TESScience/FPE/README.md

Focal Plane Electronics for TESS
--------------------------------

© 2015 John P. Doty &amp; Matthew P. Wampler-Doty, Noqsi Aerospace Ltd.



This project contains the design specification for the focal plane electronics for the [Transiting Exoplanet Survey Satellite (TESS)](http://space.mit.edu/TESS/TESS/TESS_Overview.html).

Documentation
-------------

You can read the latest documentation on our GitHub wiki:

[https://github.com/TESScience/FPE/wiki](https://github.com/TESScience/tessfpe/wiki)

This includes software tutorials and engineering manuals.

Provided that you have LaTeX, gschem and spice installed, you can reproduce the engineer manual by typing:

```bash
make manual
```
