TESScience/FPE/FPE/Simulation/Annex/README

Keep hacked simulation versions of schematics here.
