TESScience/FPE/FPE/Schematic/CCD-51pin.txt

# Connector for flexprint
#
#	Pin	Net	Name

J1	1	Backside-1	case
J1	2	IG1-1	IG1
J1	3	IG2-1	IG2	
J1	4	P1-OR-1	S1CD
J1	5	P2-OR-1	S2CD
J1	6	P3-OR-1	S3CD
J1	7	P1-U-1	S1U
J1	8	P2-U-1	S2U
J1	9	P3-U-1	S3U
# J1	10	nc
# J1	11	nc
# J1	12	nc
J1	13	P3-IA-1	IA3
J1	14	P2-IA-1	IA2
J1	15	P1-IA-1	IA1
# J1	16	nc
# J1	17	nc
# J1	18	nc
J1	19	GND	CS
J1	20	P3-OR-1	S3AB
J1	21	P2-OR-1	S2AB
J1	22	P1-OR-1	S1AB
J1	23	P3-FS-1	FS3
J1	24	P2-FS-1	FS2
J1	25	P1-FS-1	FS1
J1	26	VSUB-1	SUB
J1	27	ID-1	ID
J1	28	GND	RETD
J1	29	OG-D-1	OGD
J1	30	DR-D-1	DRD
J1	31	OUT-D-1	OSD
J1	32	GND	RTD78
J1	33	CuS-1	RTD56
J1	34	RD-1	RD
J1	35	OUT-C-1	OSC
J1	36	DR-C-1	DRC
J1	37	OG-C-1	OGC
J1	38	GND	RETC
J1	39	SCP-1	SCP
J1	40	GND	RETB
J1	41	OG-B-1	OGB
J1	42	DR-B-1	DRB
J1	43	OUT-B-1	OSB
J1	44	RG-1	RG
J1	45	CuS-1	RTD34	
J1	46	CuRTD-1	RTD12
J1	47	OUT-A-1	OSA
J1	48	DR-A-1	DRA
J1	49	OG-A-1	OGA
J1	50	GND	RETA
J1	51	SCP-1	USD
