TESScience/FPE/Releases/FPE-6.2-RR1/Interface.devfiles/chassis.txt

(Device File generated by gEDA Allegro Netlister)
PACKAGE CHASSIS
CLASS DISCRETE
PINCOUNT 1
END
