TESScience/FPE/Releases/FPE-6.1-RR4/Interface.pdf

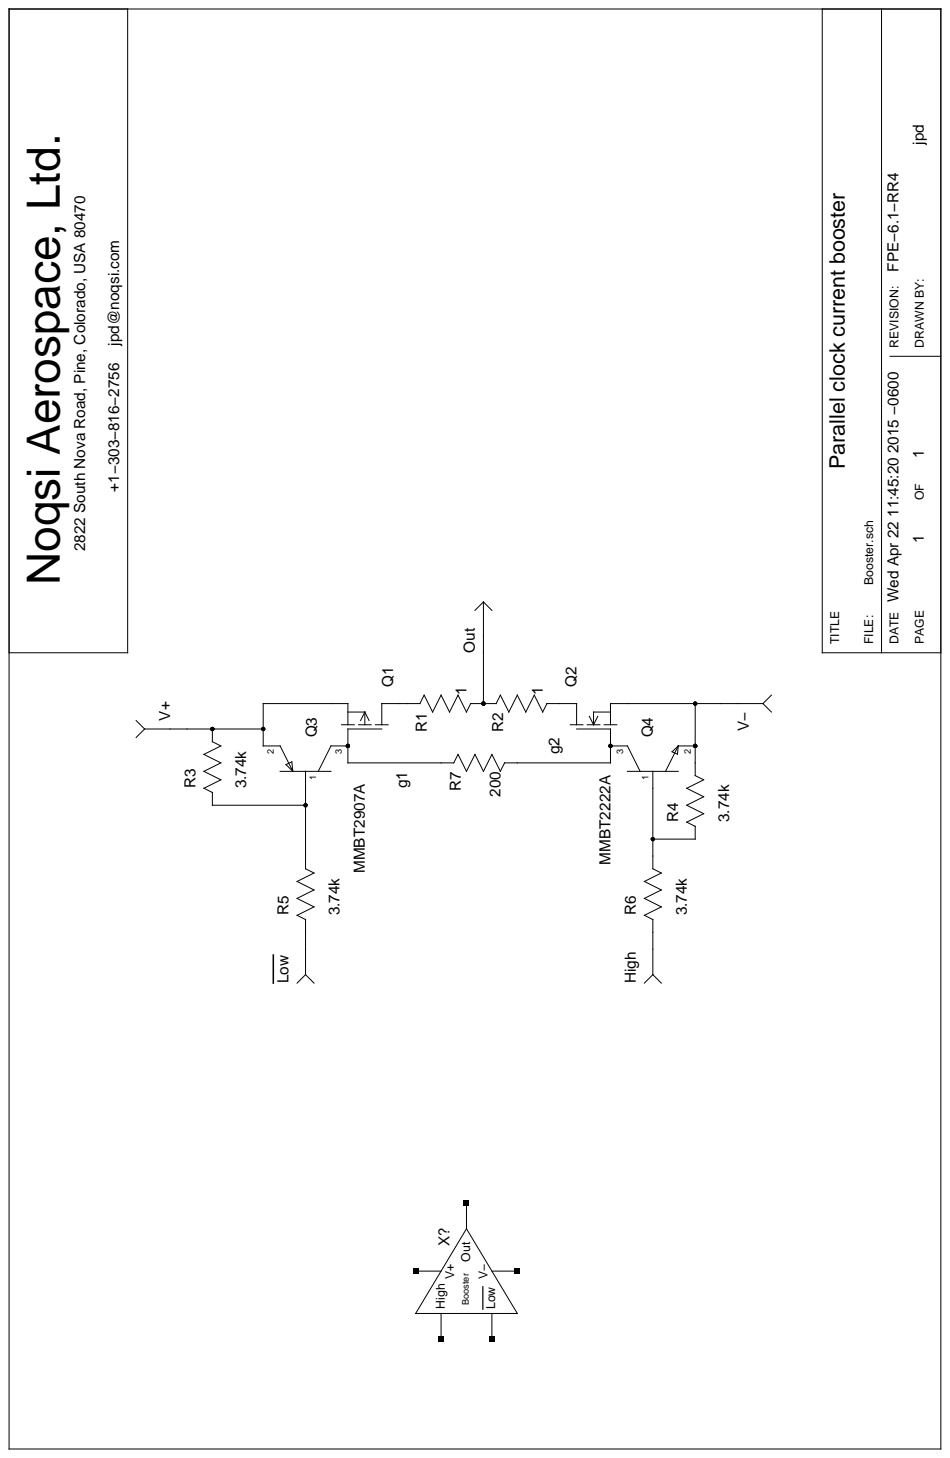
[picture p115: page 1]

2822 South Nova Road, Pine, Colorado, USA 80470

Parallel clock current booster

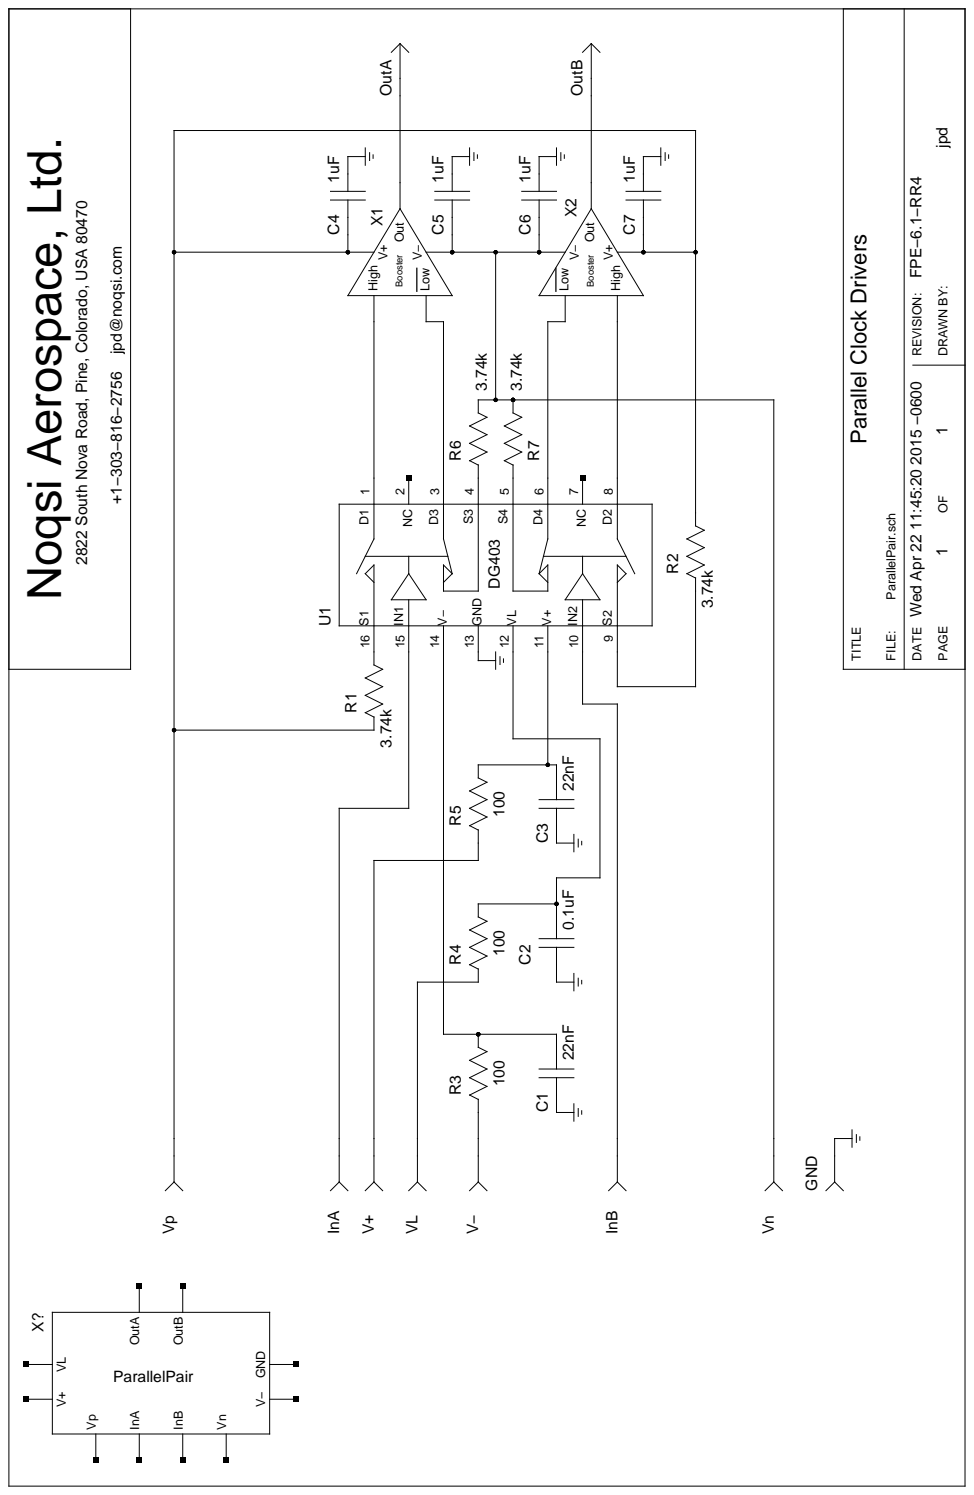
[picture p116: page 2]

2822 South Nova Road, Pine, Colorado, USA 80470

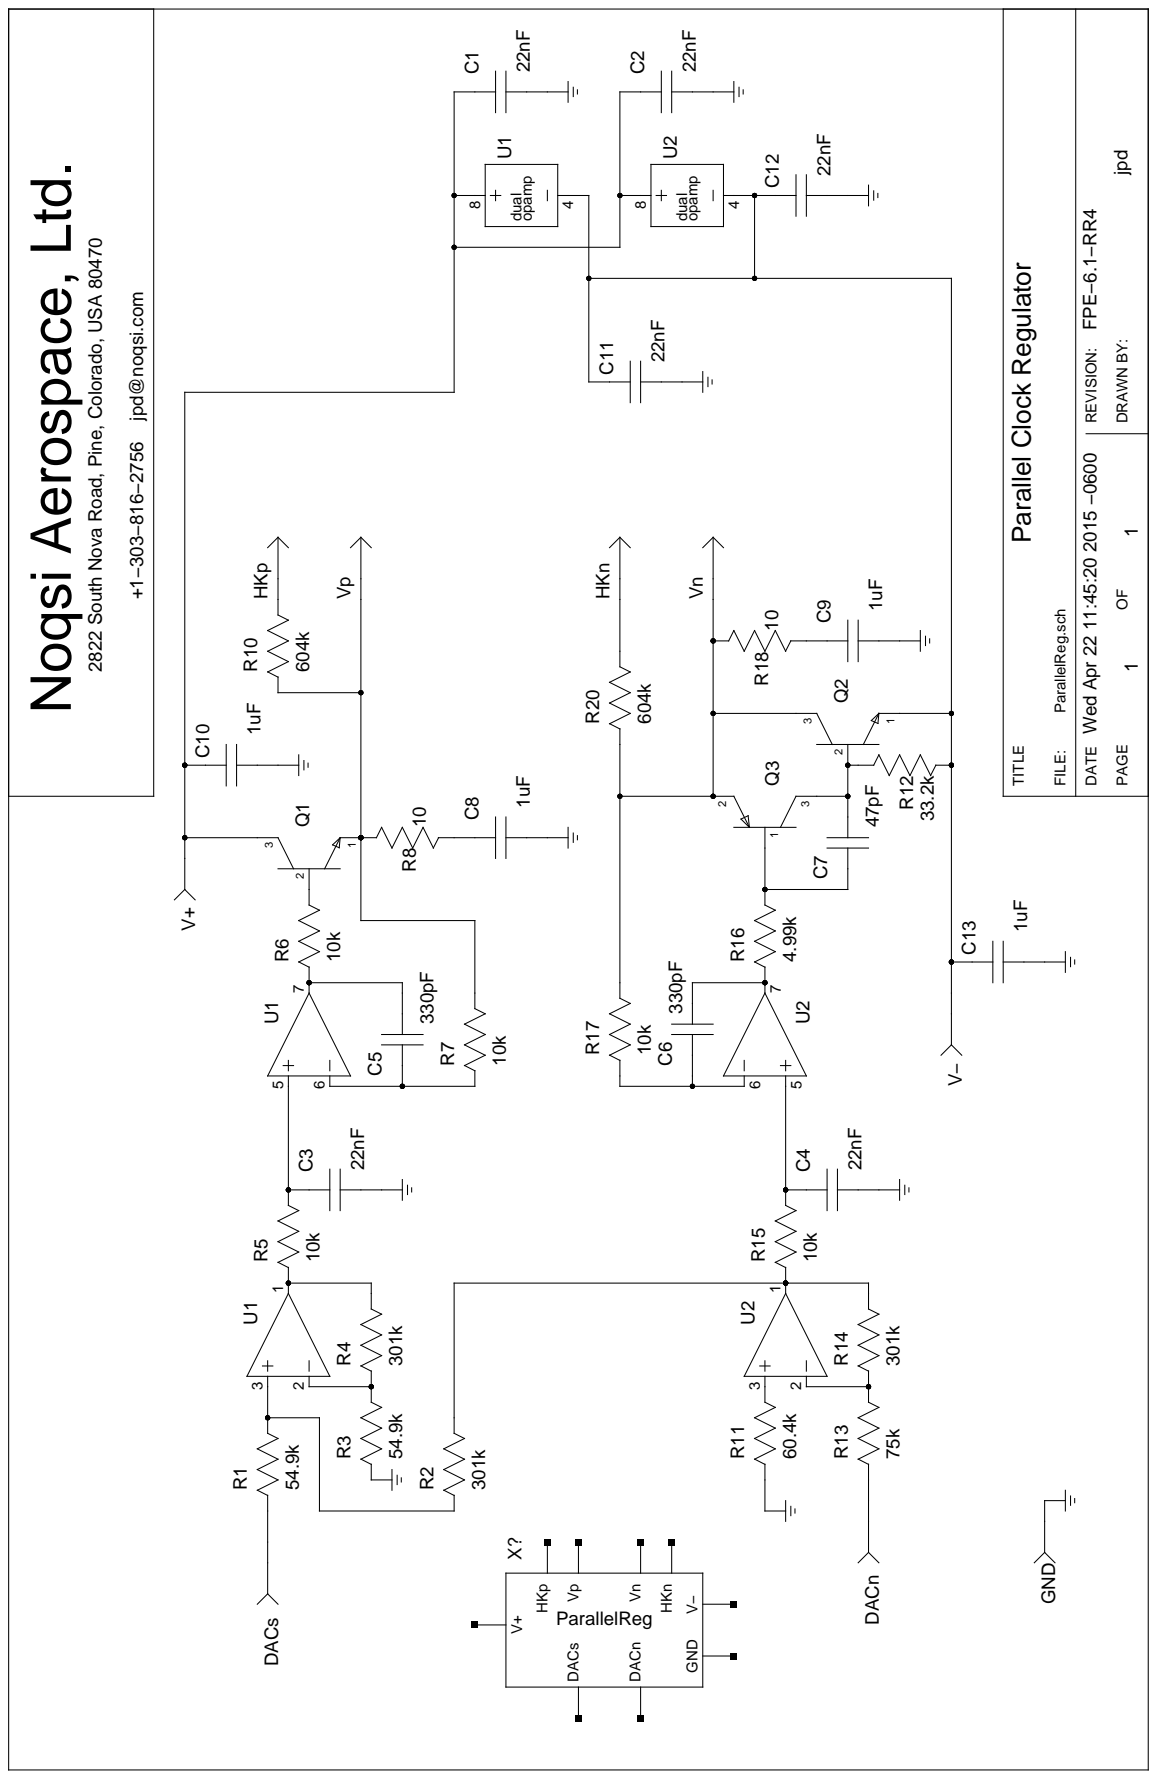
[picture p117: page 3]

2822 South Nova Road, Pine, Colorado, USA 80470

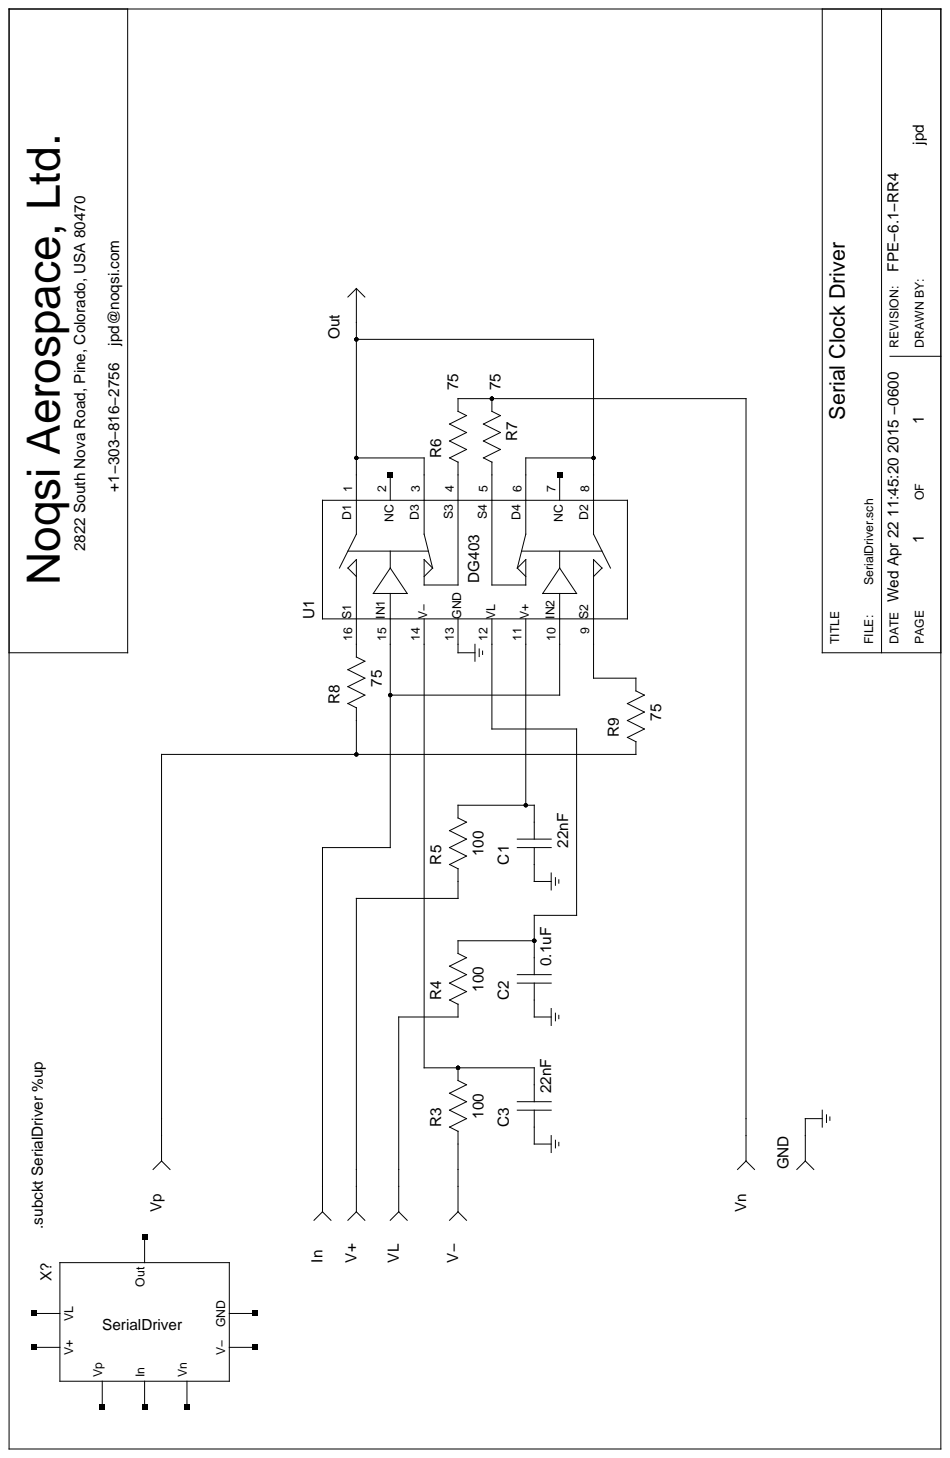
[picture p118: page 4]

2822 South Nova Road, Pine, Colorado, USA 80470

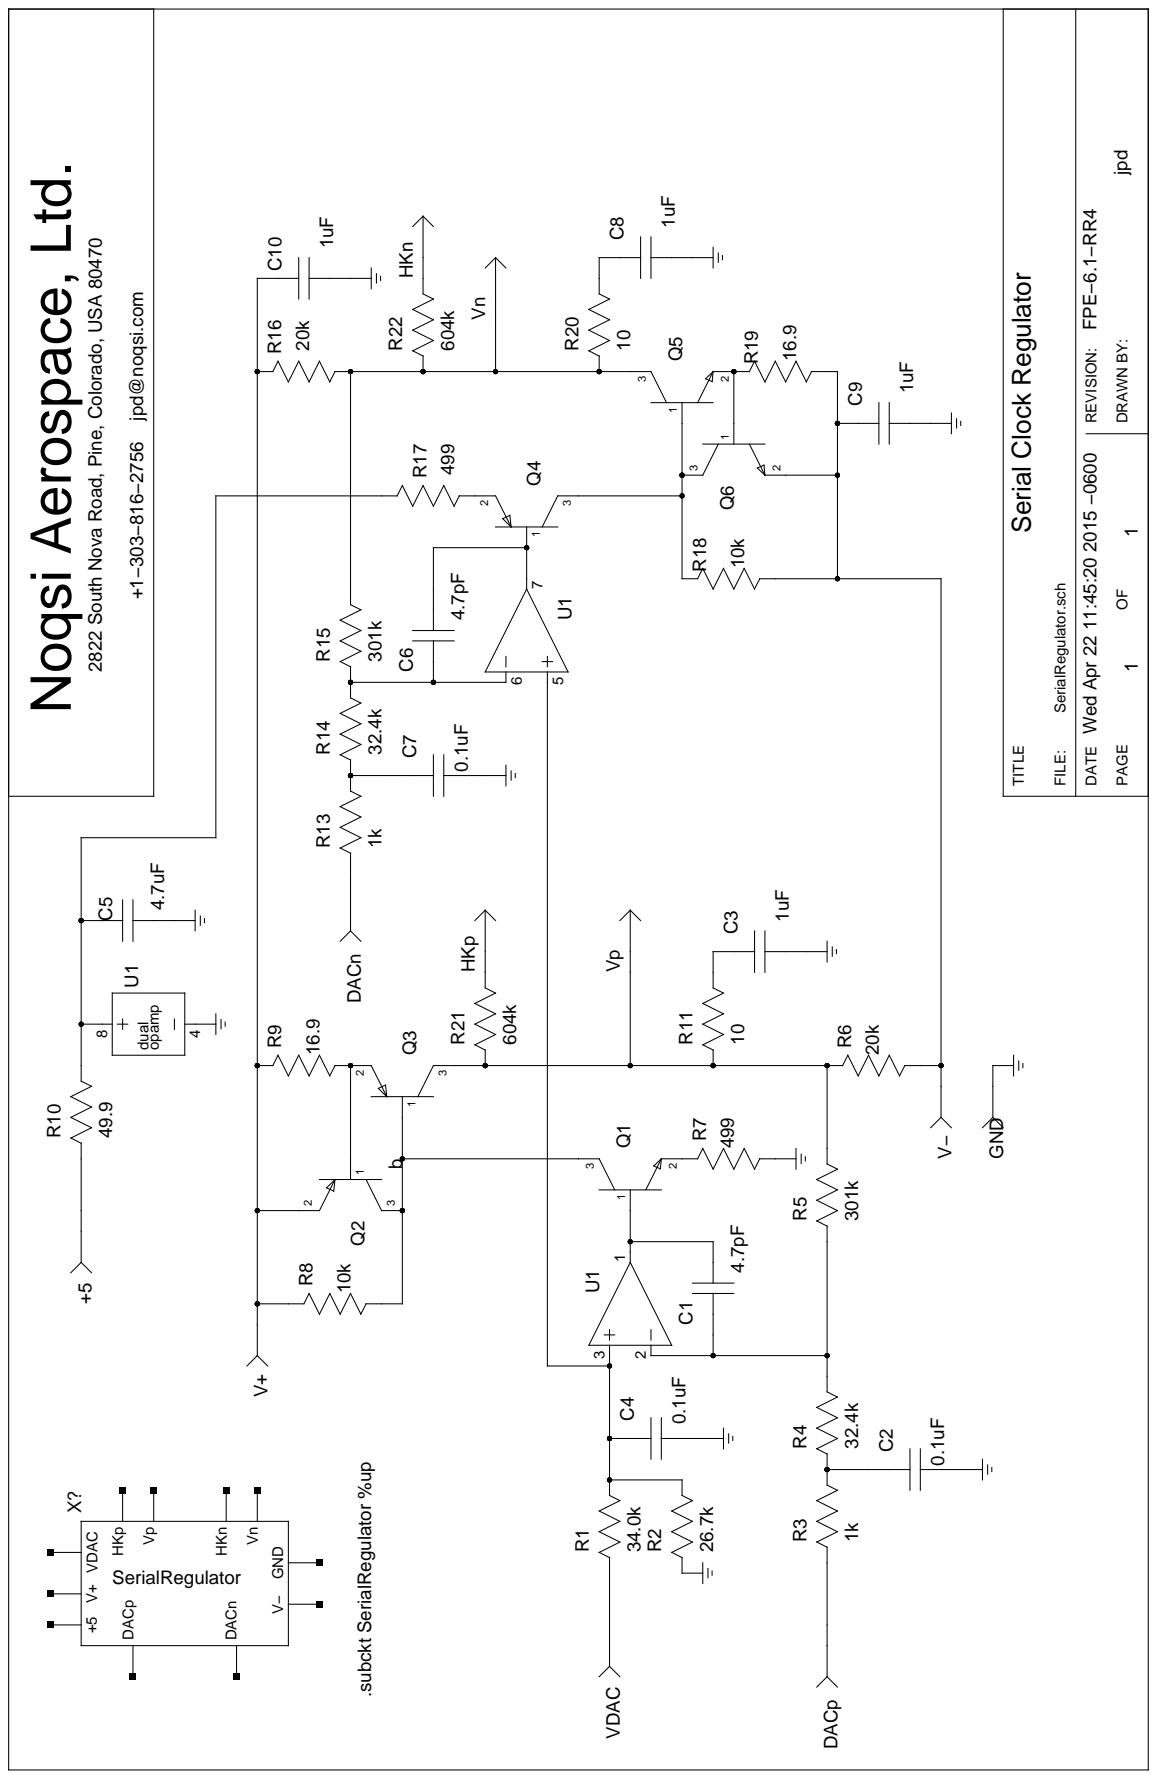
[picture p119: page 5]

2822 South Nova Road, Pine, Colorado, USA 80470

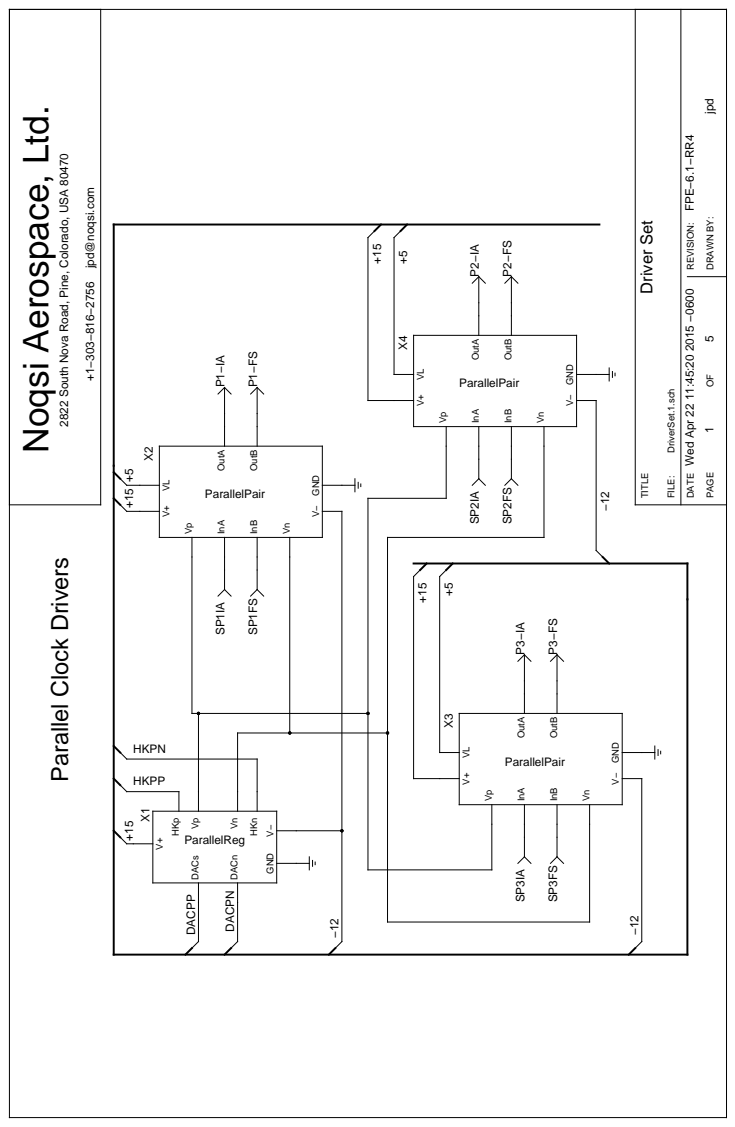
[picture p120: page 6]
FILE:; REVISION:; DRAWN BY:; TITLE; DATE; PAGE OF; jpd; DriverSet.1.sch; Driver Set; InA; InB; V− GND; OutA; ParallelPairOutB; Vp DACs; DACn Vn; HKp ParallelReg; HKn; DACPP; DACPN; HKPP; HKPN

Noqsi Aerospace, Ltd.

Wed Apr 22 11:45:20 2015 −0600 FPE−6.1−RR4

2822 South Nova Road, Pine, Colorado, USA 80470

+1−303−816−2756 jpd@noqsi.com

Parallel Clock Drivers

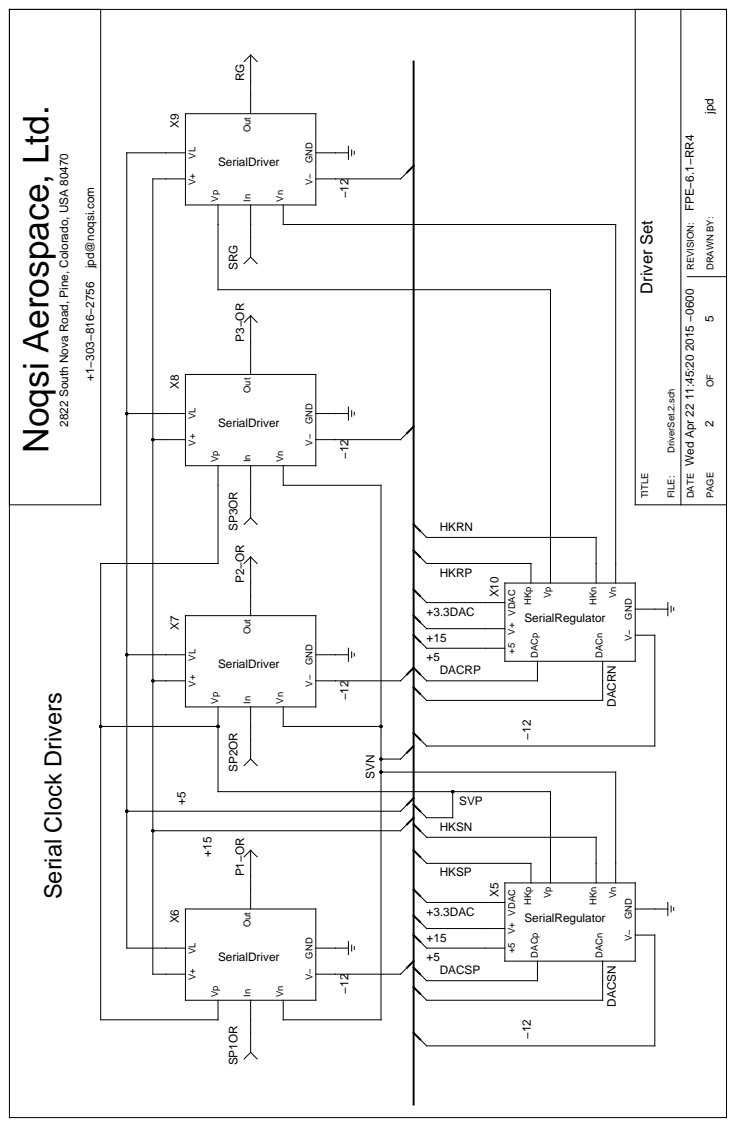
[picture p121: page 7]
FILE:; REVISION:; DRAWN BY:; TITLE; DATE; PAGE OF; jpd; DriverSet.2.sch; Driver Set; DACn; V+ VDAC; V− GND; DACp; SerialRegulator HKp; HKn; Out; SerialDriver; SVP; SVN; HKSP; HKSN; DACSP; DACSN; +3.3DAC; HKRP; HKRN; DACRP; DACRN

SRG P1−OR SP1OR SP2OR P2−OR SP3OR P3−OR RG

Noqsi Aerospace, Ltd.

Wed Apr 22 11:45:20 2015 −0600 FPE−6.1−RR4
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
