TESScience/FPE/(threads)

Thread 10 (2015-12-30):

Script needed: Read housekeeping with no frames running

ebokhour, 2015-12-30:
This script should obtain a full set of housekeeping data and output them in a standard format, in engineering units.  This script is intended to capture HK data without any frames running.  The output values should be compared to a reference set.

Note: This script will be used for Bring-Up and Functional testing of the FPE boards, thus it will be run in situations where the Interface Board is not mated with any other boards, and when only the Driver board is mated, and when all three boards in the stack are mated together.  We should consider providing three reference sets of HK data to cover all three cases.  There may be other cases, too, not yet defined.

xcthulhu, 2016-02-08:
Done

Closed 2016-02-08.

Thread 11 (2015-12-30):

Script needed: Read housekeeping with frames running

ebokhour, 2015-12-30:
This script should obtain a full set of housekeeping data and output them in a standard format, in engineering units. This script is intended to capture HK data *with* frames running. The output values should be compared to a reference set.

Note: This script will be used for Functional testing of the FPE stack, thus it will be run in situations where the Interface, Driver, and Video boards are mated together.

This script can either retrieve HK data from the frames (FITS files) as they arrive from the ObsSim, or in some more direct fashion, if the Python package supports it.

NOTE however, that the main goal of tests running this script will be to evaluate whether HK data is being affected by the action of the frames running, as compared with obtaining the same data without frames running.  Thus, whichever method is used, it must accurately reflect the housekeeping data the science operations team will receive when TESS is operational.

jimlittlefield, 2016-02-25:
It would be possible to extend the ObsSim software to support a mode (hk_only) where frames are running,  housekeeping is transmitted,  but the pixel data udp packets are not.    This would make the data rate low enough to easily receive/process hk from python.    The risk of adding this is, of course, that the feature may be activated by accident and a user will be expecting pixels but only see hk.

Thread 12 (2015-12-30):

Script needed: Check the HK bias error

ebokhour, 2015-12-30:
This script should obtain HK data from those inputs which do not have any signal connected.  Thus the values obtained will provide calibration information on the bias error associated with all the HK channels.

It should be determined what, if anything, should be done with this calibration information.  Tests on 6.1 hardware indicate the bias error will be vanishingly small, and so this test would become simply verification that any specific board is performing similarly.

ebokhour, 2015-12-30:
A functioning version of this exists as an iPython notebook at
https://github.com/TESScience/FPE_Test_Procedures/blob/master/John%20Doty's%20Global%20Calibration%20of%20the%20Housekeeping%20Data%20Collection.ipynb

xcthulhu, 2016-01-25:
This is done in the following script: https://github.com/TESScience/FPE/blob/master/scripts/bias_test

ebokhour, 2016-01-28:
The bias_test only outputs the power supply readings.  This is a very useful subset of values, but it's not what the bias test is supposed to report.  It should report the list of standard deviations for all the HK readings.  Might be useful to make the power supply readings a separate script, but that's a discussion for another thread.

xcthulhu, 2016-01-28:
How do I know if a channel is unused?

ebokhour, 2016-01-28:
Sorry - I was unclear because I was thinking of 6.1.  In 6.2 and 7.0 there is a signal in the Heater Group called HK Bias.  That's the one we need to measure. I referred to it as 'unused' because there is literally nothing wired to it. But we will use it to measure the input bias, which turns out to apply to all the housekeeping signals except the temperatures.  It should read a small number of uA.  When we did this in Jupyter we averaged 50 readings.  We need to make sure the value is small for each board we test.

Thread 17 (2015-12-30):

Scripts needed: Starting and Stopping Frames, Resetting the FPGA

ebokhour, 2015-12-30:
Consider providing short scripts which allow starting and stopping frames, as well as resetting the FPGA.  These commands could be issued via netcat, but running them directly from the terminal as python scripts (without setting up netcat) may be more convenient.

Thread 19 (2015-12-30):

Scripts needed: Calibrate the trim heater outputs

ebokhour, 2015-12-30:
This script should set the trim heater currents over their full range and plot the associated HK values.  Calibration values should be retained for use by (TBD).

ebokhour, 2015-12-30:
A functioning version of this exists as an iPython notebook at
https://github.com/TESScience/FPE_Test_Procedures/blob/master/Heater%20Calibration%20Tests.ipynb

Closed 2016-04-03.

Thread 21 (2015-12-30):

Script needed: Capture frames and compare to reference

ebokhour, 2015-12-30:
This script should capture reference frames and compare them to reference frames.  The reference frames should take into account the condition of the stack, i.e. whether there is only an Interface, an Interface/Driver, or the full Interface/Driver/Video stack.

ebokhour, 2015-12-30:
Nominally, this script would not be used with CCDs connected.  It may be useful also to have reference frames for when CCD's are connected, however the comparison may get complicated due to potential differences in CCD temperature, optical environment, and even the CCDs themselves.  But the script can be run without regard for these differences, if desired.

Thread 26 (2016-02-12):

Sequencer and MemFile Tool

ebokhour, 2016-02-12:
Finalize the software tool which generates files for the sequencer, program, DAC, and HK memories.
Question: Are register memory files created with this tool?  If not, then how are those generated and config controlled?

xcthulhu, 2016-02-19:
I don't want users to upload these files themselves, they can easily break the system and require a reset if they screw this up.  Especially if they try loading the wrapper twice.

I am not going to provide interfaces to these.

Closed 2016-02-19.

Thread 32 (2016-02-23):

house_keeping script turns on Heater 1

ebokhour, 2016-02-23:
When running the house_keeping script, after loading the 6.1.5 wrapper on a 6.1 stack, the heater current value for Heater 1 was seen to be 255.9 mA, and the heater 1 dummy load resistor was extremely hot.

ebokhour, 2016-02-23:
After a power cycle of the system, this problem could not be recreated. I will monitor during upcoming testing.
