TESScience/FPE/Releases/FPE-6.2-RR3/FPE.pdf

# TESS Focal Plane Electronics Manual

John P. Doty | Matthew P. Wampler-Doty

### Wed Sep 30 10:42:50 2015 -0400

Engineering Model Edition

Version FPE-6.2-RR3

1

CONTENTS | 1

## Contents

1 Introduction | 5
2 Video Board | 5
3 Interface Board | 33
4 Driver Board | 66
5 Stack Interconnection | 70
6 Operating Parameters and Housekeeping Channels | 72

LIST OF FIGURES | 2

## List of Figures

LIST OF TABLES | 3
29 | DriverSet.3 | 44
30 | DriverSet.4 | 45
31 | DriverSet.5 | 46
32 | ArtixPower | 48
33 | Interface.1 | 57
34 | Interface.2 | 59
35 | Interface.3 | 60
36 | Interface.4 | 61
37 | Interface.5 | 62
38 | Interface.6 | 63
39 | Interface.7 | 65
40 | Driver.1 | 67
41 | Driver.2 | 68
42 | Driver.3 | 69

## List of Tables

1 | Flexprint Connector | 31
1 | Flexprint Connector (continued) | 32
2 | Temperature Connector | 33
3 | FPGA Test Header | 49
4 | Artix FPGA Connections | 49
4 | Artix FPGA Connections (continued) | 50
4 | Artix FPGA Connections (continued) | 51
4 | Artix FPGA Connections (continued) | 52
4 | Artix FPGA Connections (continued) | 53
4 | Artix FPGA Connections (continued) | 54
4 | Artix FPGA Connections (continued) | 55
4 | Artix FPGA Connections (continued) | 56
5 | Inter-board Stack Connections | 70

LIST OF TABLES | 4

1 INTRODUCTION | 5

## 1 Introduction

The TESS Focal Plane Electronics (FPE) serve as the intermediary between the four CCD sensors on a focal plane and the Data Handling Unit (DHU). Three boards make up a full FPE assembly: Video (§2), Interface (§3), and Driver (§4). The boards are connected by a 200 pin bus implemented with stacking connectors.

Each CCD has independent clock and bias level controls. This makes the FPE robust against short-circuit failure of a CCD: in that case setting clock levels to zero will minimize fault current. Each CCD also has independent parallel clock timing to enable staggered frame store operations. This helps with the trade-off between the need to minimize the power surge due to the rapid clocking of high capacitance gates during transfer and the desire to minimize streaking by clocking as rapidly as possible. Timing of other CCD clocks is synchronous among the four CCDs.

The Driver board is not strictly necessary in a testing environment. Without the Driver board, CCD 1 and CCD 2 are fully functional. The driver board supplies clocks for CCD 3 and CCD
4. A passive jumper board that connected CCD 1 clocks to CCD 3 and CCD 2 clocks to CCD 4

of clock timing and voltages.; 2 Video Board; Deintegrate; Integrate; Clamp; Sample; Reset; Charge Transfer; Figure 1: Video Signal From CCD

would allow operation of four CCDs without a driver board, but without as much independence

### 2.1 Input and Signal Processing Strategy

Figure 1 shows voltage versus time for a typical CCD video signal. The reset pulse resets the output node to a reference voltage that is approximately constant. However, that voltage is relatively large

2 VIDEO BOARD | 6

(10–15V) and somewhat uncertain due to switching (“kTC”) noise. Then, we transfer electrons into the output node, resulting in a negative voltage step proportional to the charge.

We measure the height of the step with a three-stage process. First, we couple the signal into our measurement chains through a capacitor. On the output side of the capacitor, we have a “clamp”: a switch that forces the signal to a more reasonable level (about 3V for TESS). After we release the clamp, we “deintegrate”, averaging the baseline level before charge transfer. After charge transfer, we “integrate”, averaging the level after charge transfer. The difference in the averages is our best estimate the height of the step. We sample that difference and digitize it. In CCD jargon, this is “correlated double sampling”. Our approach combines the common “clamp/sample” and “Dual slope” approaches.

### 2.2 Building blocks

### 2.2.1 The Video Measurement Chain

Figure 2 shows the signal path through the measurement chain. Q2 is the active current load for the CCD output. R1 controls the current. As shown, it sinks ≈ 0.8 mA.

U3 is the clamp. U4 buffers the clamped video. R7, R8, and C18 control the buffer gain: for maximum dynamic range we will use unity gain. U8 is the integrator that performs the signal averaging. U11 and U12 switch its inputs to control the sign of the the input signal for the deintegrate and integrate phases.

U5 inverts the video signal, so the input to the integrator is positive during the integrate phase. It also attenuates the signal slightly to achieve greater dynamic range. R11 is reduced relative to R38 to compensate for this attenuation, keeping the correlated double sampling balanced.

U9, the ADC, uses a differential input. U6 inverts the integrator output to provide this. Filters R14/C20 and R13/C21 provide some anti-aliasing, limiting the effect of broadband noise at the outputs of U6 and U8. The ADC does not work well for a rapidly slewing input: U11 and U12 should both be off for an adequate time to allow the ADC inputs to settle before the ADC samples.

R25 feeds a current proportional to the CCD output voltage to the housekeeping circuitry for monitoring the DC component. R41 prevents the voltage on the line from exceeding the limit of the housekeeping multiplexor.

C4 should be a low hysteresis capacitor, not a common NP0. It’s split because commercial capacitors of this type are difficult to obtain for values > 100 pF. For flight, this may be a single capacitor.

Figure 3 shows the support circuitry for the measurement chain. U10 provides local voltage regulation.

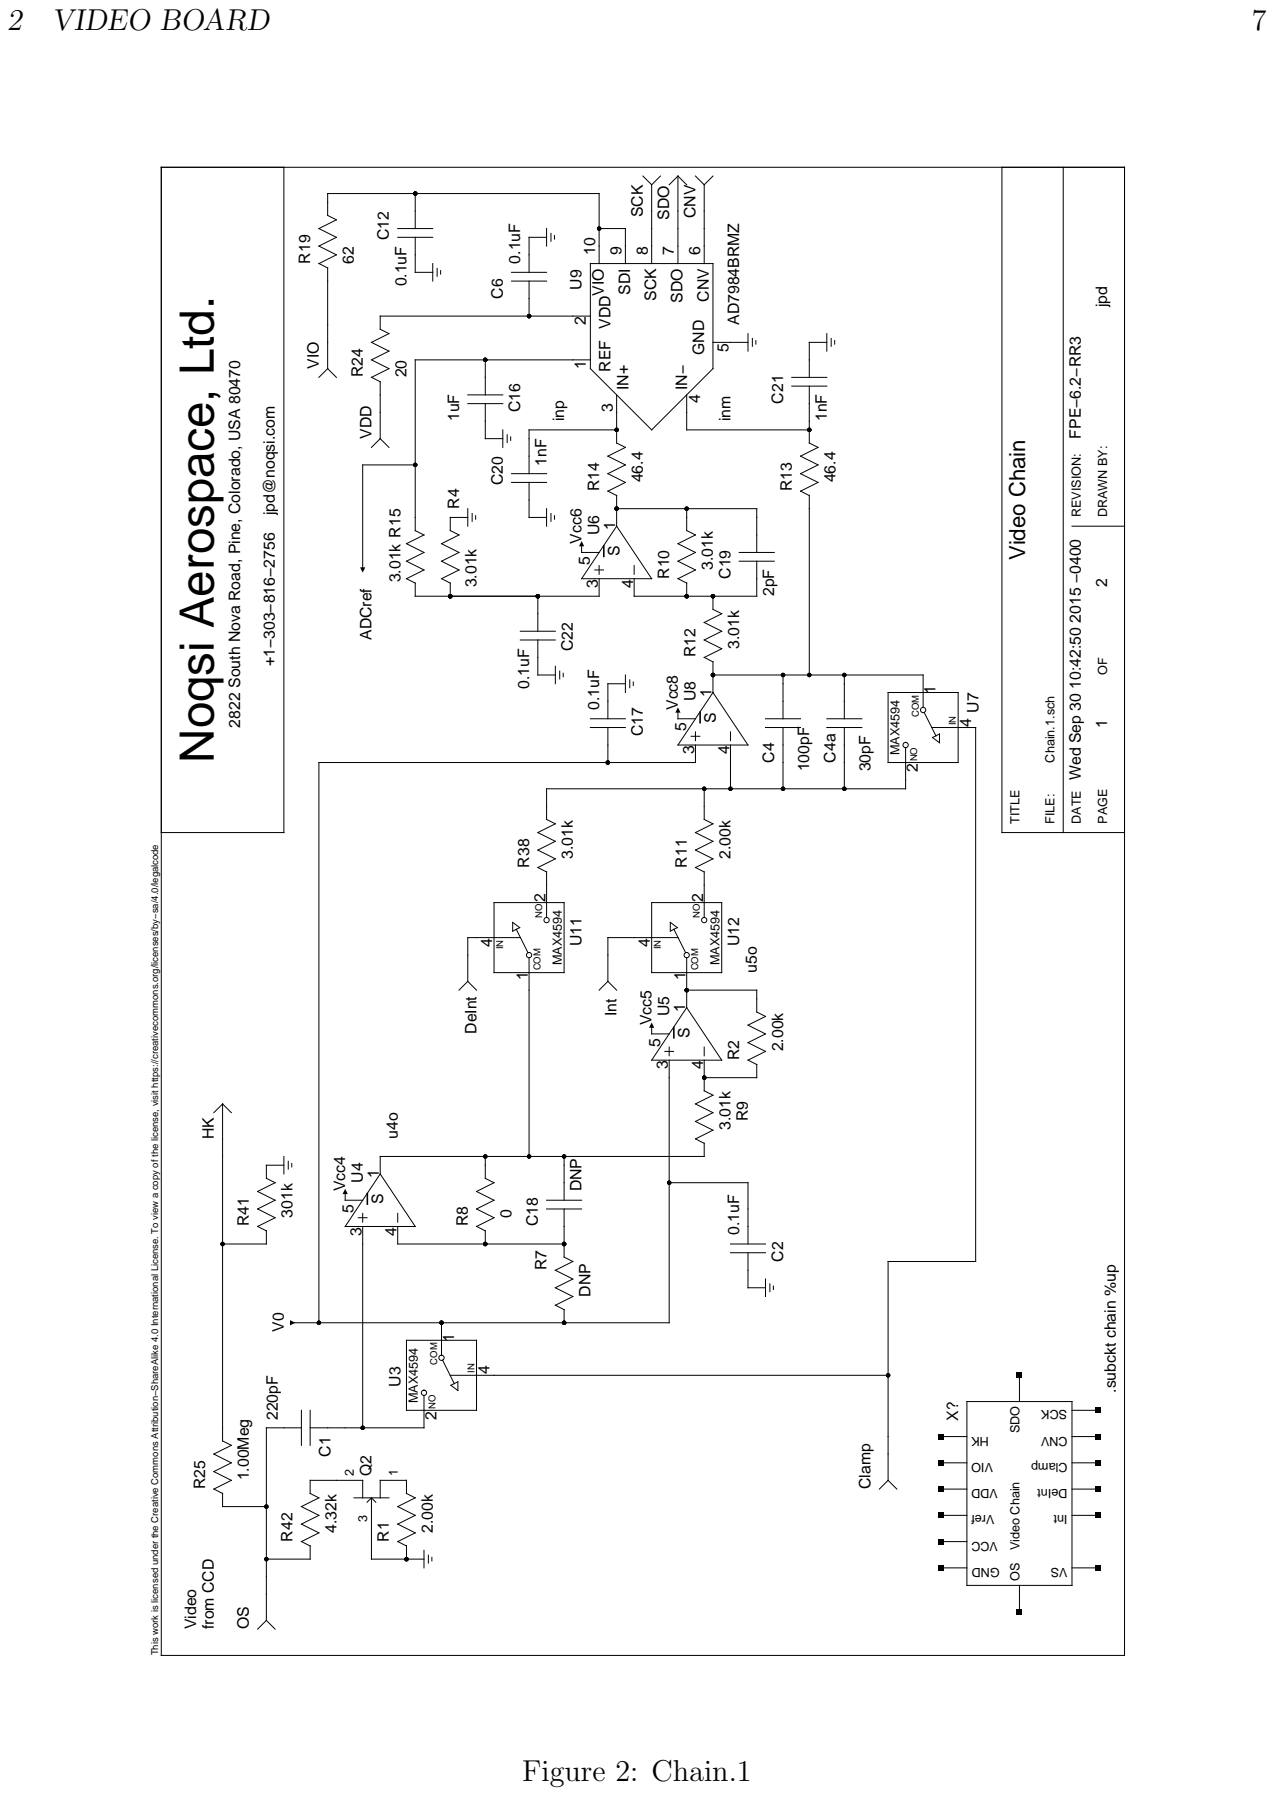
[picture p184: page 8]

2822 South Nova Road, Pine, Colorado, USA 80470

This work is licensed under the Creative Commons Attribution−ShareAlike 4.0 International License. To view a copy of the license, visit https://creativecommons.org/licenses/by−sa/4.0/legalcode

SDO Video Chain HK VDD DeInt

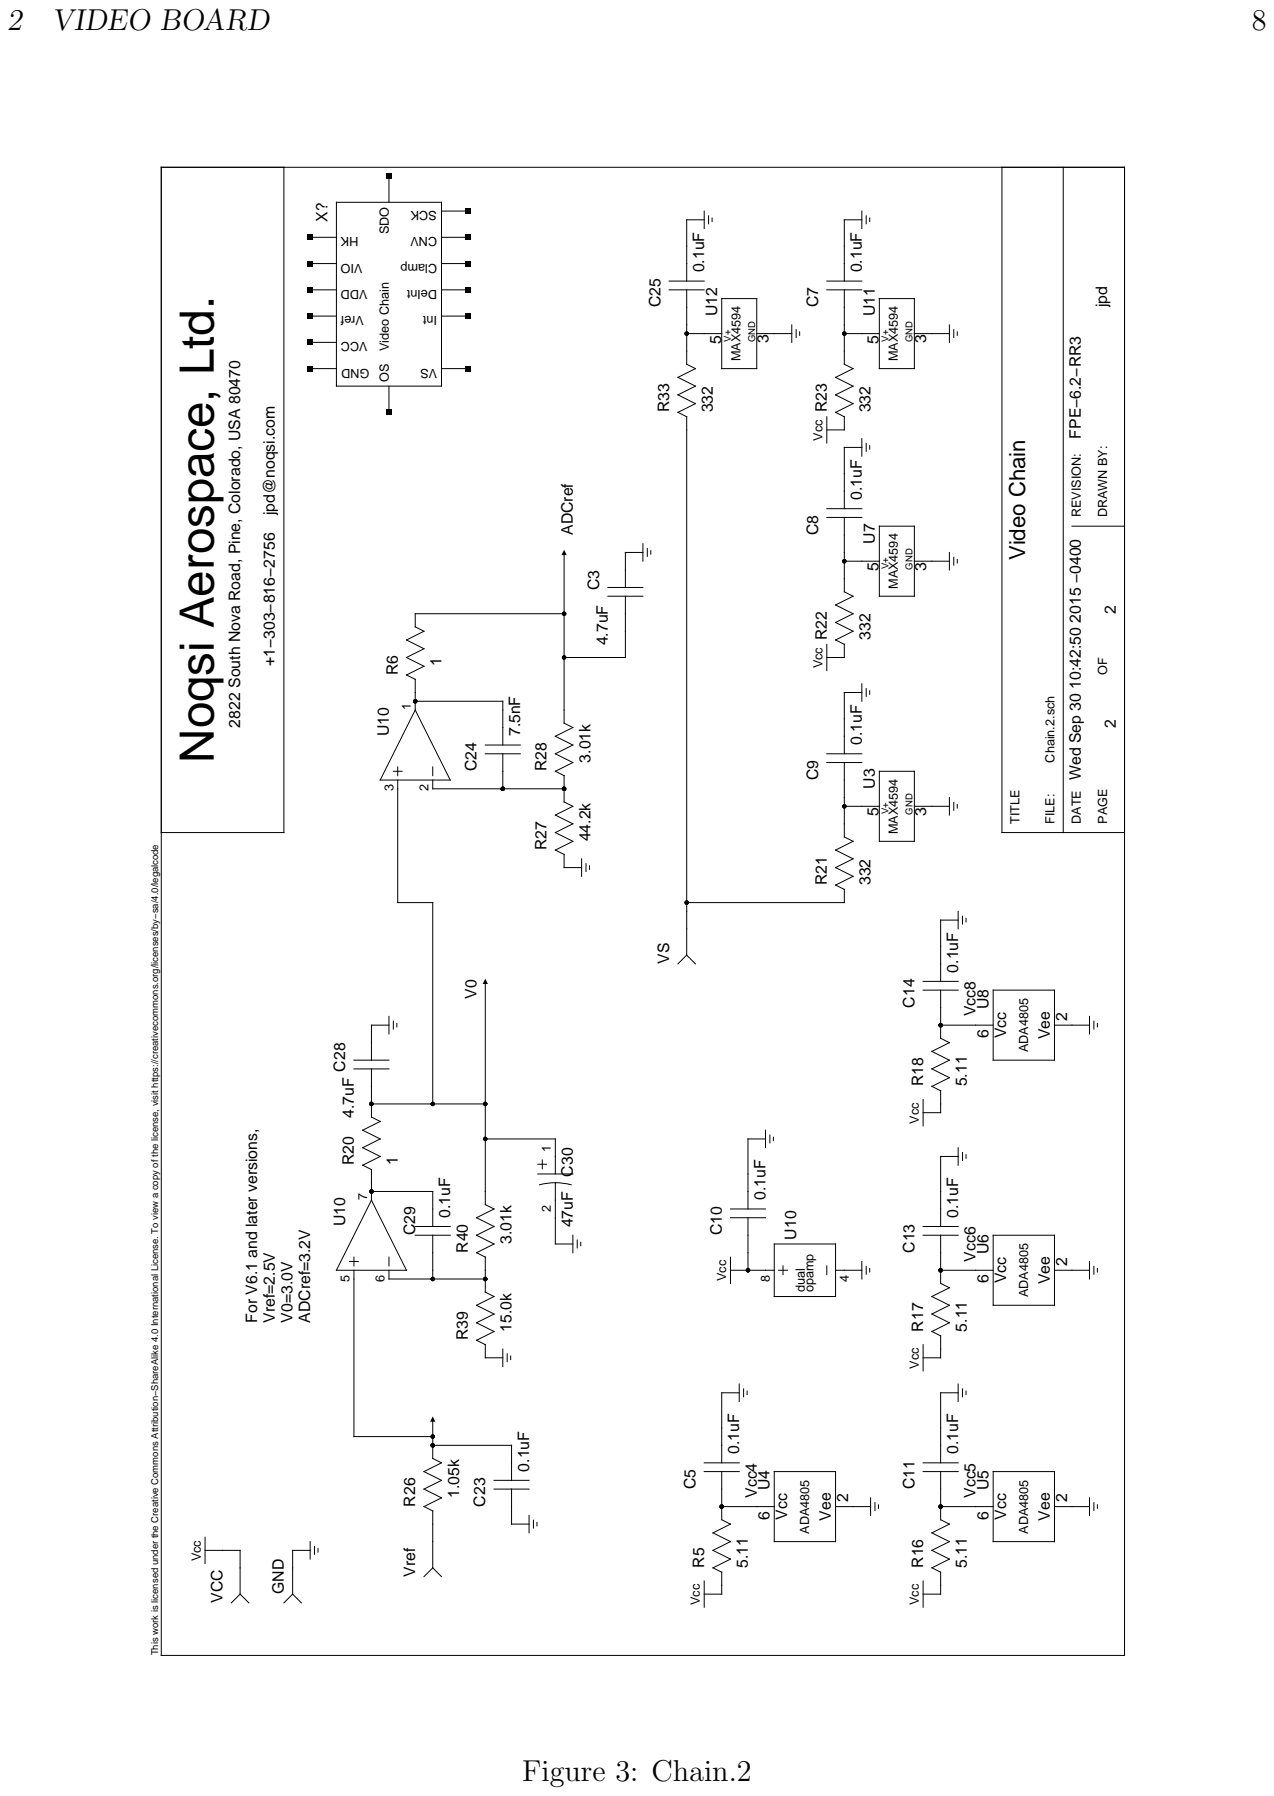
[picture p185: page 9]

SDO Video Chain HK VDD DeInt

2822 South Nova Road, Pine, Colorado, USA 80470

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

For V6.1 and later versions,

2 VIDEO BOARD | 9

### 2.2.2 Drain Regulator

To protect the CCD charge sense MOSFET from overvoltage, the output drain voltage range is controlled relative to the CCD reset drain. Since the reset drain voltage controls the gate voltage on the sense MOSFET, limiting the difference to 10V limits the gate-drain voltage (see CCID80 data sheet).

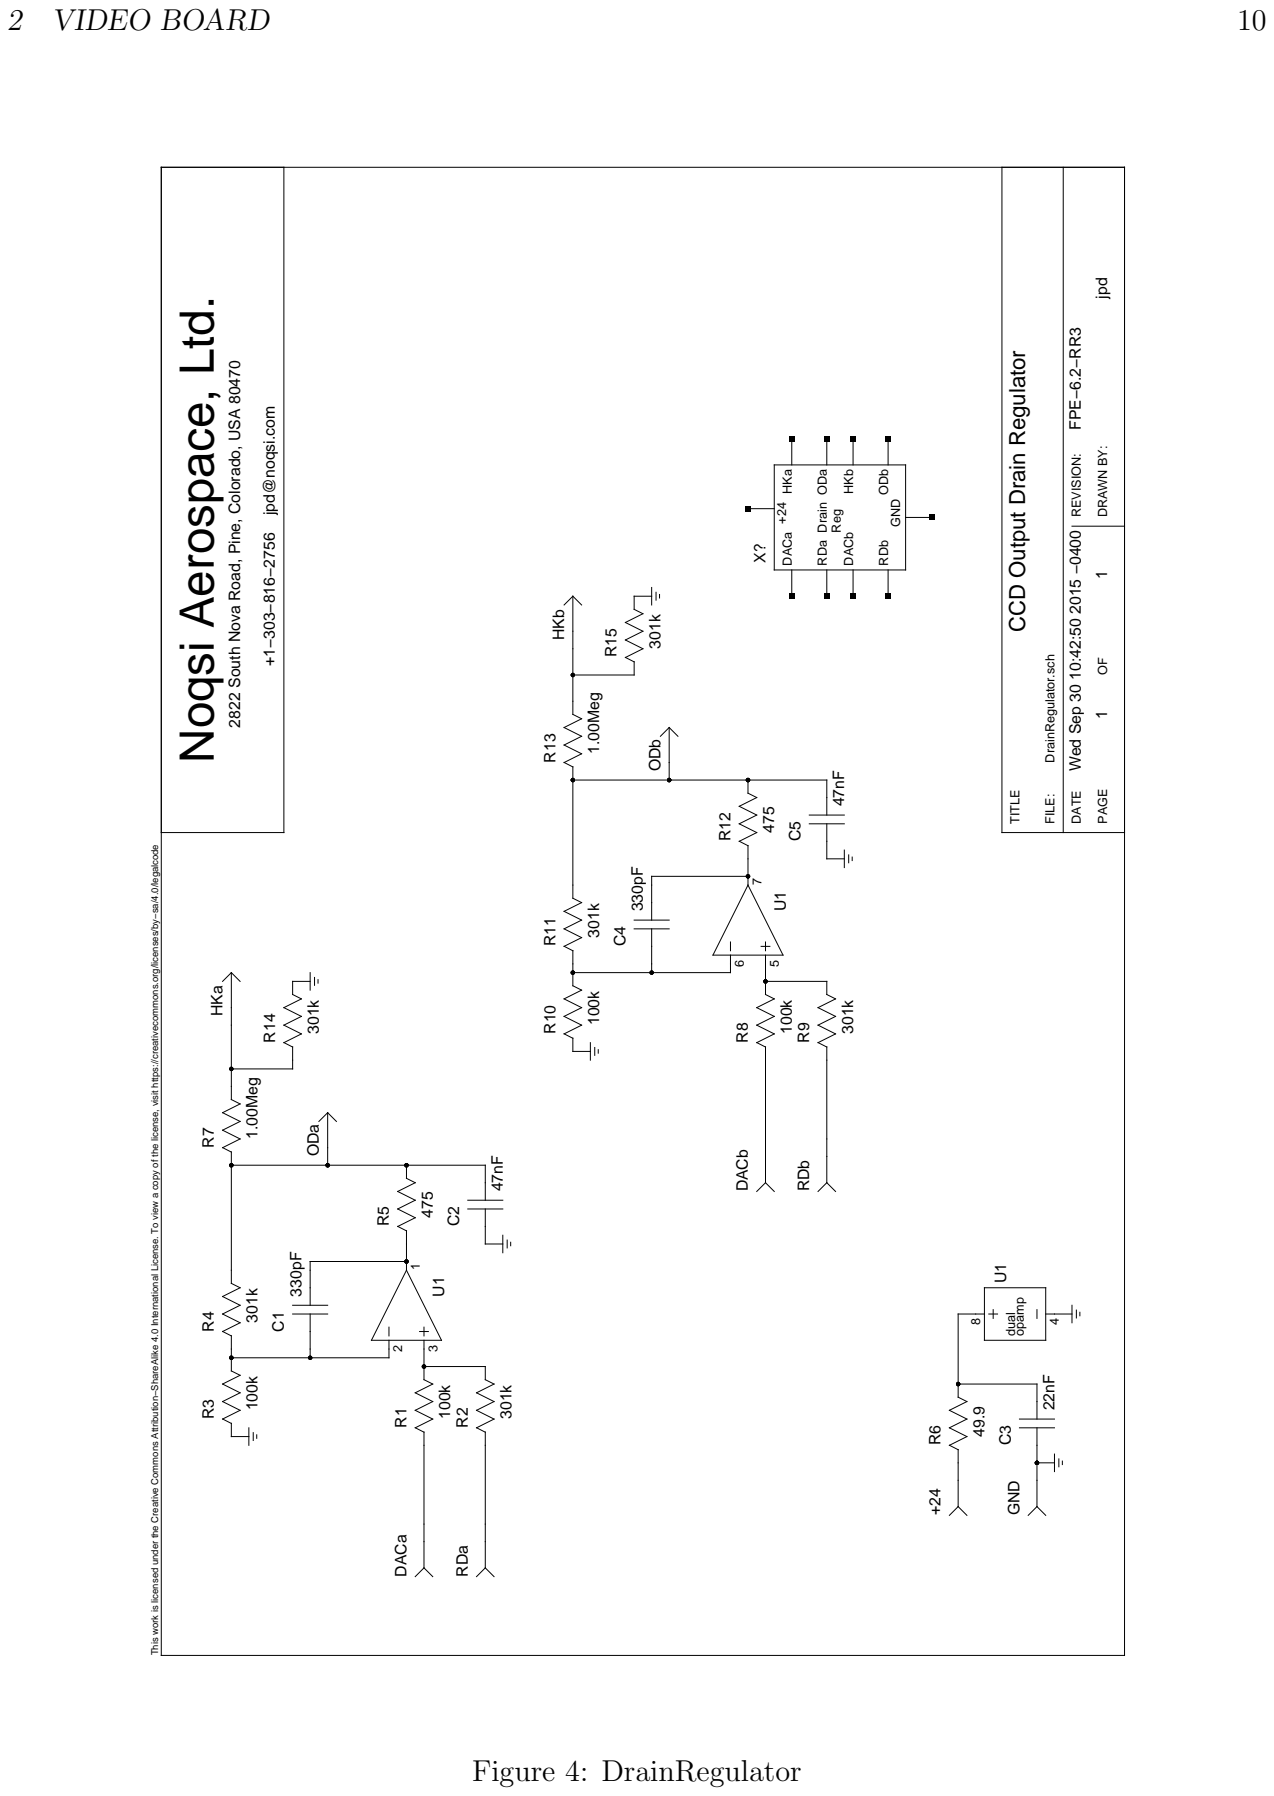
[picture p186: page 11]

2822 South Nova Road, Pine, Colorado, USA 80470

CCD Output Drain Regulator

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

2 VIDEO BOARD | 11

### 2.2.3 Per-Chip Circuitry

Most of the Video board consists of four blocks devoted to per-chip video processing and operating bias generation. In each block, there is a video measurement chain for each segment (Figure 5). Figure 6 shows local fixed voltage regulation and the variable output gate regulator. Figures 7–10 show regulators for other variable CCD biases. Figures 11 and 12 show the DACs and housekeeping multiplexors that support these functions, as tabulated in Table 7 in Section 6.

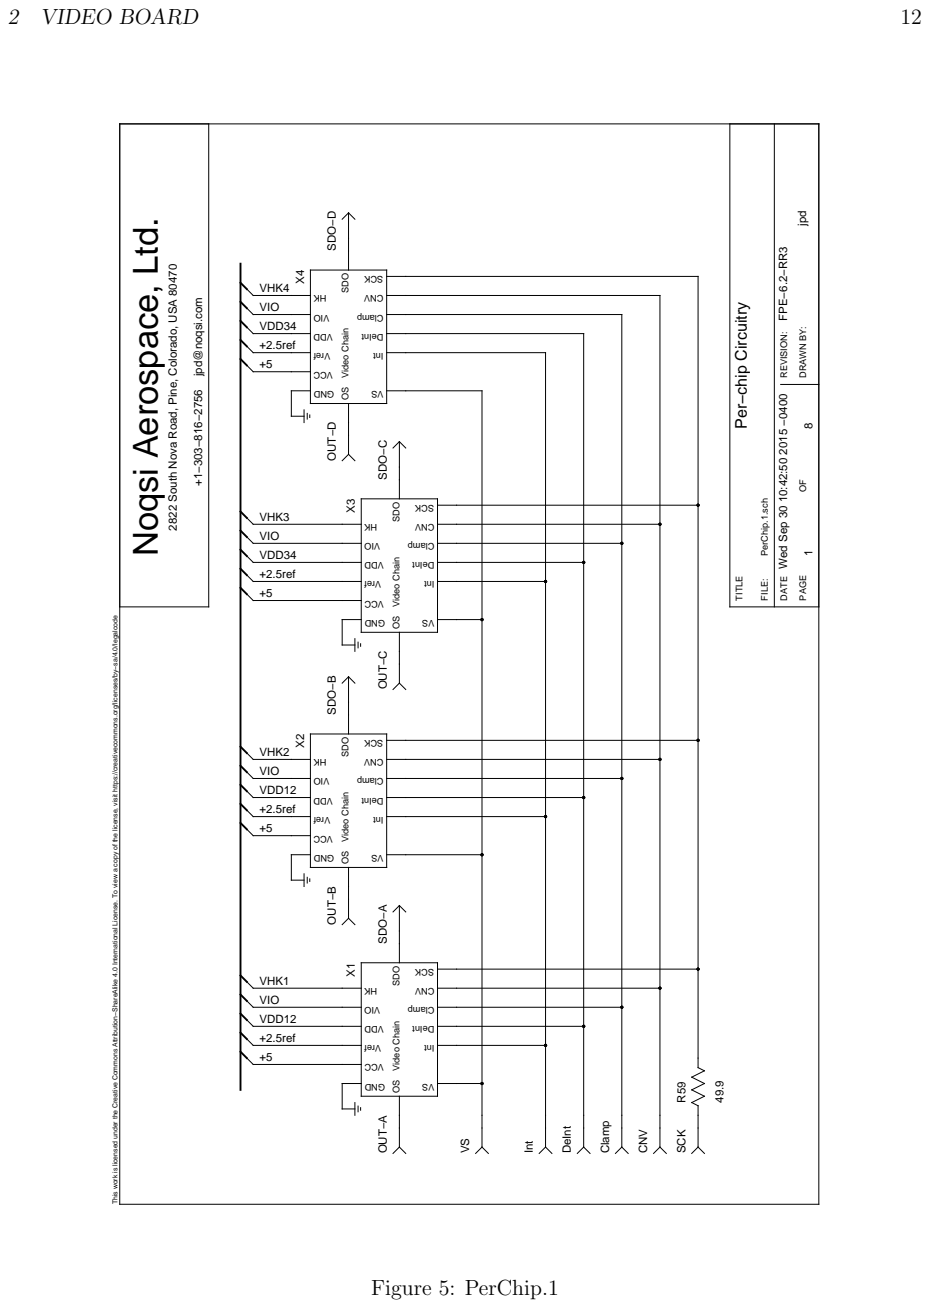
[picture p187: page 13]
2 VIDEO BOARD; FILE:; REVISION:; DRAWN BY:; TITLE; DATE; PAGE OF; jpd; PerChip.1.sch; OSGND; OUT−A SDO−A; OUT−B SDO−B; OUT−C SDO−C; OUT−D SDO−D; +2.5ref; VIO; VHK1; VHK2; VHK3; VHK4; Int; DeInt; Clamp; CNV; SCK; VDD34; VDD12; Figure 5: PerChip.1

Noqsi Aerospace, Ltd.

Wed Sep 30 10:42:50 2015 −0400 FPE−6.2−RR3

2822 South Nova Road, Pine, Colorado, USA 80470

SDO Video Chain HK VDD DeInt

+1−303−816−2756 jpd@noqsi.com

Per−chip Circuitry

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

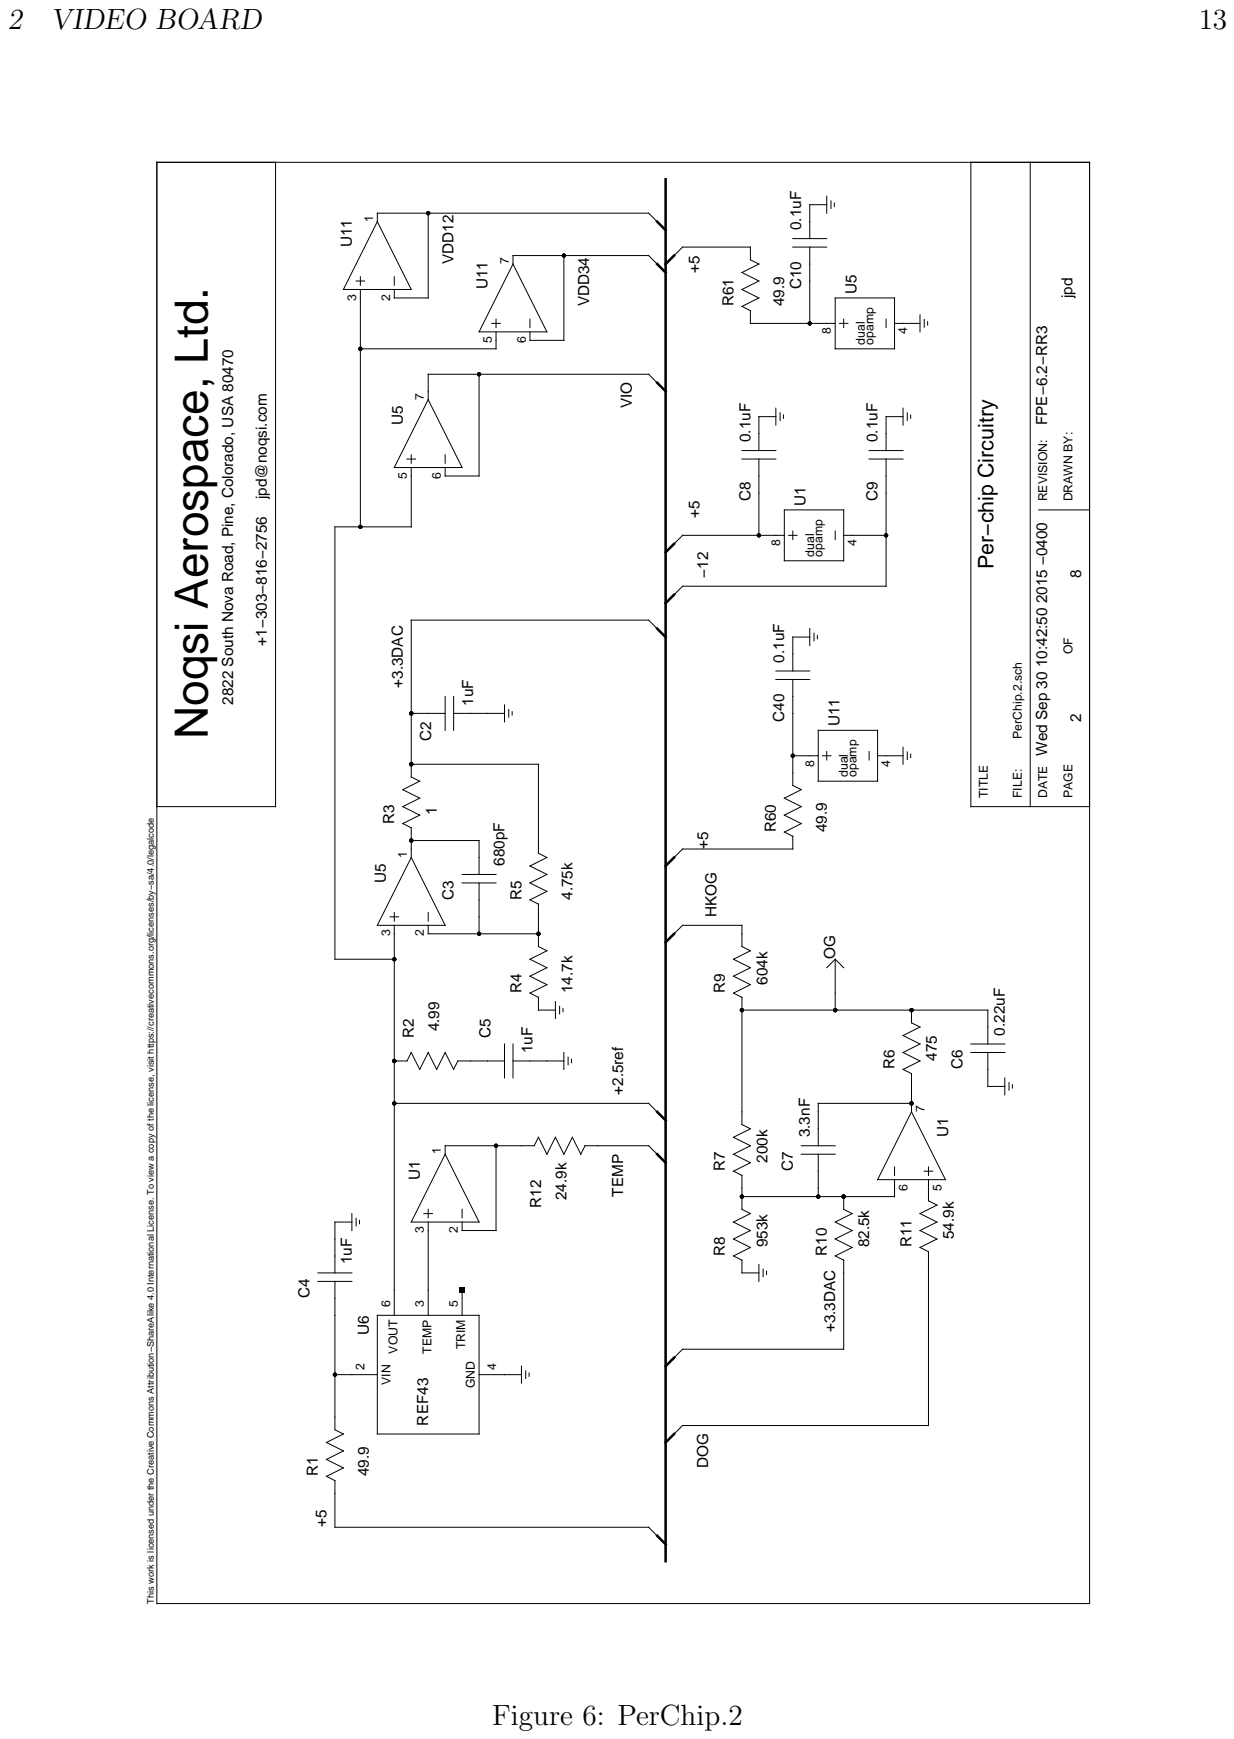
[picture p188: page 14]

2822 South Nova Road, Pine, Colorado, USA 80470

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

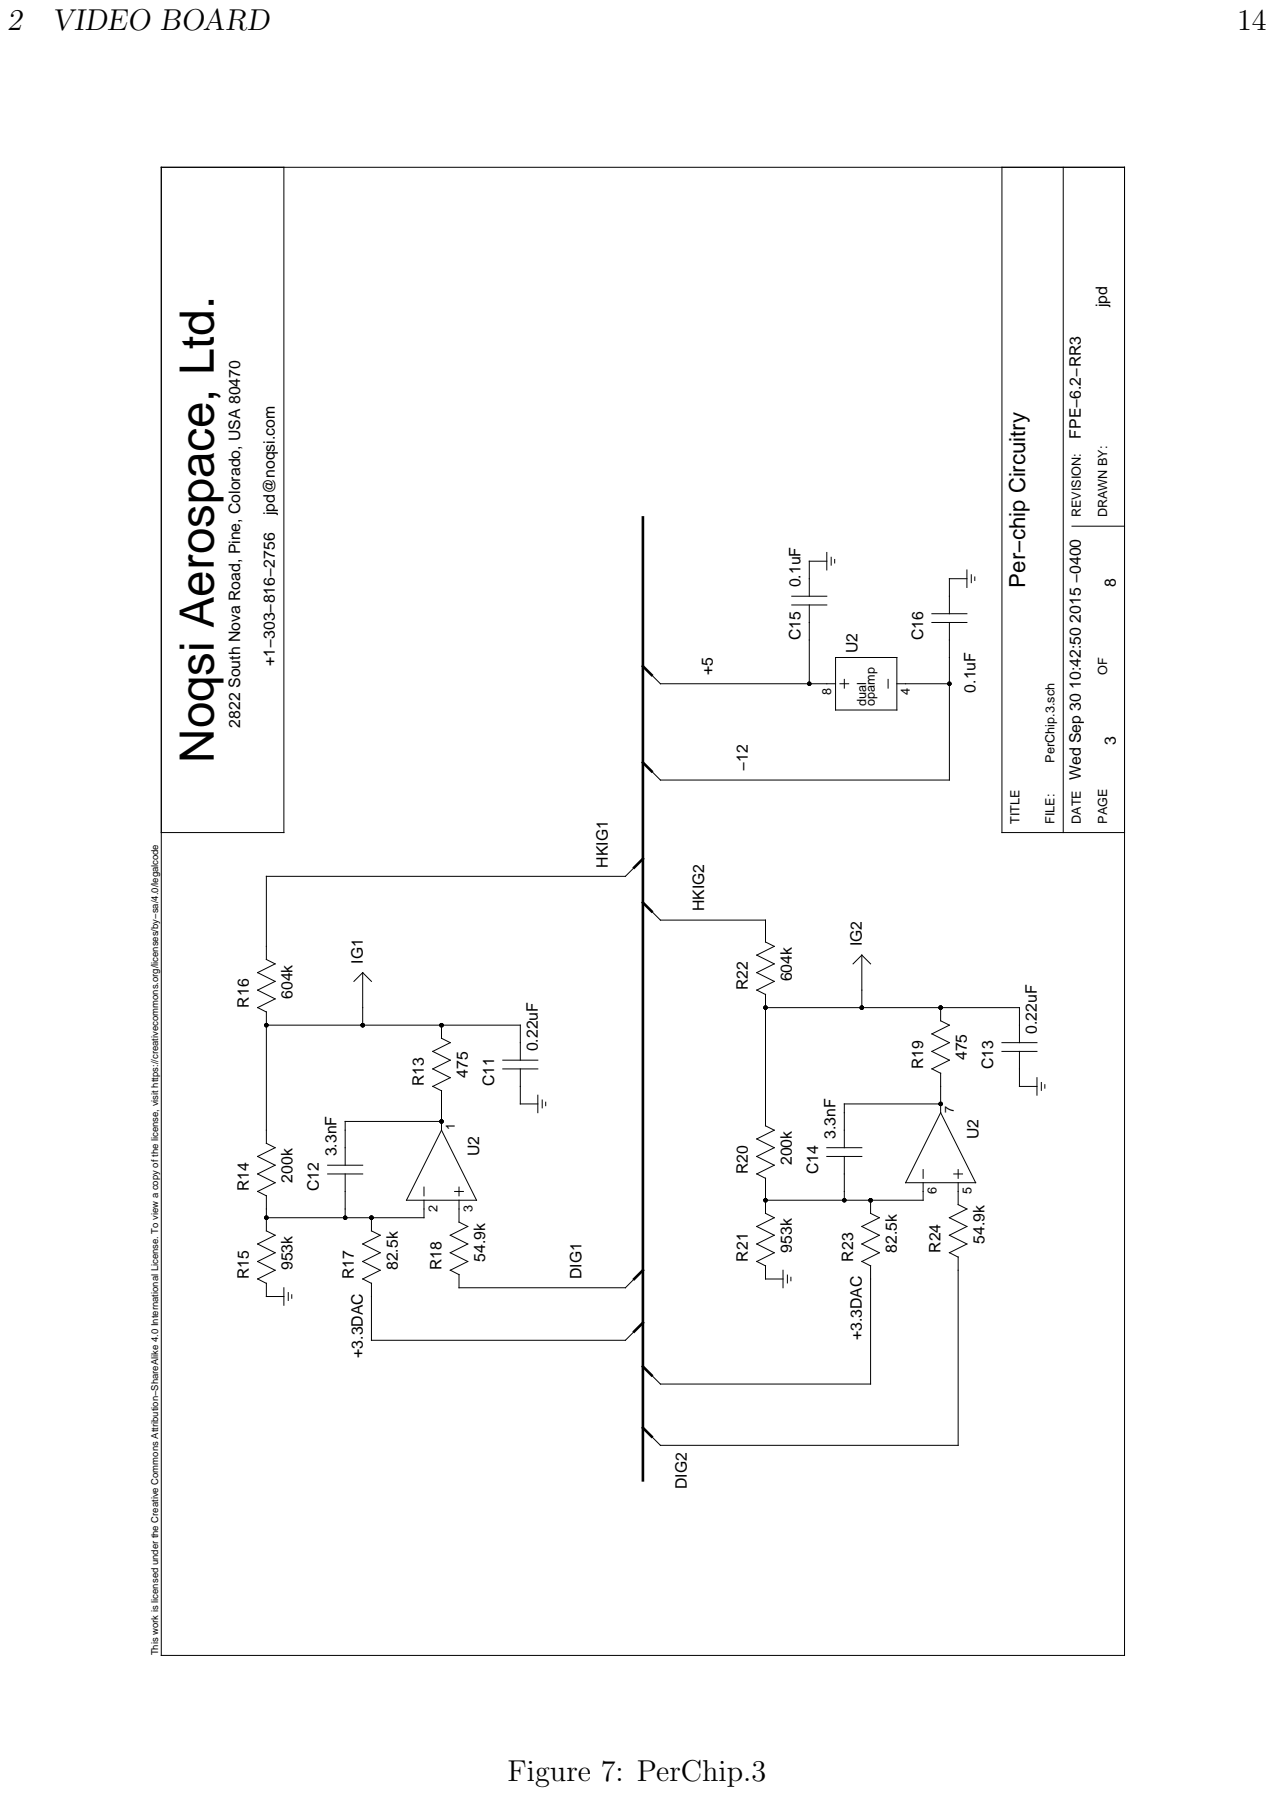
[picture p189: page 15]

2822 South Nova Road, Pine, Colorado, USA 80470

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

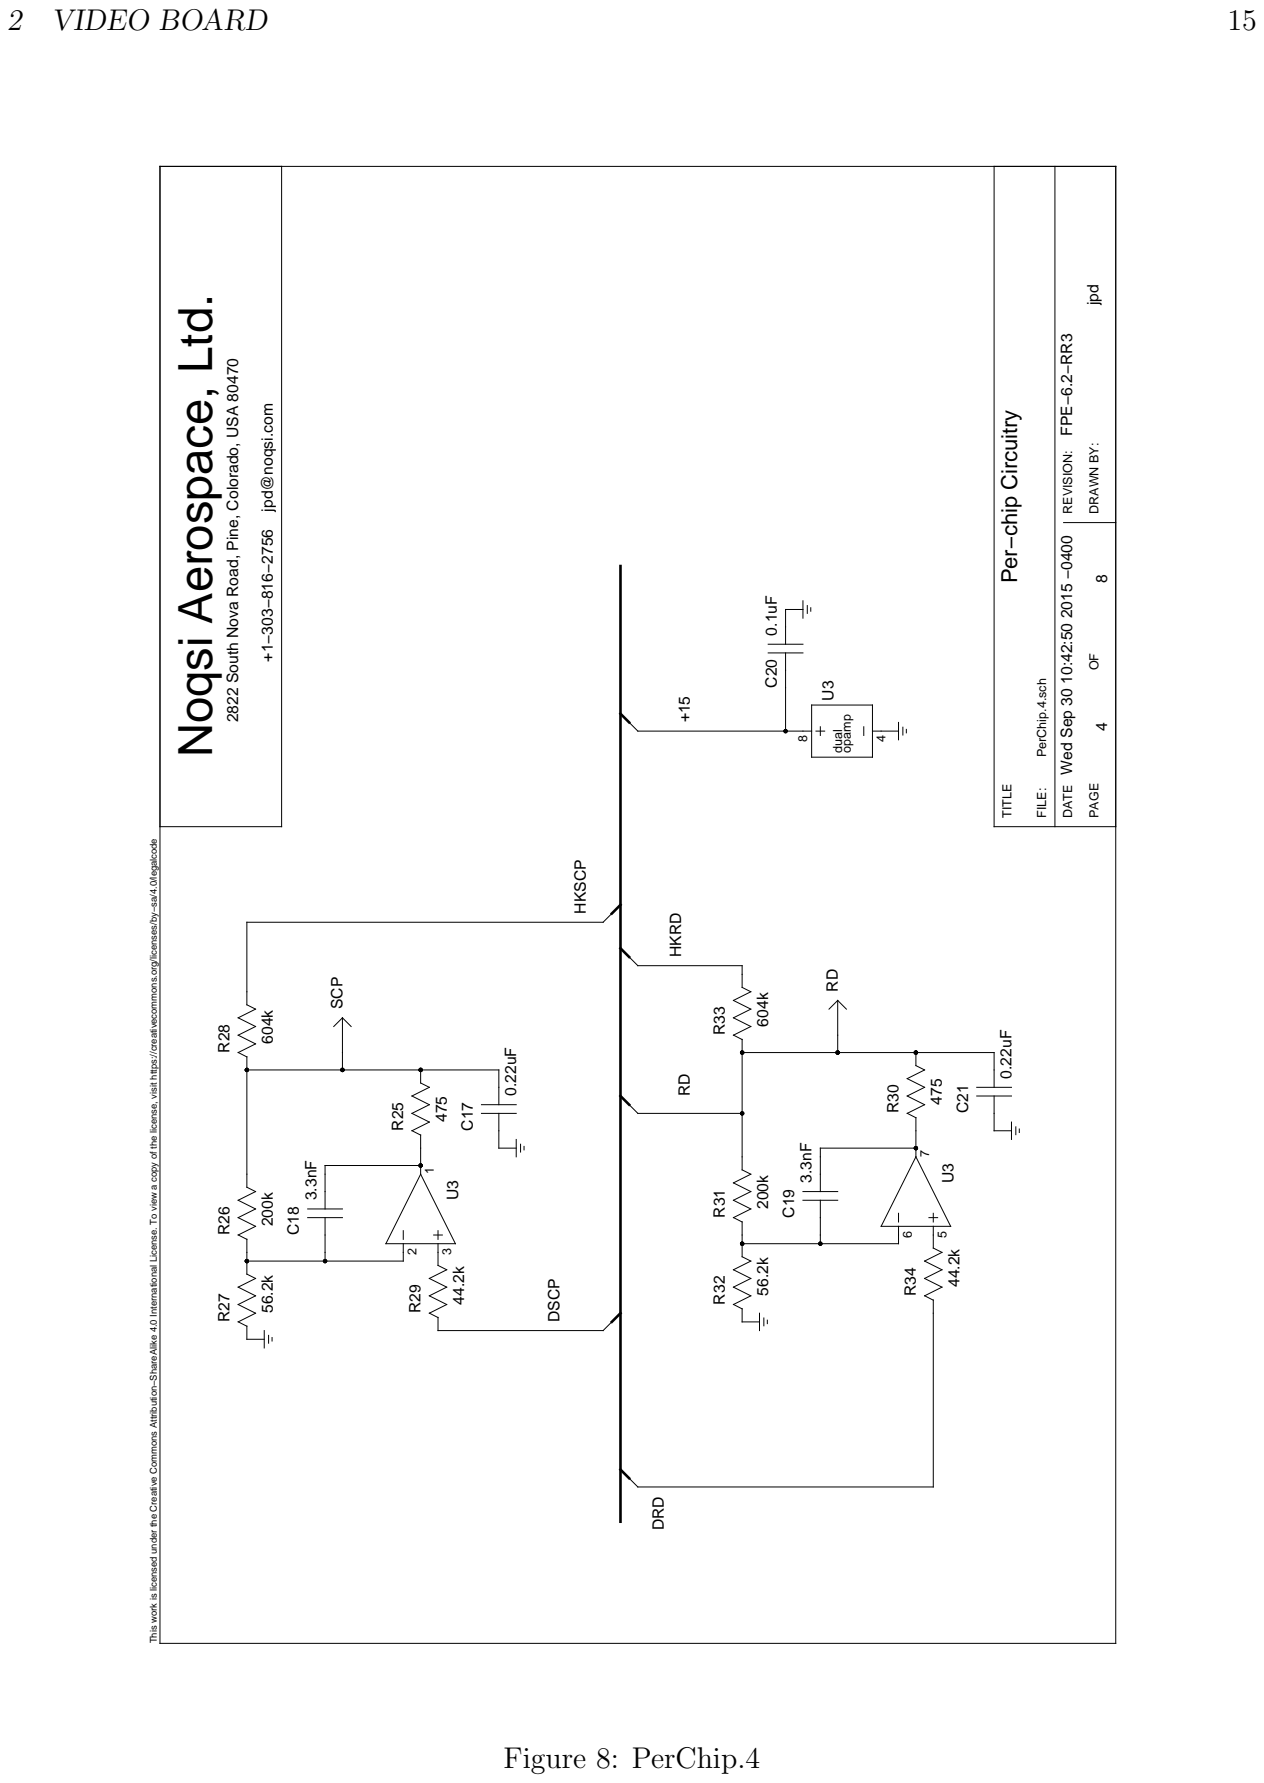
[picture p190: page 16]

2822 South Nova Road, Pine, Colorado, USA 80470

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

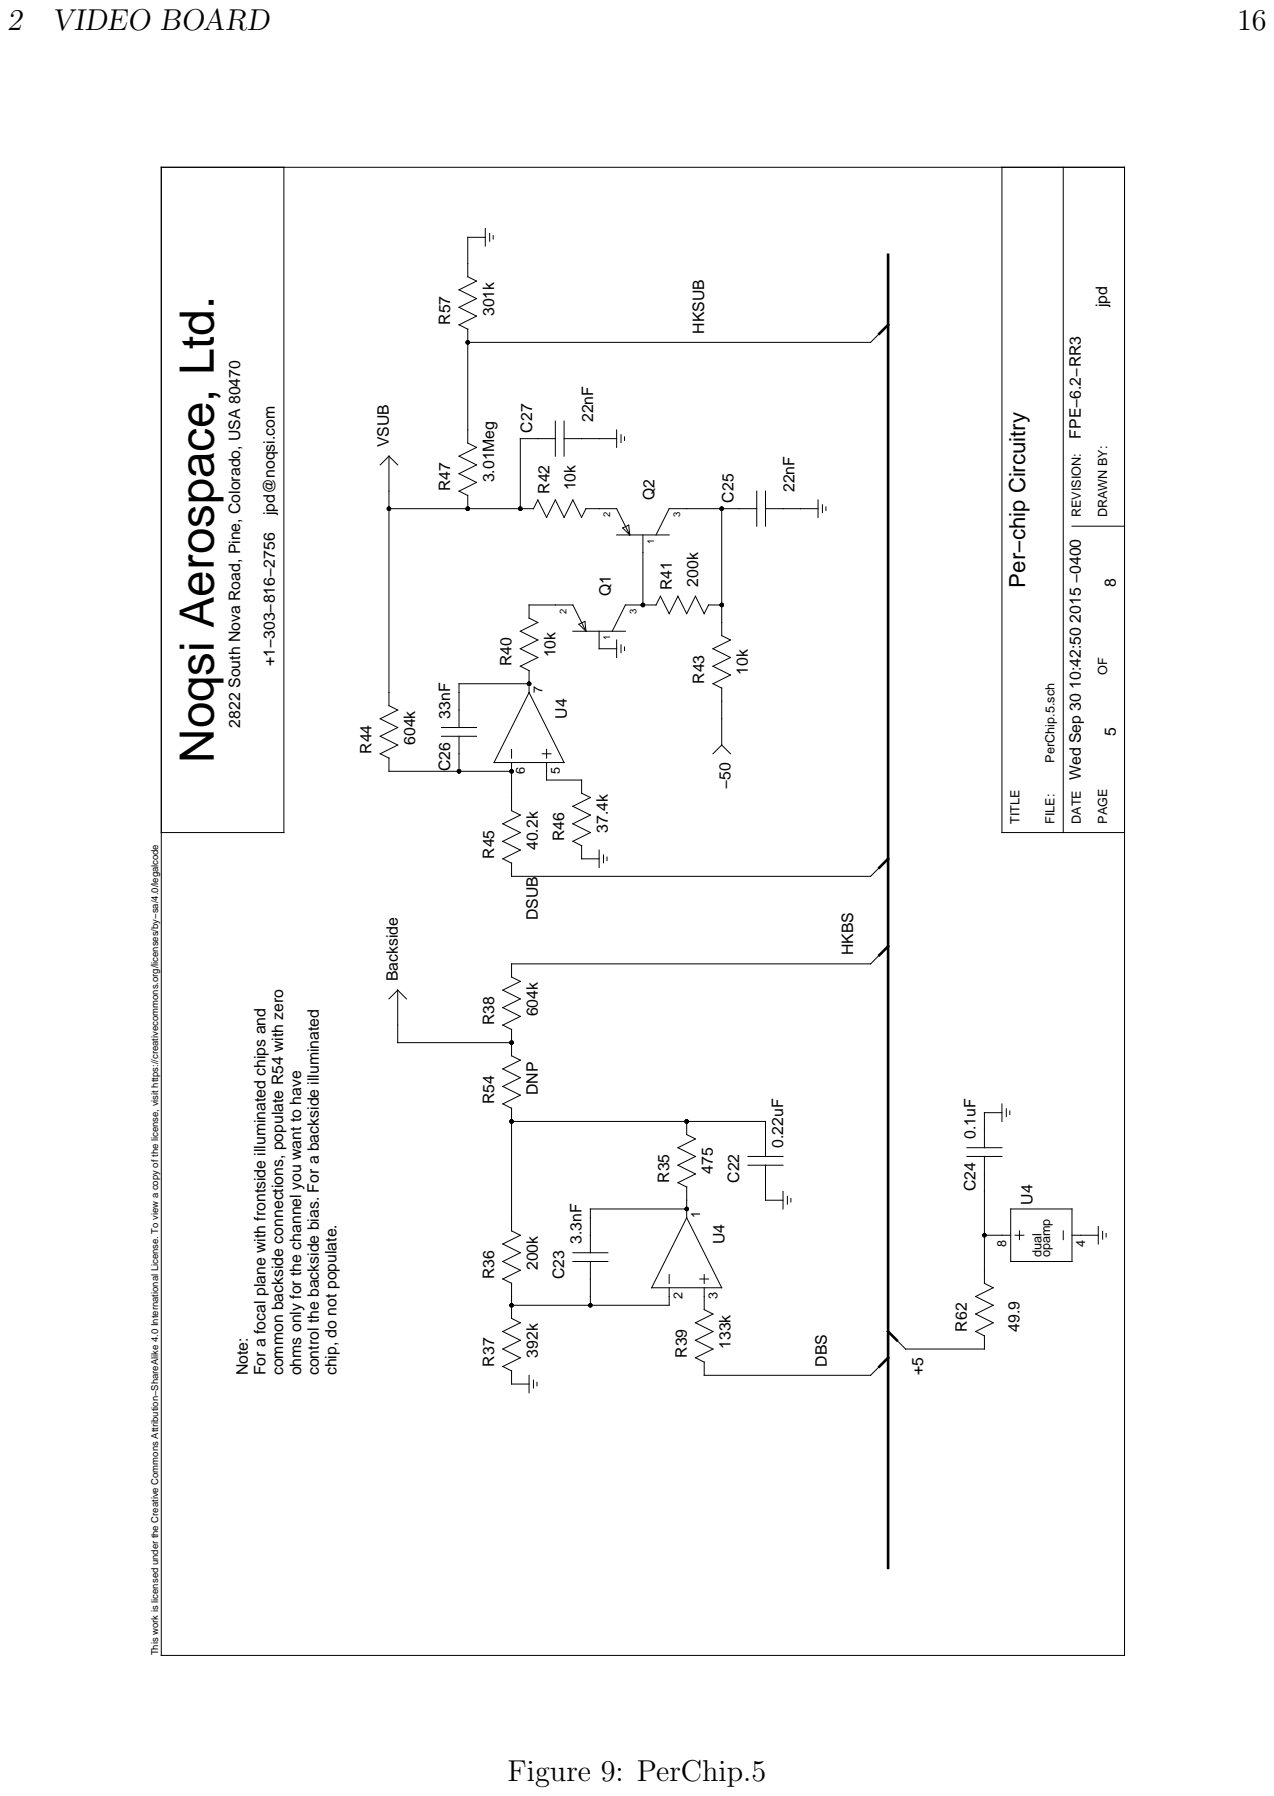
[picture p191: page 17]

2822 South Nova Road, Pine, Colorado, USA 80470

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

common backside connections, populate R54 with zero

For a focal plane with frontside illuminated chips and

control the backside bias. For a backside illuminated

ohms only for the channel you want to have

chip, do not populate.

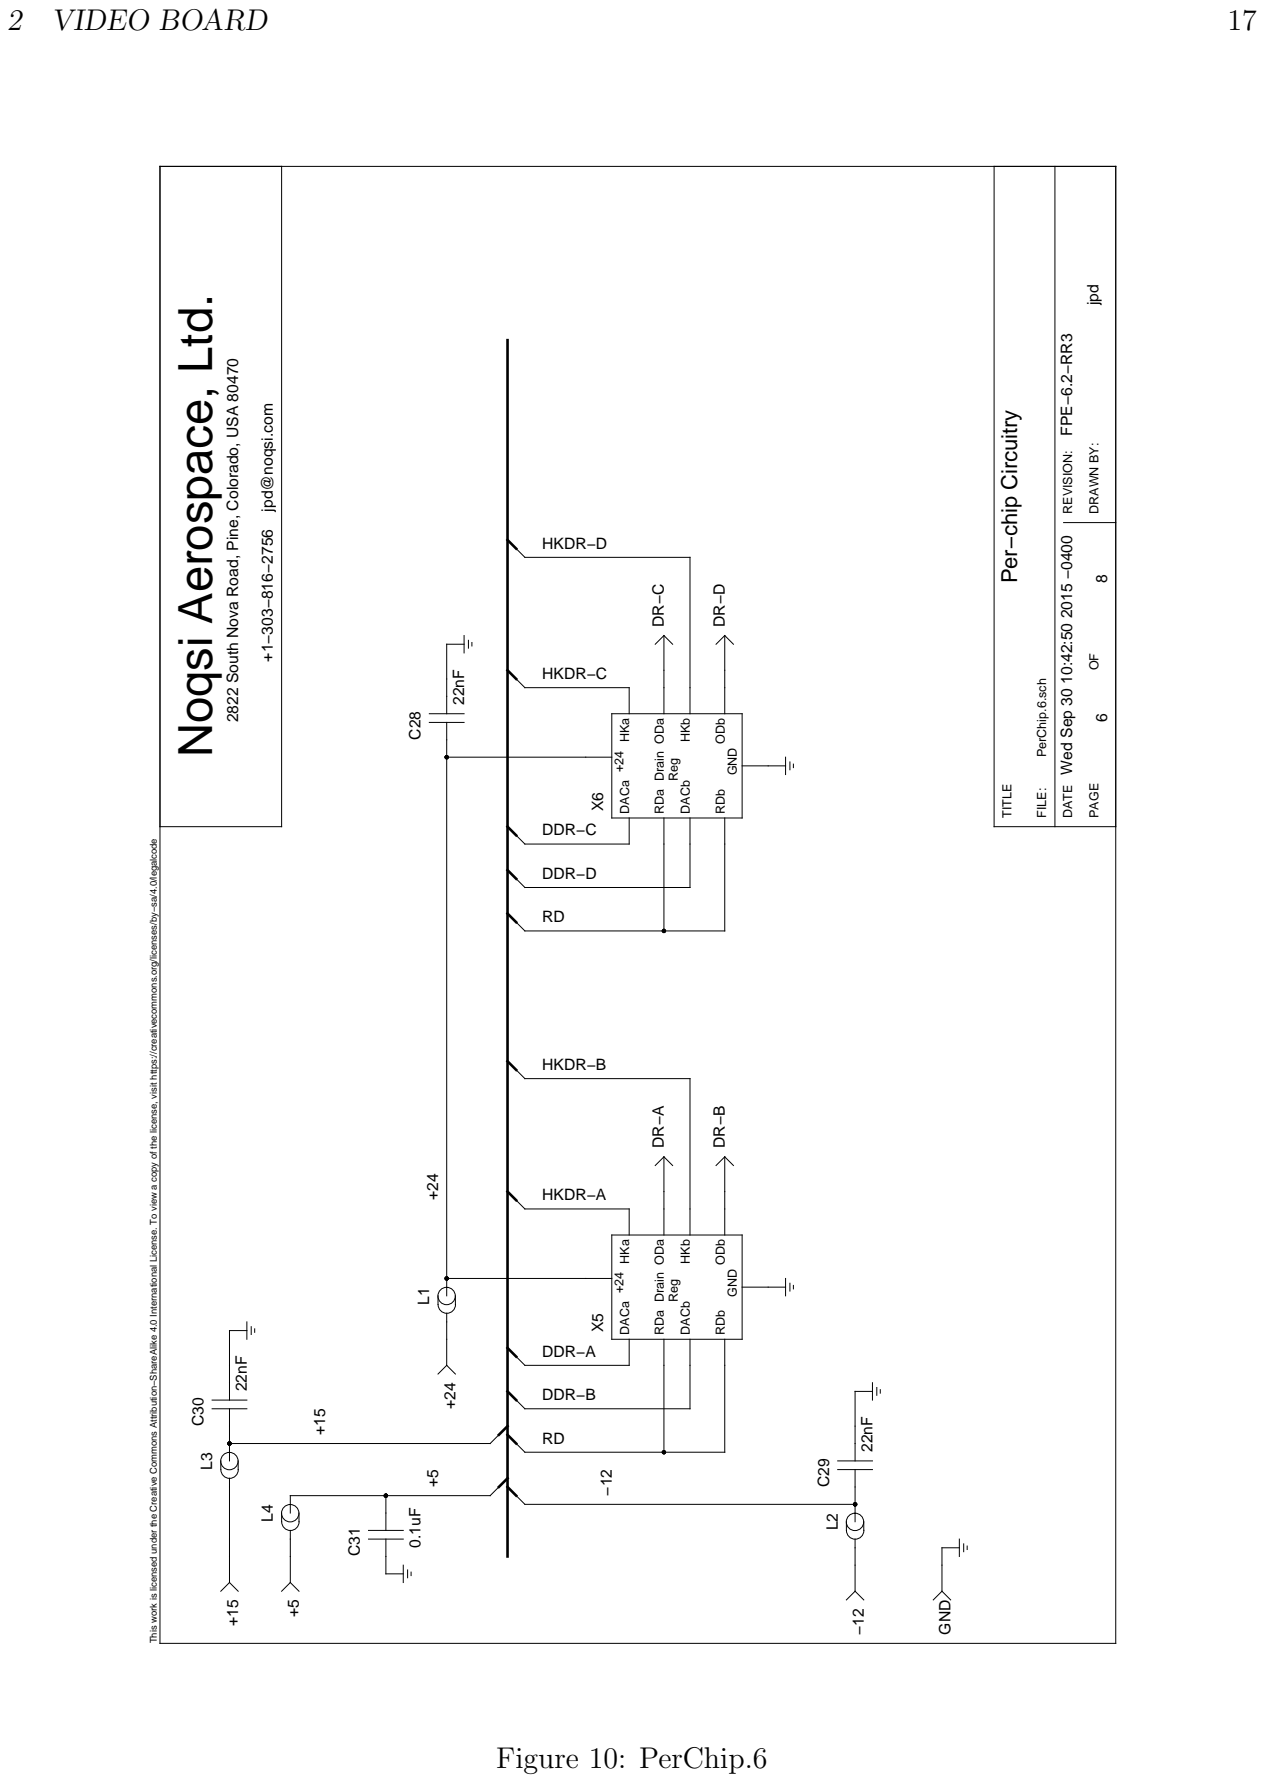
[picture p192: page 18]

2822 South Nova Road, Pine, Colorado, USA 80470

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

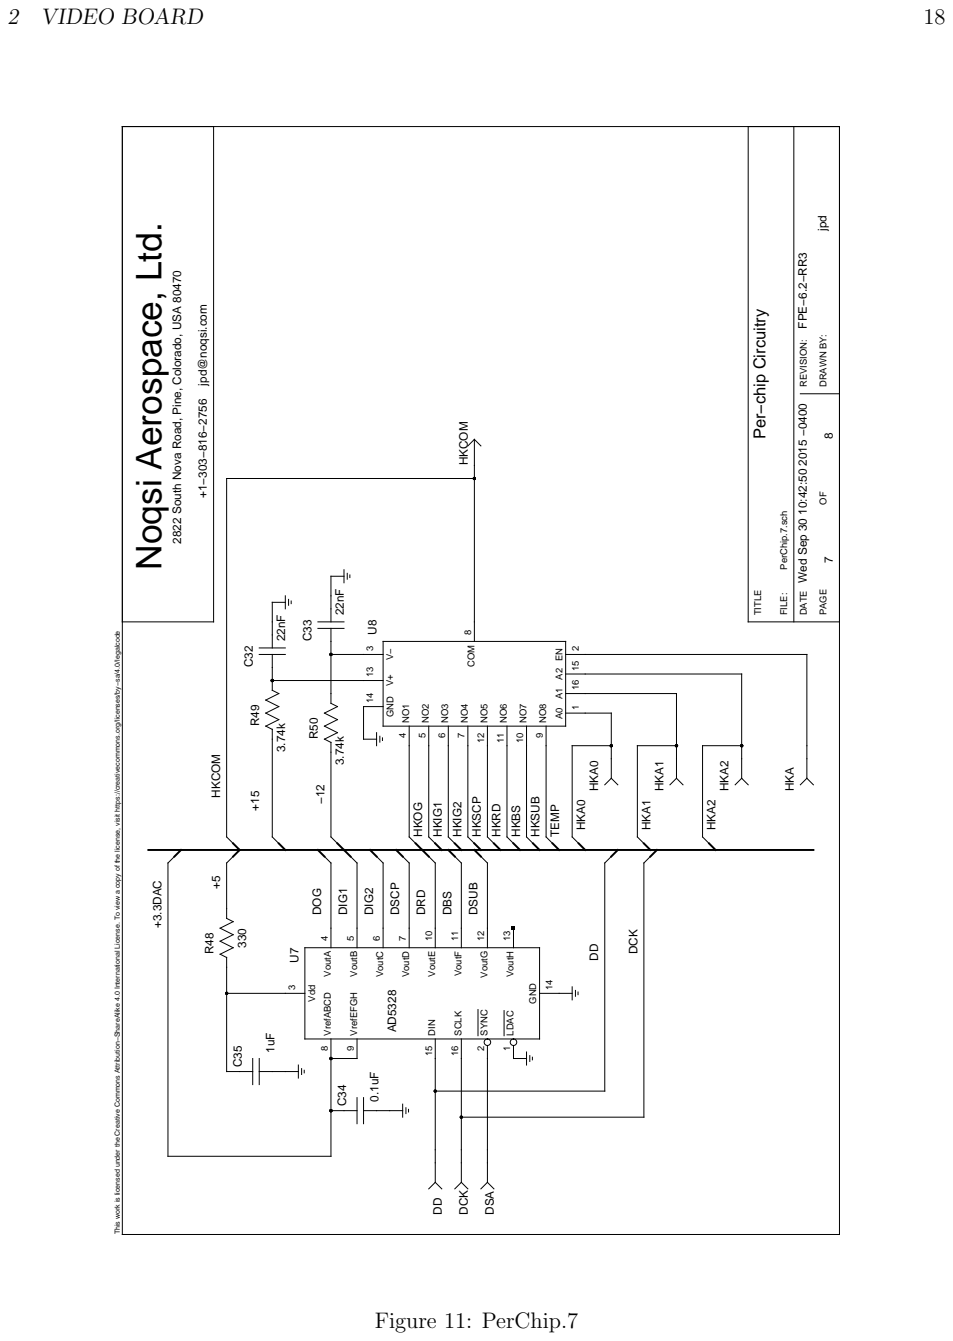
[picture p193: page 19]

2822 South Nova Road, Pine, Colorado, USA 80470

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

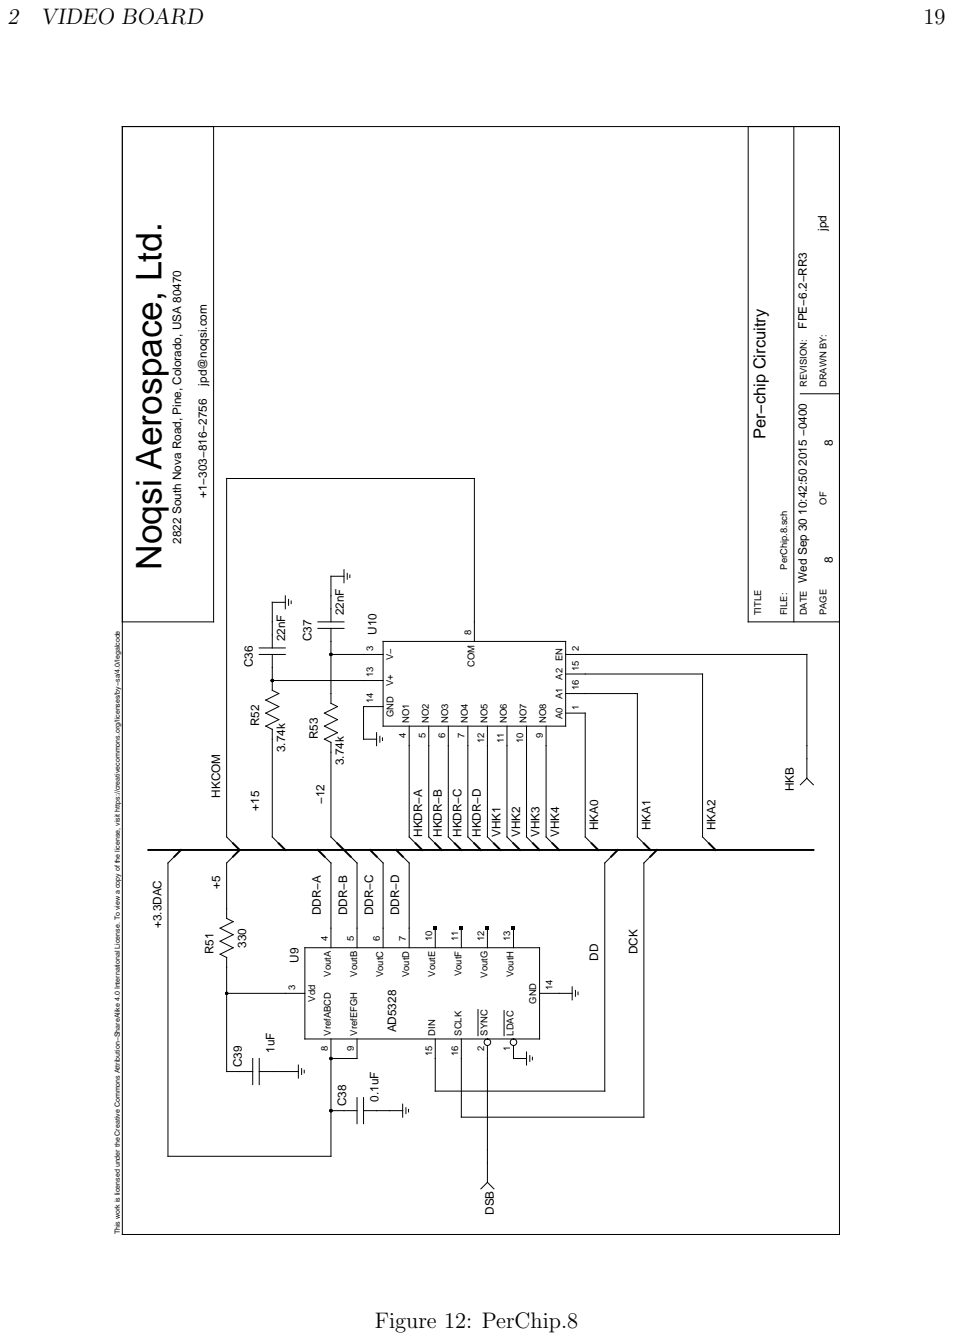
[picture p194: page 20]

2822 South Nova Road, Pine, Colorado, USA 80470

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

2 VIDEO BOARD | 20

### 2.2.4 Charge Pumps

The CCD output drains and substrate bias require modest currents at voltages outside the power supply rails. In Figure 13, U1, Q5, and Q6 generate a ≈ 25V peak-to-peak square wave. This is AC-coupled to a pair of Cockroft-Walton diode/capacitor ladders to make 24V (nominal) for the drain regulators, and -50V (nominal) for the substrate regulator.

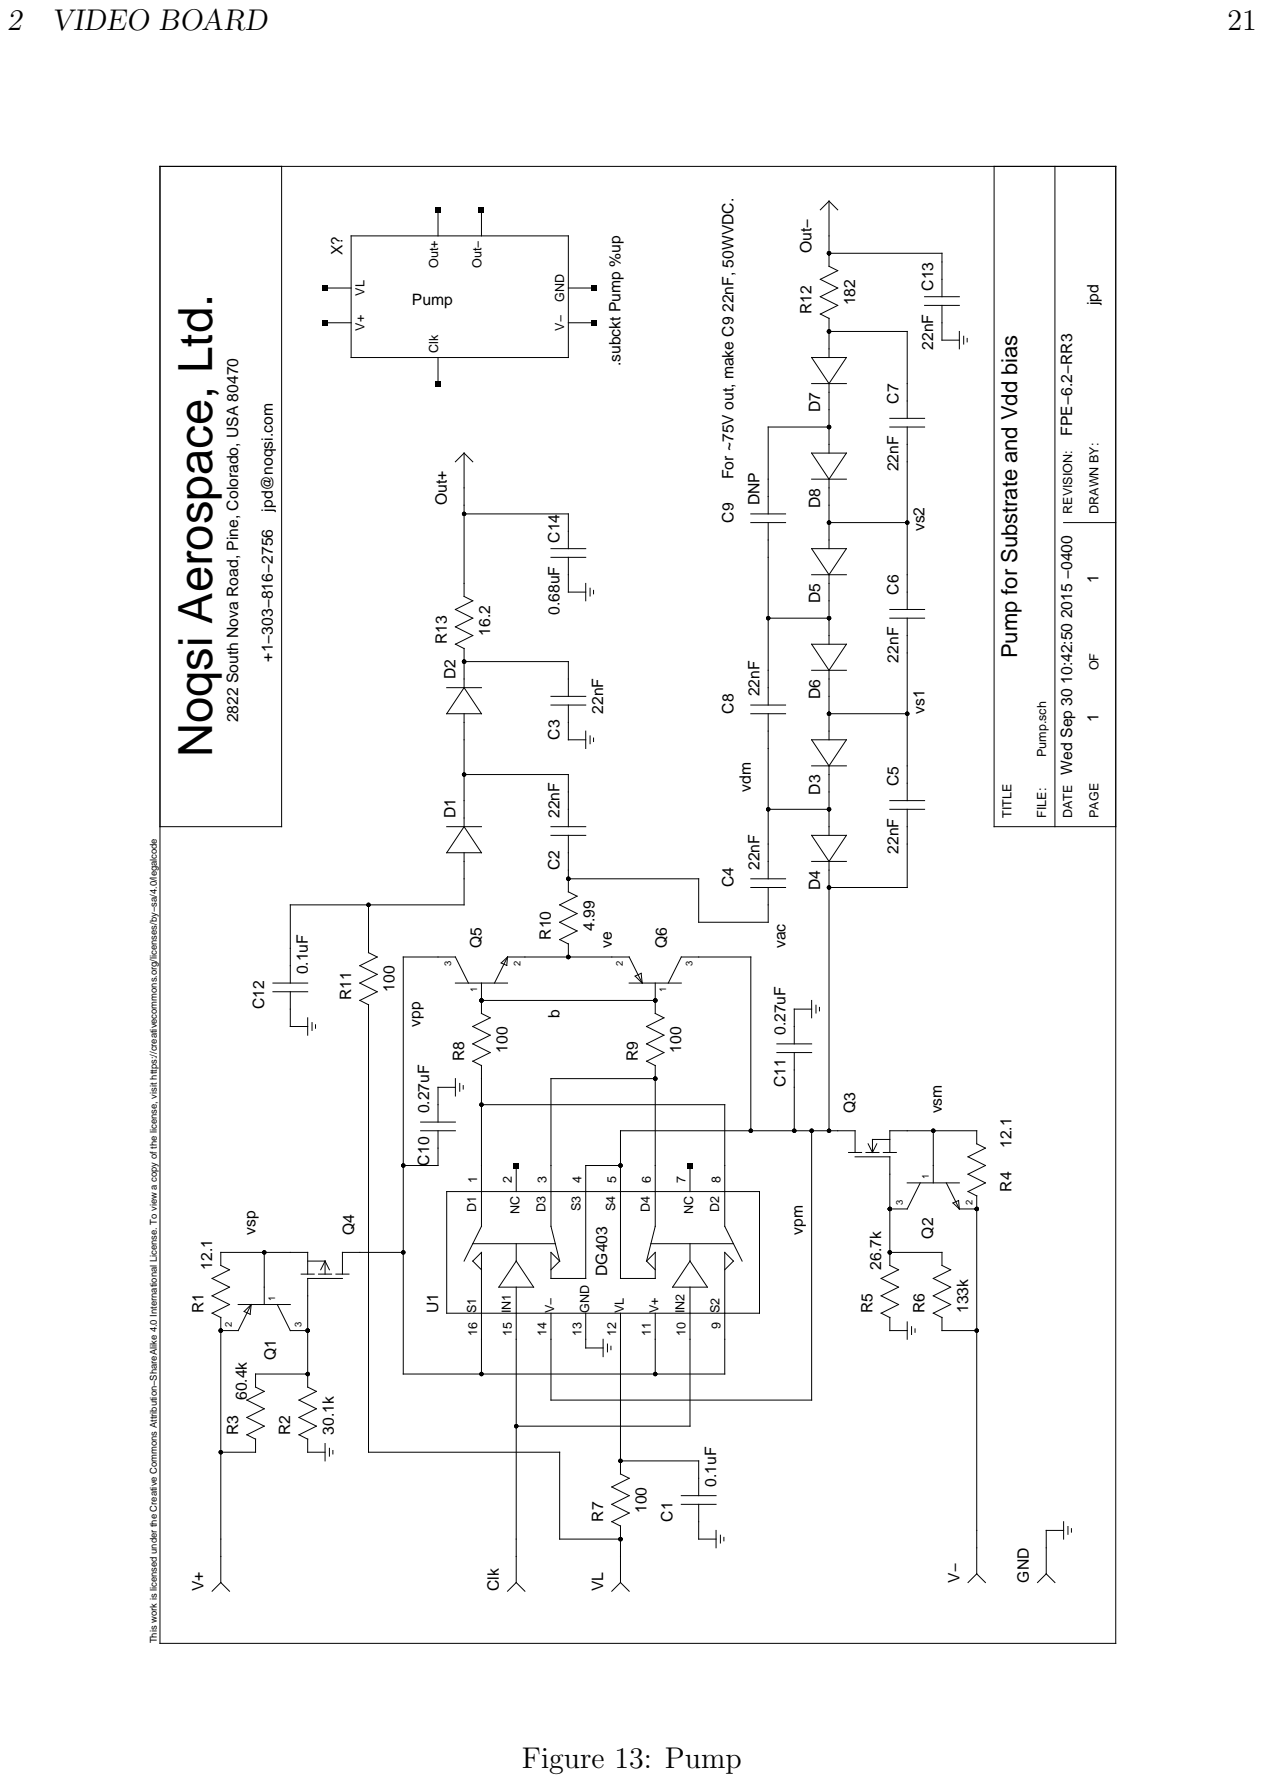
[picture p195: page 22]

Pump for Substrate and Vdd bias

2822 South Nova Road, Pine, Colorado, USA 80470

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

2 VIDEO BOARD | 22

### 2.3 Video Board Top Level

Figures 14-17 show the connections to the per-chip blocks.

Figure 18 shows the readout circuitry for the resistive temperature sensors on the CCD chip and camera structure. U1 is a fixed current source. U5 and U7 steer the current to the selected sensor. U6 and U8 select the resulting voltage, transmitting it to RTDCOM on the stacking connector. This goes to the housekeeping ADC on the Interface board.

Figure 19 shows more local voltage generation and regulation. VS12 and VS34 are regulated 4.8V for the switches in the measurement chains: these need tight regulation to control charge injection.

Figure 20 shows filters on the output gates. Since the output gates are next to the charge sense node, they may be a source of noise or crosstalk.

Figure 21 shows the control circuit for the trim heaters. Q1, Q4, and Q6 are LM195 devices: an IC that behaves like a transistor except that it shuts down if it becomes too hot.

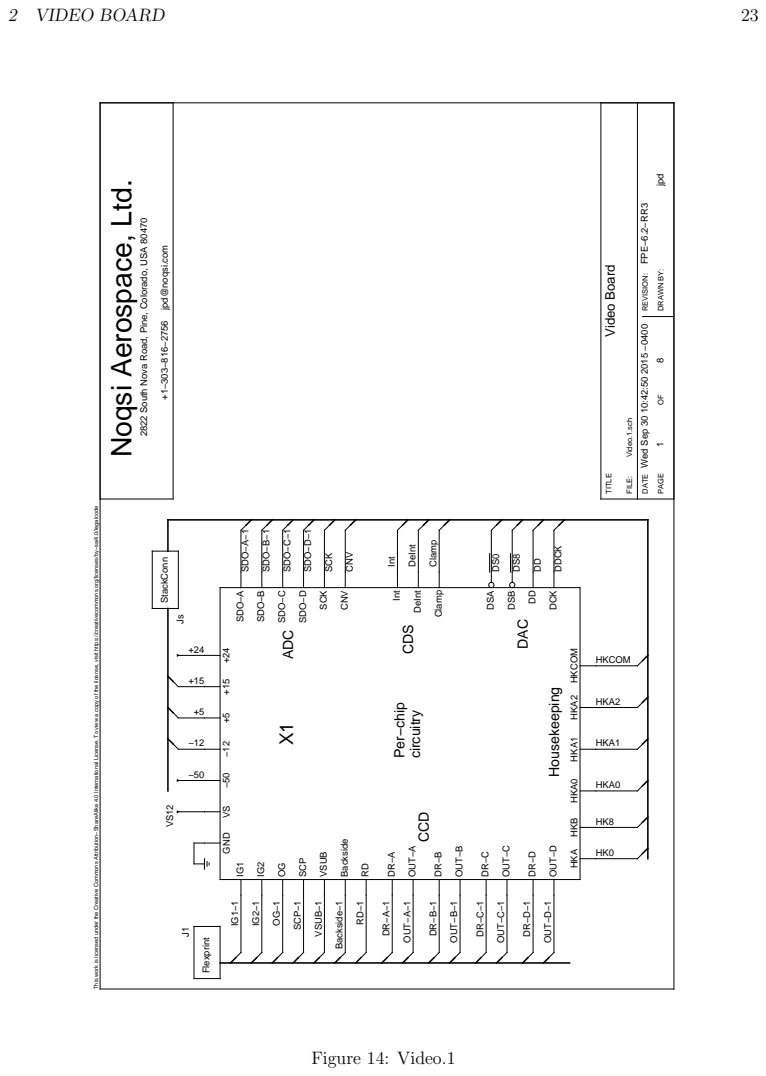
[picture p196: page 24]
2 VIDEO BOARD; FILE:; REVISION:; DRAWN BY:; TITLE; DATE; PAGE OF; jpd; Video.1.sch; Video Board; SCP; VSUB; Backside; SDO−A; SDO−B; SDO−C; SDO−D; SCK; CNV; Int; Clamp; DSA; DSB; DCK; OUT−A; OUT−B; OUT−C; OUT−D; CCD; ADC; CDS; DAC; Housekeeping; Per−chip; circuitry DeInt; GND; SCP−1; VSUB−1; Backside−1; OUT−A−1; OUT−B−1; OUT−C−1; OUT−D−1; HKA0; HKA1; HKA2; SDO−A−1; SDO−B−1; SDO−C−1; SDO−D−1; DDCK; Flexprint; StackConn; DeInt; Figure 14: Video.1

Noqsi Aerospace, Ltd.

Wed Sep 30 10:42:50 2015 −0400 FPE−6.2−RR3

2822 South Nova Road, Pine, Colorado, USA 80470

+1−303−816−2756 jpd@noqsi.com

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

HKA HKB HKA0 HKA1 HKA2 HKCOM
HKCOM

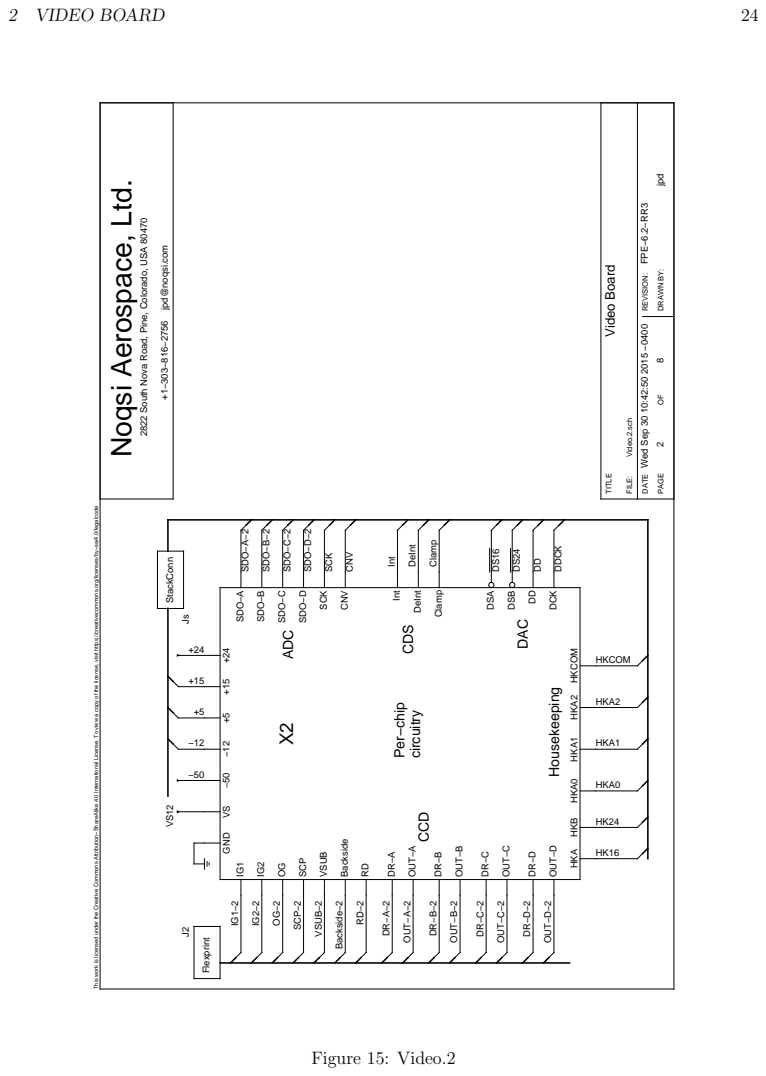
[picture p197: page 25]
2 VIDEO BOARD; FILE:; REVISION:; DRAWN BY:; TITLE; DATE; PAGE OF; jpd; Video.2.sch; Video Board; SCP; VSUB; Backside; SDO−A; SDO−B; SDO−C; SDO−D; SCK; CNV; Int; Clamp; DSA; DSB; DCK; OUT−A; OUT−B; OUT−C; OUT−D; CCD; ADC; CDS; DAC; Housekeeping; Per−chip; circuitry DeInt; GND; SCP−2; VSUB−2; Backside−2; OUT−A−2; OUT−B−2; OUT−C−2; OUT−D−2; HKA0; HKA1; HKA2; SDO−A−2; SDO−B−2; SDO−C−2; SDO−D−2; DDCK; Flexprint; DeInt; VS12 StackConn; Figure 15: Video.2

Noqsi Aerospace, Ltd.

Wed Sep 30 10:42:50 2015 −0400 FPE−6.2−RR3

2822 South Nova Road, Pine, Colorado, USA 80470

+1−303−816−2756 jpd@noqsi.com

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

HKA HKB HKA0 HKA1 HKA2 HKCOM
HKCOM

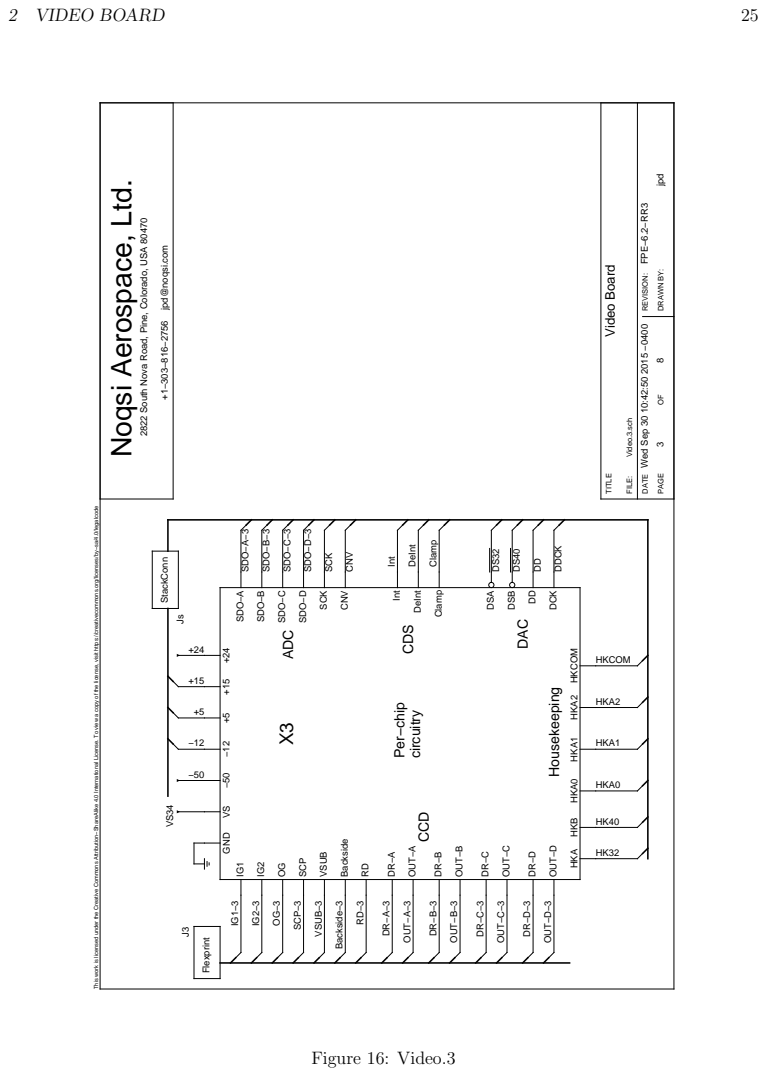
[picture p198: page 26]
2 VIDEO BOARD; FILE:; REVISION:; DRAWN BY:; TITLE; DATE; PAGE OF; jpd; Video.3.sch; Video Board; SCP; VSUB; Backside; SDO−A; SDO−B; SDO−C; SDO−D; SCK; CNV; Int; Clamp; DSA; DSB; DCK; OUT−A; OUT−B; OUT−C; OUT−D; CCD; ADC; CDS; DAC; Housekeeping; Per−chip; circuitry DeInt; GND; SCP−3; VSUB−3; Backside−3; OUT−A−3; OUT−B−3; OUT−C−3; OUT−D−3; HKA0; HKA1; HKA2; SDO−A−3; SDO−B−3; SDO−C−3; SDO−D−3; DDCK; Flexprint; DeInt; VS34 StackConn; Figure 16: Video.3

Noqsi Aerospace, Ltd.

Wed Sep 30 10:42:50 2015 −0400 FPE−6.2−RR3

2822 South Nova Road, Pine, Colorado, USA 80470

+1−303−816−2756 jpd@noqsi.com

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

HKA HKB HKA0 HKA1 HKA2 HKCOM
HKCOM

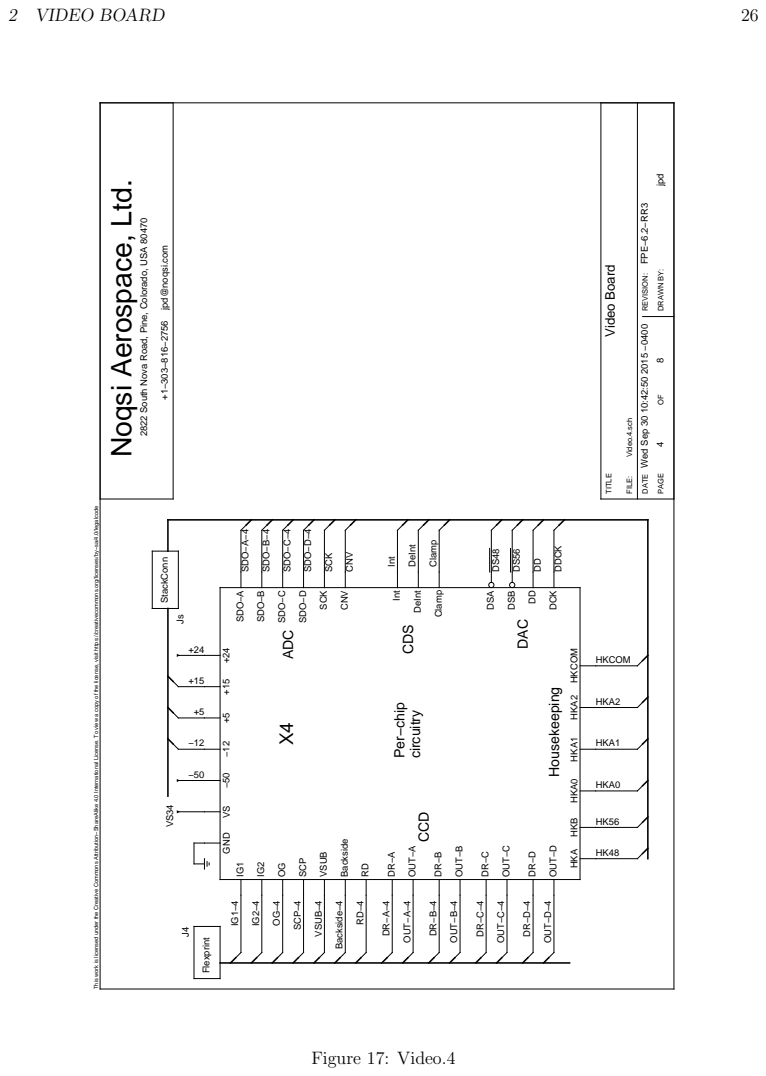
[picture p199: page 27]
2 VIDEO BOARD; FILE:; REVISION:; DRAWN BY:; TITLE; DATE; PAGE OF; jpd; Video.4.sch; Video Board; SCP; VSUB; Backside; SDO−A; SDO−B; SDO−C; SDO−D; SCK; CNV; Int; Clamp; DSA; DSB; DCK; OUT−A; OUT−B; OUT−C; OUT−D; CCD; ADC; CDS; DAC; Housekeeping; Per−chip; circuitry DeInt; GND; SCP−4; VSUB−4; Backside−4; OUT−A−4; OUT−B−4; OUT−C−4; OUT−D−4; HKA0; HKA1; HKA2; SDO−A−4; SDO−B−4; SDO−C−4; SDO−D−4; DDCK; Flexprint; DeInt; VS34 StackConn; Figure 17: Video.4

Noqsi Aerospace, Ltd.

Wed Sep 30 10:42:50 2015 −0400 FPE−6.2−RR3

2822 South Nova Road, Pine, Colorado, USA 80470

+1−303−816−2756 jpd@noqsi.com

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

HKA HKB HKA0 HKA1 HKA2 HKCOM
HKCOM

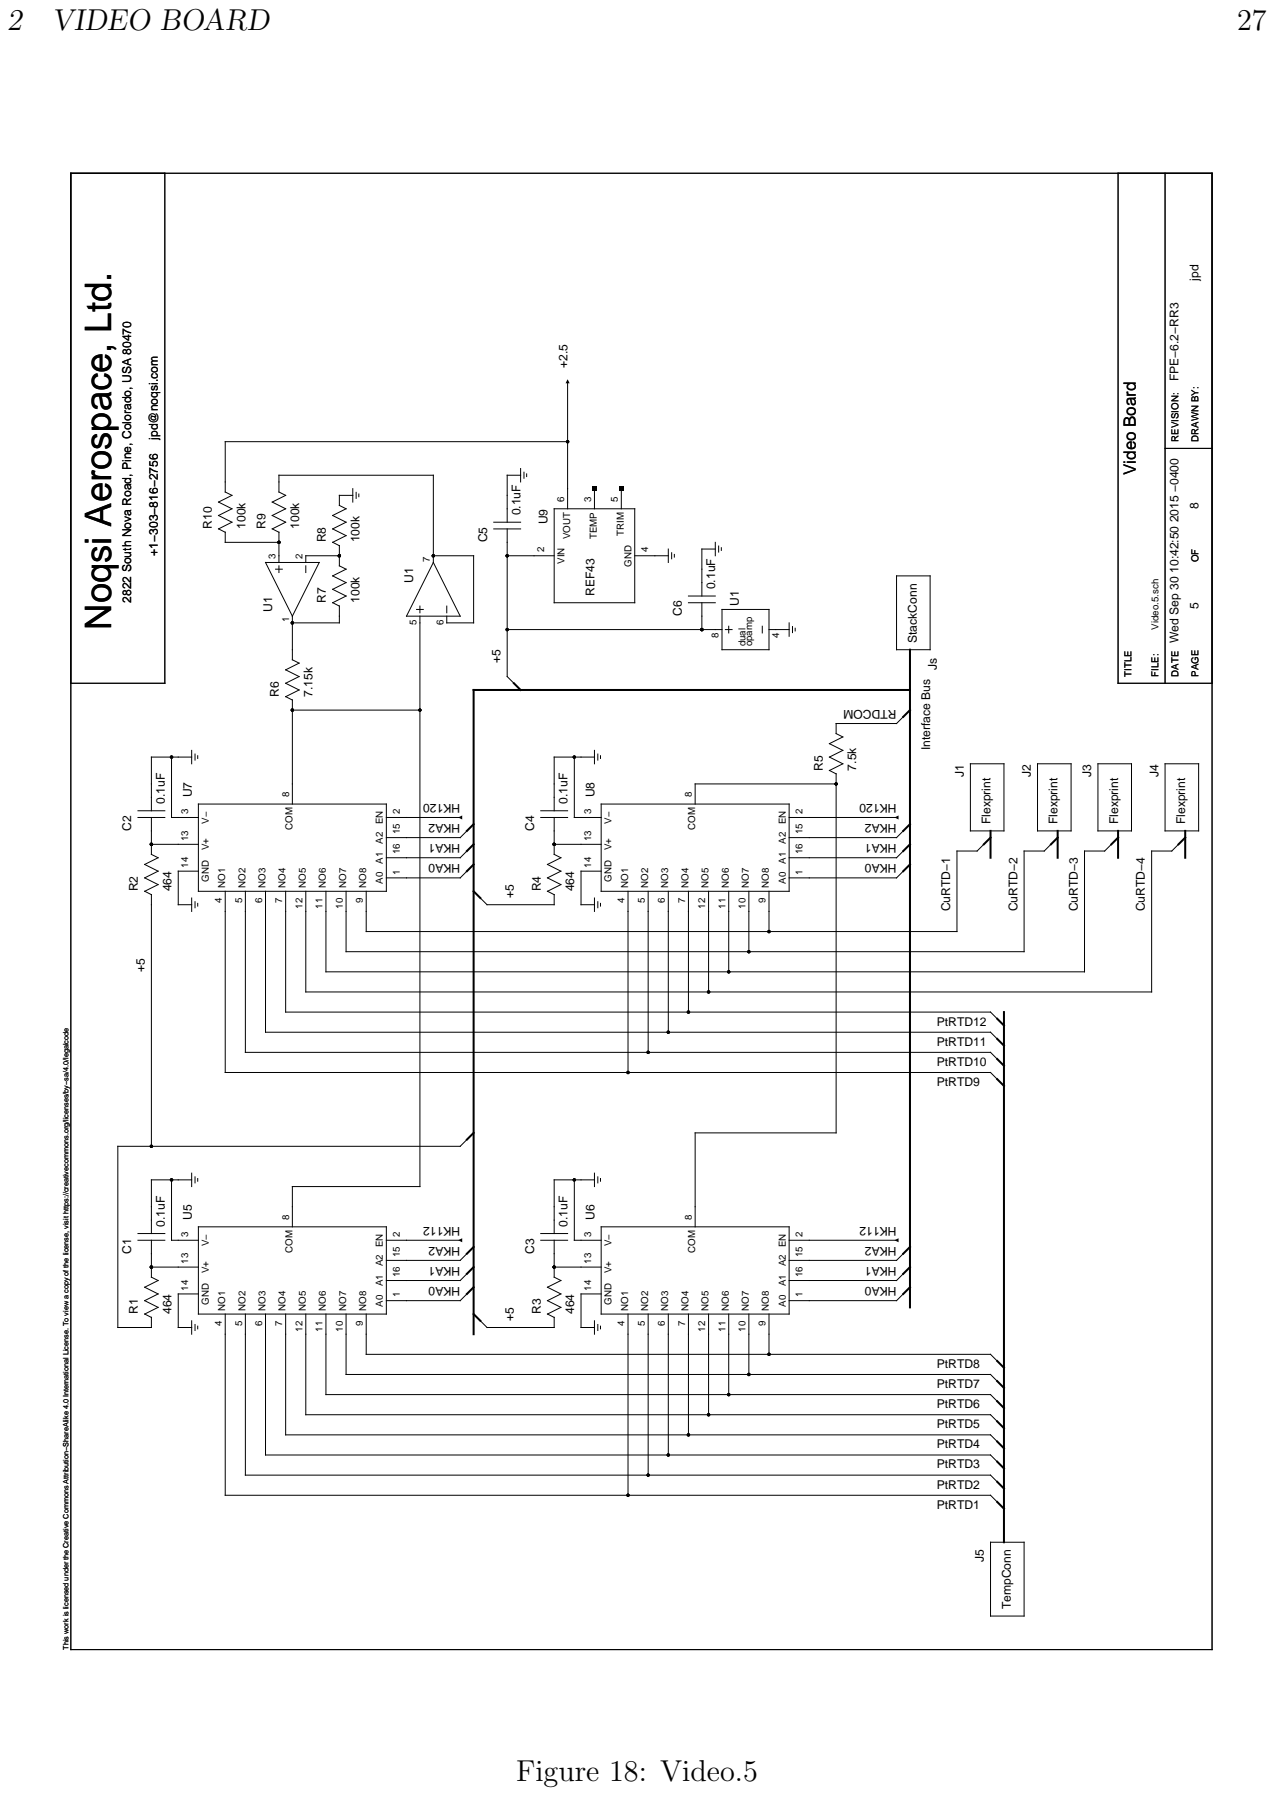
[picture p200: page 28]

2822 South Nova Road, Pine, Colorado, USA 80470

PtRTD12
PtRTD11
PtRTD10

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

PtRTD8
PtRTD7
PtRTD6
PtRTD5
PtRTD4

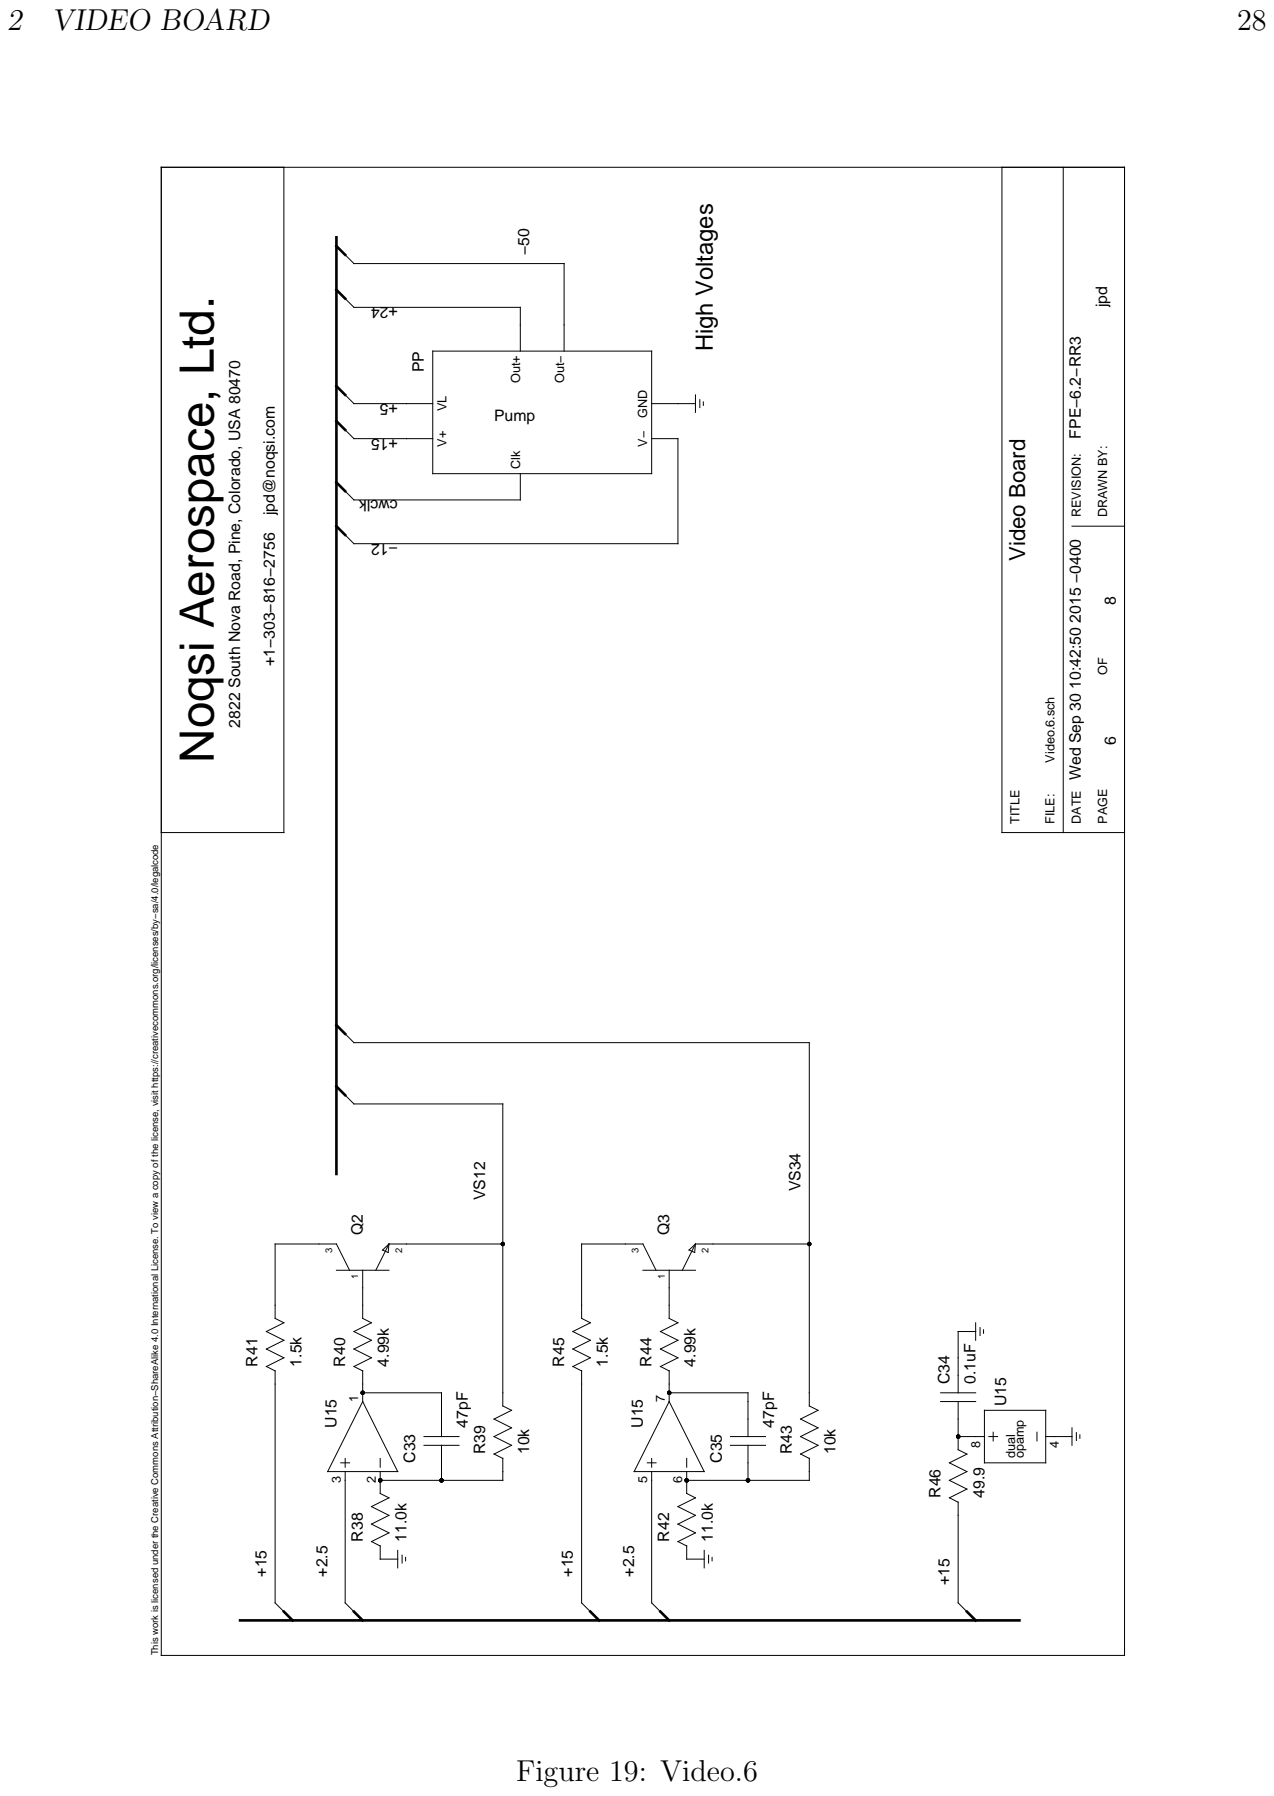
[picture p201: page 29]

2822 South Nova Road, Pine, Colorado, USA 80470

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

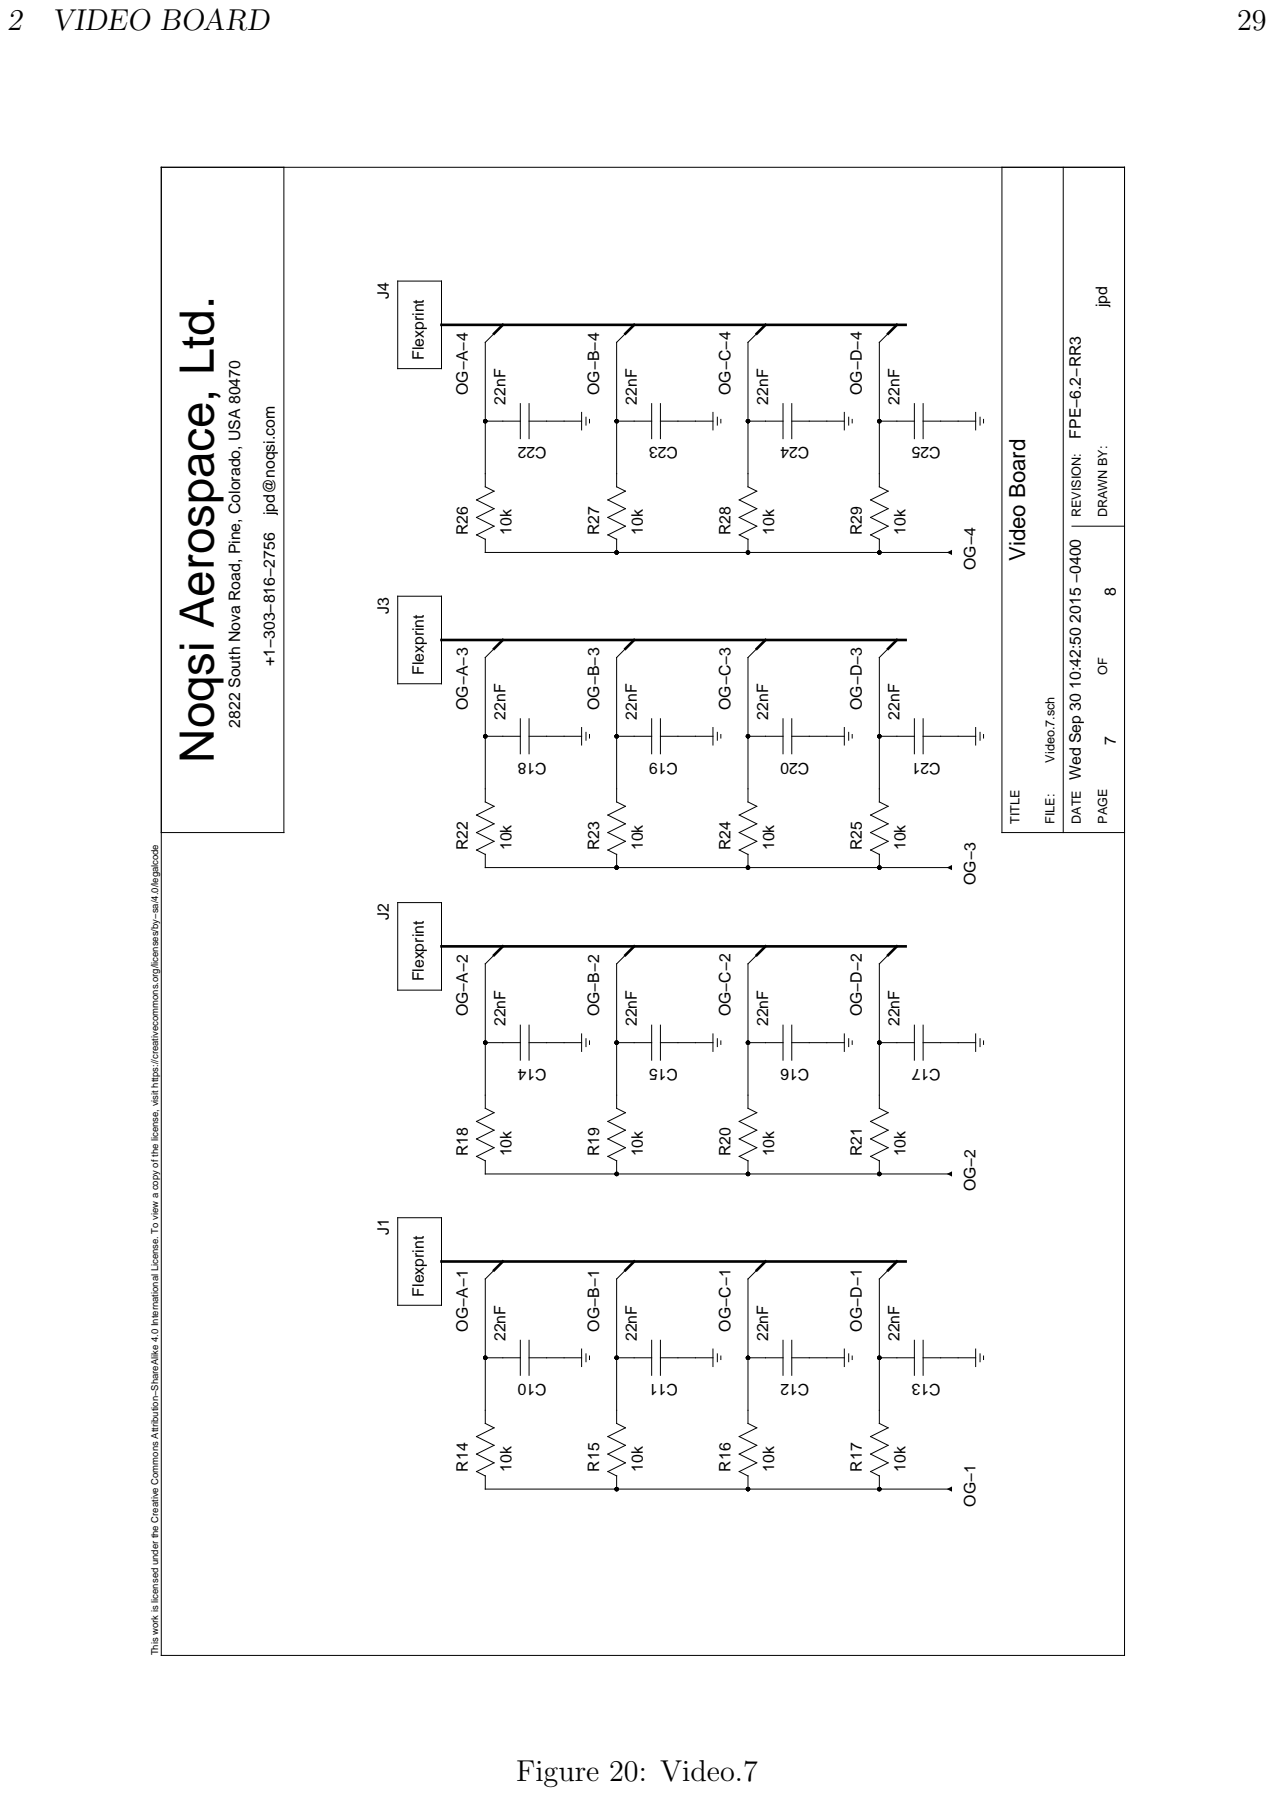
[picture p202: page 30]

2822 South Nova Road, Pine, Colorado, USA 80470

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

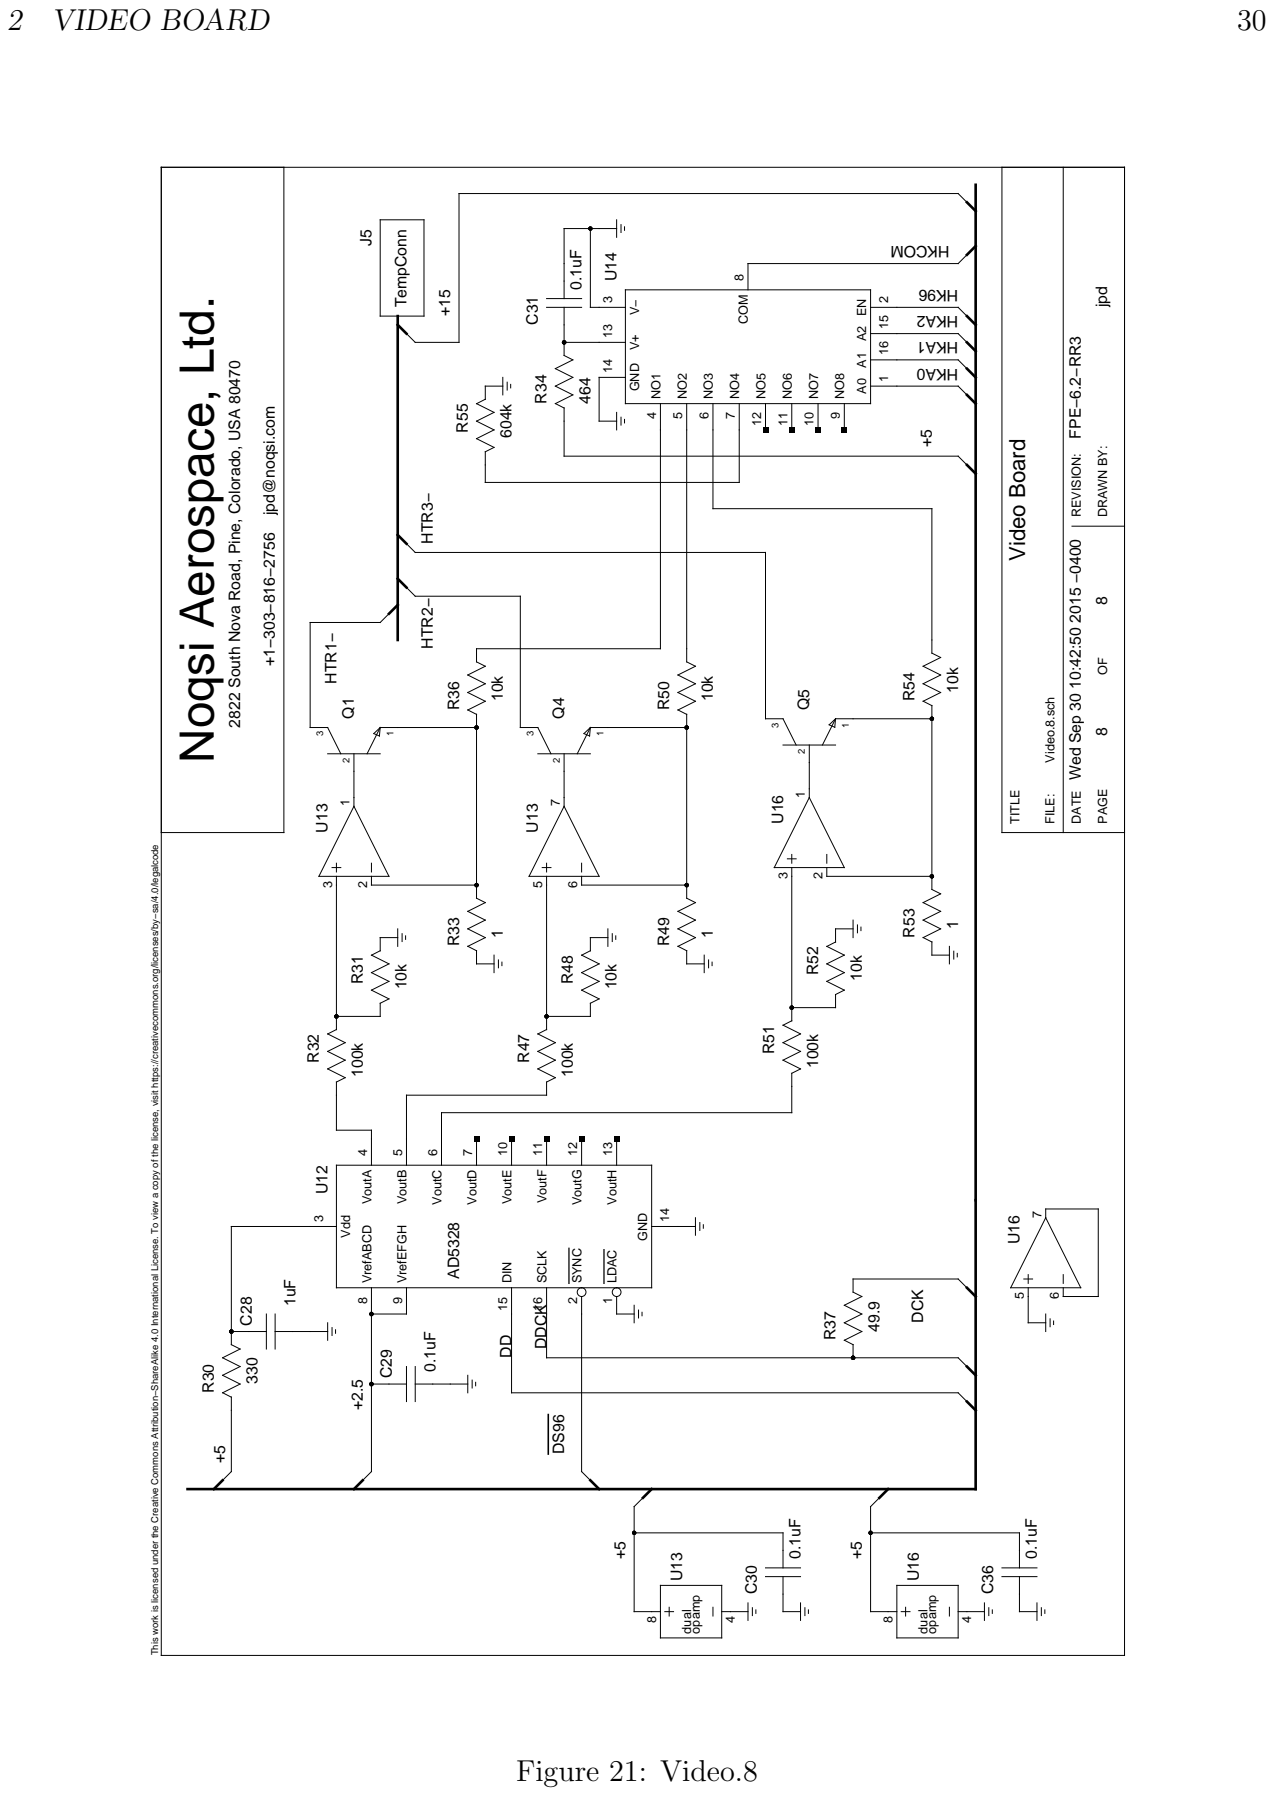
[picture p203: page 31]

2822 South Nova Road, Pine, Colorado, USA 80470

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

2 VIDEO BOARD | 31

### 2.4 Video Board Connectors

J1, J2, J3, and J4 connect to the flexprint cables from CCD1, CCD2, CCD3, and CCD4, respec-tively. Table 1 shows the pinout of J1. The -1 at the end of most net names indicates that the net serves CCD1. For J2, the corresponding net names end in -2, etc. Table 2 shows the pinout for J5, which serves the external temperature sensors and heater. Table 5 covers Js, the board stack connector.

Table 1: Flexprint Connector

Connector | Pin | Net | Signal
J1 | 1 | Backside-1 | case
J1 | 2 | IG1-1 | IG1
J1 | 3 | IG2-1 | IG2
J1 | 4 | P1-OR-1 | S1CD
J1 | 5 | P2-OR-1 | S2CD
J1 | 6 | P3-OR-1 | S3CD
J1 | 7 | P1-U-1 | S1U
J1 | 8 | P2-U-1 | S2U
J1 | 9 | P3-U-1 | S3U
J1 | 13 | P3-IA-1 | IA3
J1 | 14 | P2-IA-1 | IA2
J1 | 15 | P1-IA-1 | IA1
J1 | 19 | GND | CS
J1 | 20 | P3-OR-1 | S3AB
J1 | 21 | P2-OR-1 | S2AB
J1 | 22 | P1-OR-1 | S1AB
J1 | 23 | P3-FS-1 | FS3
J1 | 24 | P2-FS-1 | FS2
J1 | 25 | P1-FS-1 | FS1
J1 | 26 | VSUB-1 | SUB
J1 | 27 | ID-1 | ID
J1 | 28 | GND | RETD
J1 | 29 | OG-D-1 | OGD
J1 | 30 | DR-D-1 | DRD
J1 | 31 | OUT-D-1 | OSD
J1 | 32 | GND | RTD78
J1 | 33 | CuS-1 | RTD56
J1 | 34 | RD-1 | RD
J1 | 35 | OUT-C-1 | OSC
J1 | 36 | DR-C-1 | DRC
J1 | 37 | OG-C-1 | OGC
J1 | 38 | GND | RETC
J1 | 39 | SCP-1 | SCP

2 VIDEO BOARD | 32

Table 1: Flexprint Connector (continued)

Connector | Pin | Net | Signal
J1 J1 J1 J1 J1 J1 J1 J1 J1 J1 J1 J1 | 40 41 42 43 44 45 46 47 48 49 50 51 | GND OG-B-1 DR-B-1 OUT-B-1 RG-1 CuS-1 CuRTD-1 OUT-A-1 DR-A-1 OG-A-1 GND SCP-1 | RETB OGB DRB OSB RG RTD34 RTD12 OSA DRA OGA RETA USD

3 INTERFACE BOARD | 33

Table 2: Temperature Connector

Connector | Pin | Net | Comment
J5 | 1 | GND | PtRTD1 return
J5 | 2 | GND | PtRTD2 return
J5 | 3 | GND | PtRTD3 return
J5 | 4 | GND | PtRTD4 return
J5 | 5 | GND | PtRTD5 return
J5 | 6 | GND | PtRTD6 return
J5 | 7 | GND | PtRTD7 return
J5 | 8 | GND | PtRTD8 return
J5 | 9 | GND | PtRTD9 return
J5 | 10 | GND | PtRTD10 return
J5 | 11 | GND | PtRTD11 return
J5 | 12 | GND | PtRTD12 return
J5 | 17 | PtRTD1
J5 | 18 | PtRTD2
J5 | 19 | PtRTD3
J5 | 20 | PtRTD4
J5 | 21 | PtRTD5
J5 | 22 | PtRTD6
J5 | 23 | PtRTD7
J5 | 24 | PtRTD8
J5 | 25 | PtRTD9
J5 | 26 | PtRTD10
J5 | 27 | PtRTD11
J5 | 28 | PtRTD12
J5 | 14 | +15 | HTR1 return
J5 | 15 | +15 | HTR2 return
J5 | 16 | +15 | HTR3 return
J5 | 29 | HTR1-
J5 | 30 | HTR2-
J5 | 31 | HTR3-

## 3 Interface Board

### 3.1 Building blocks

### 3.1.1 Drivers for high capacitance (parallel) clocks

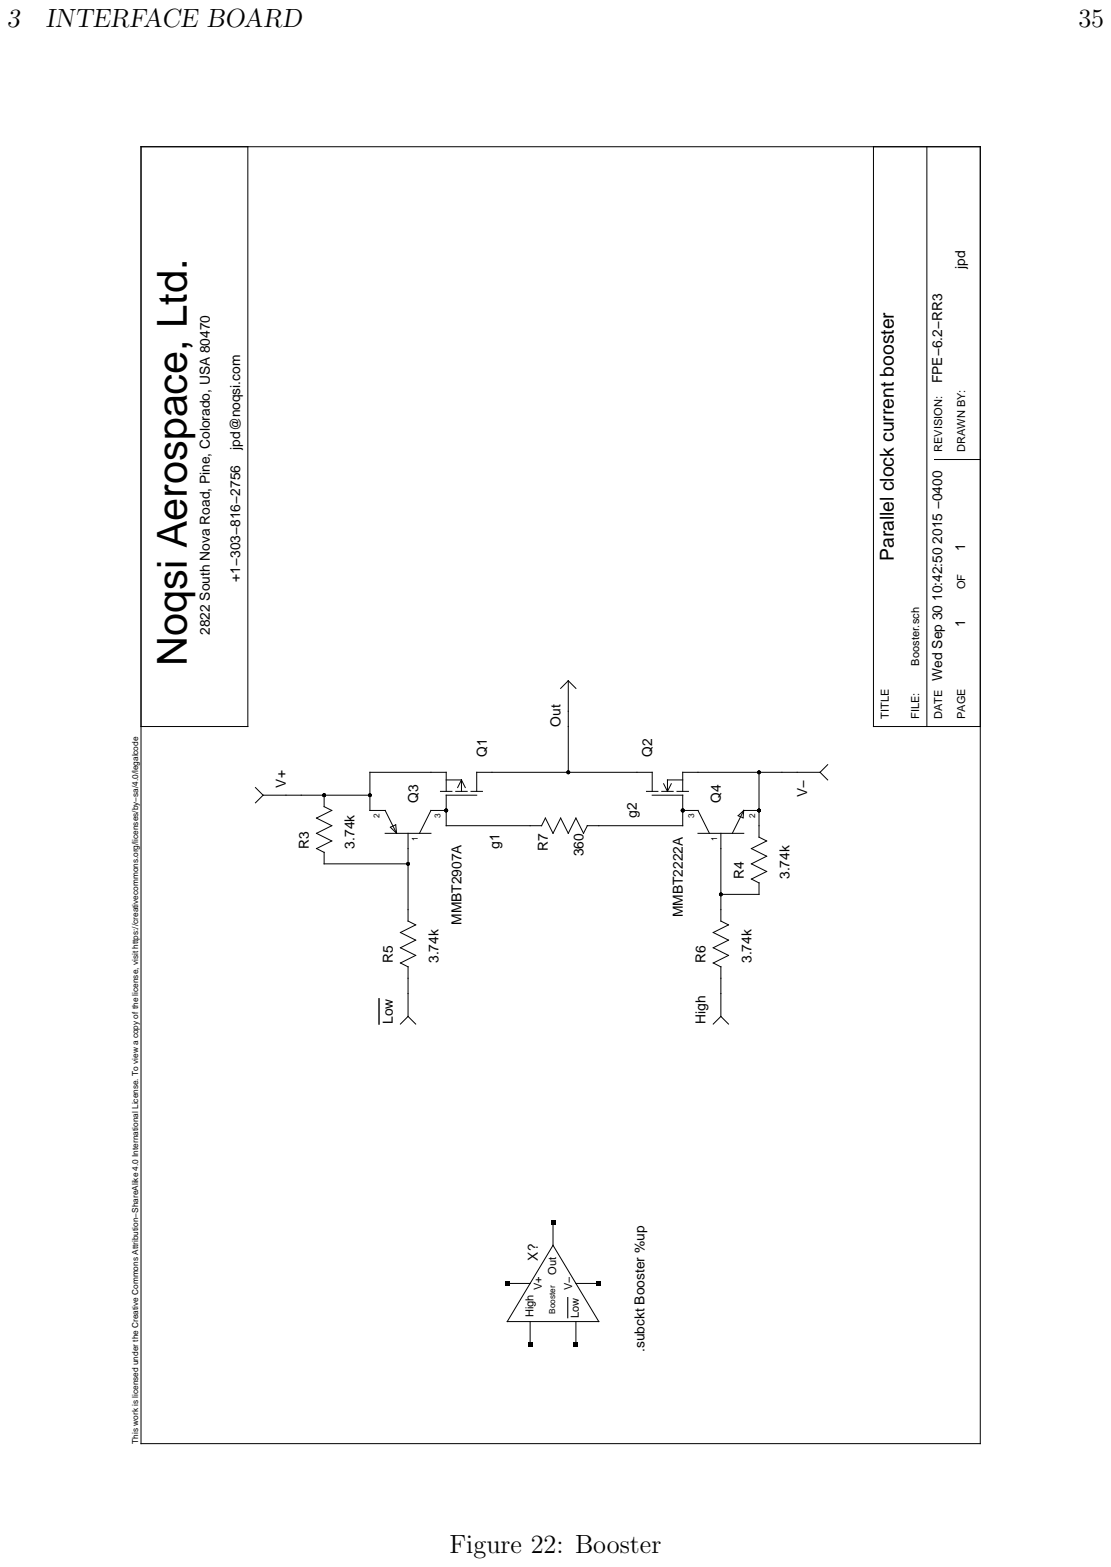
[picture p204: page 36]

2822 South Nova Road, Pine, Colorado, USA 80470

Parallel clock current booster

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

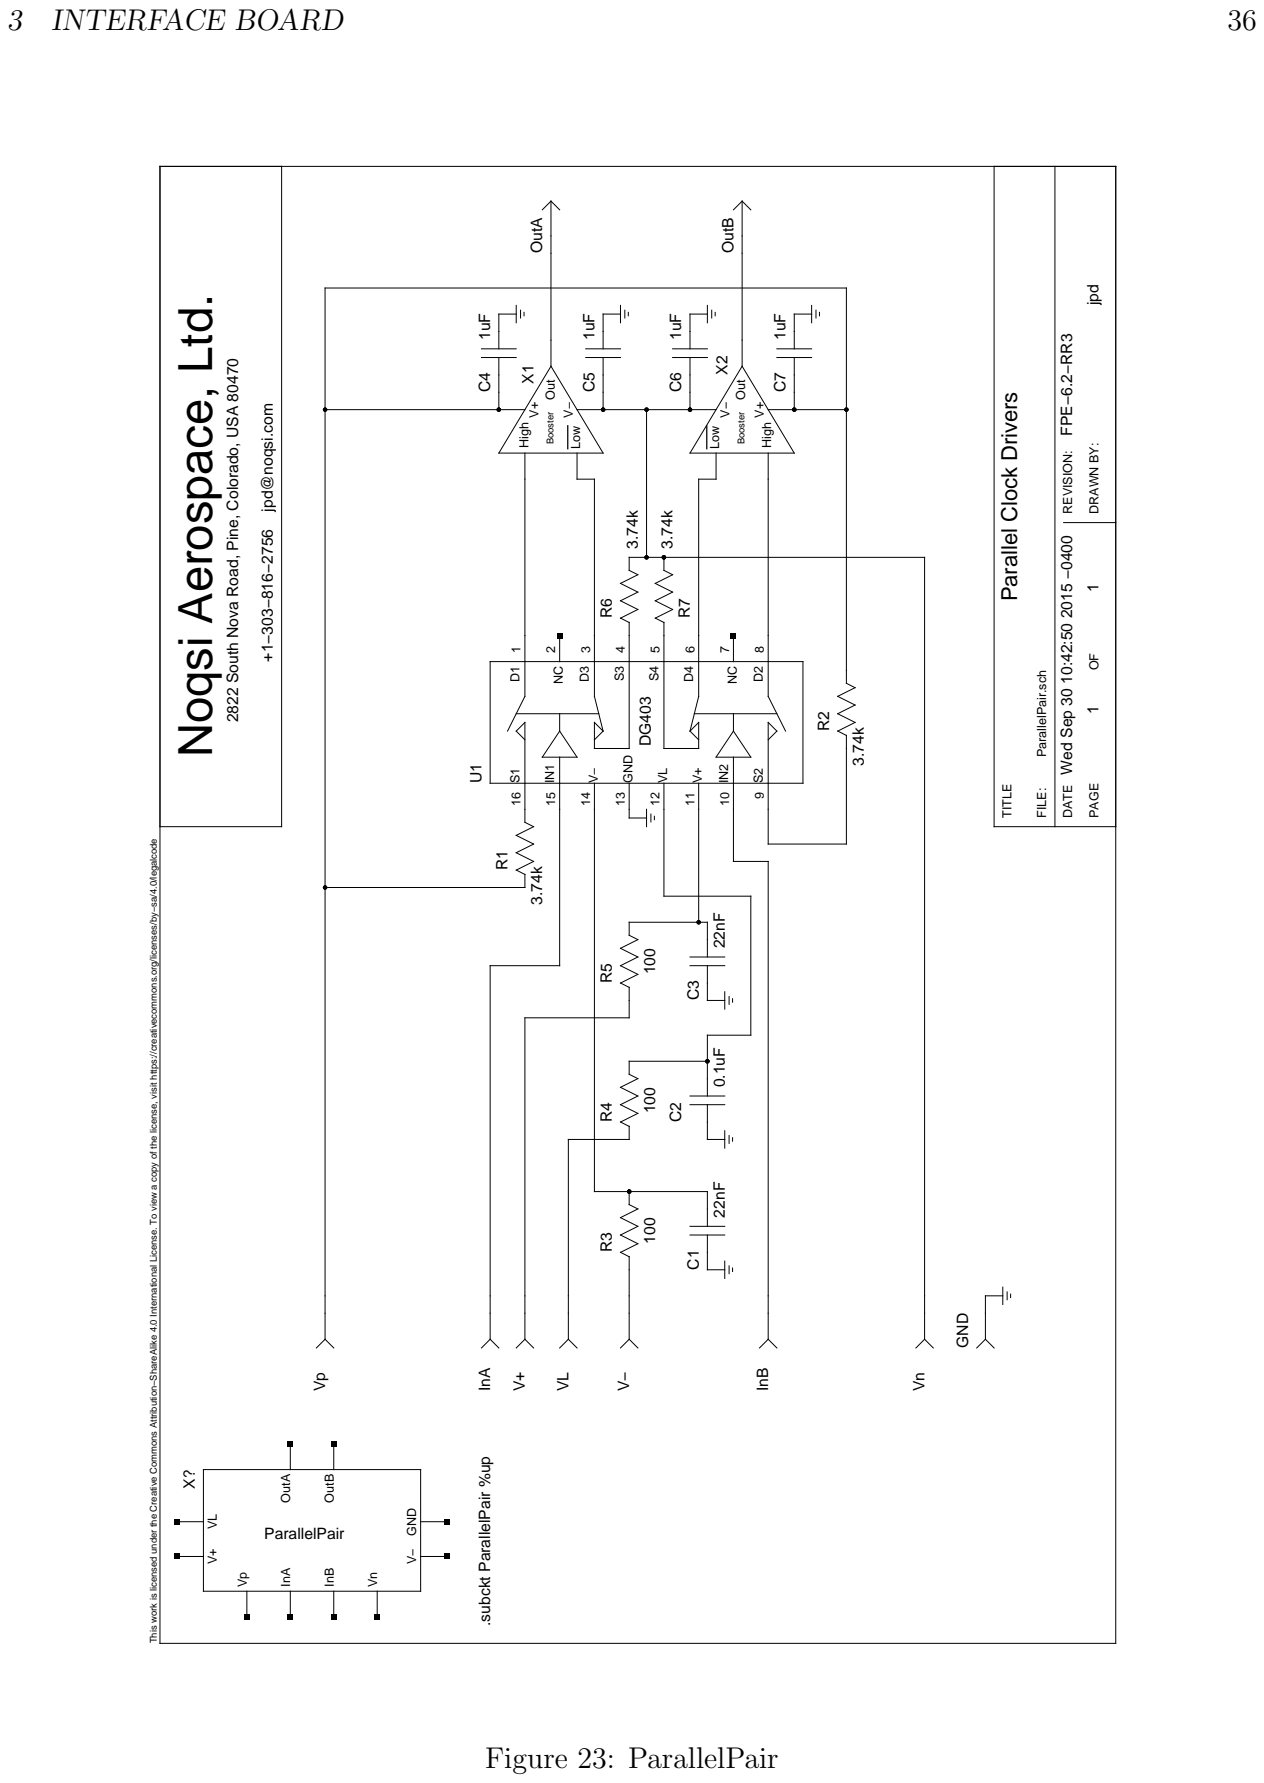
[picture p205: page 37]

2822 South Nova Road, Pine, Colorado, USA 80470

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

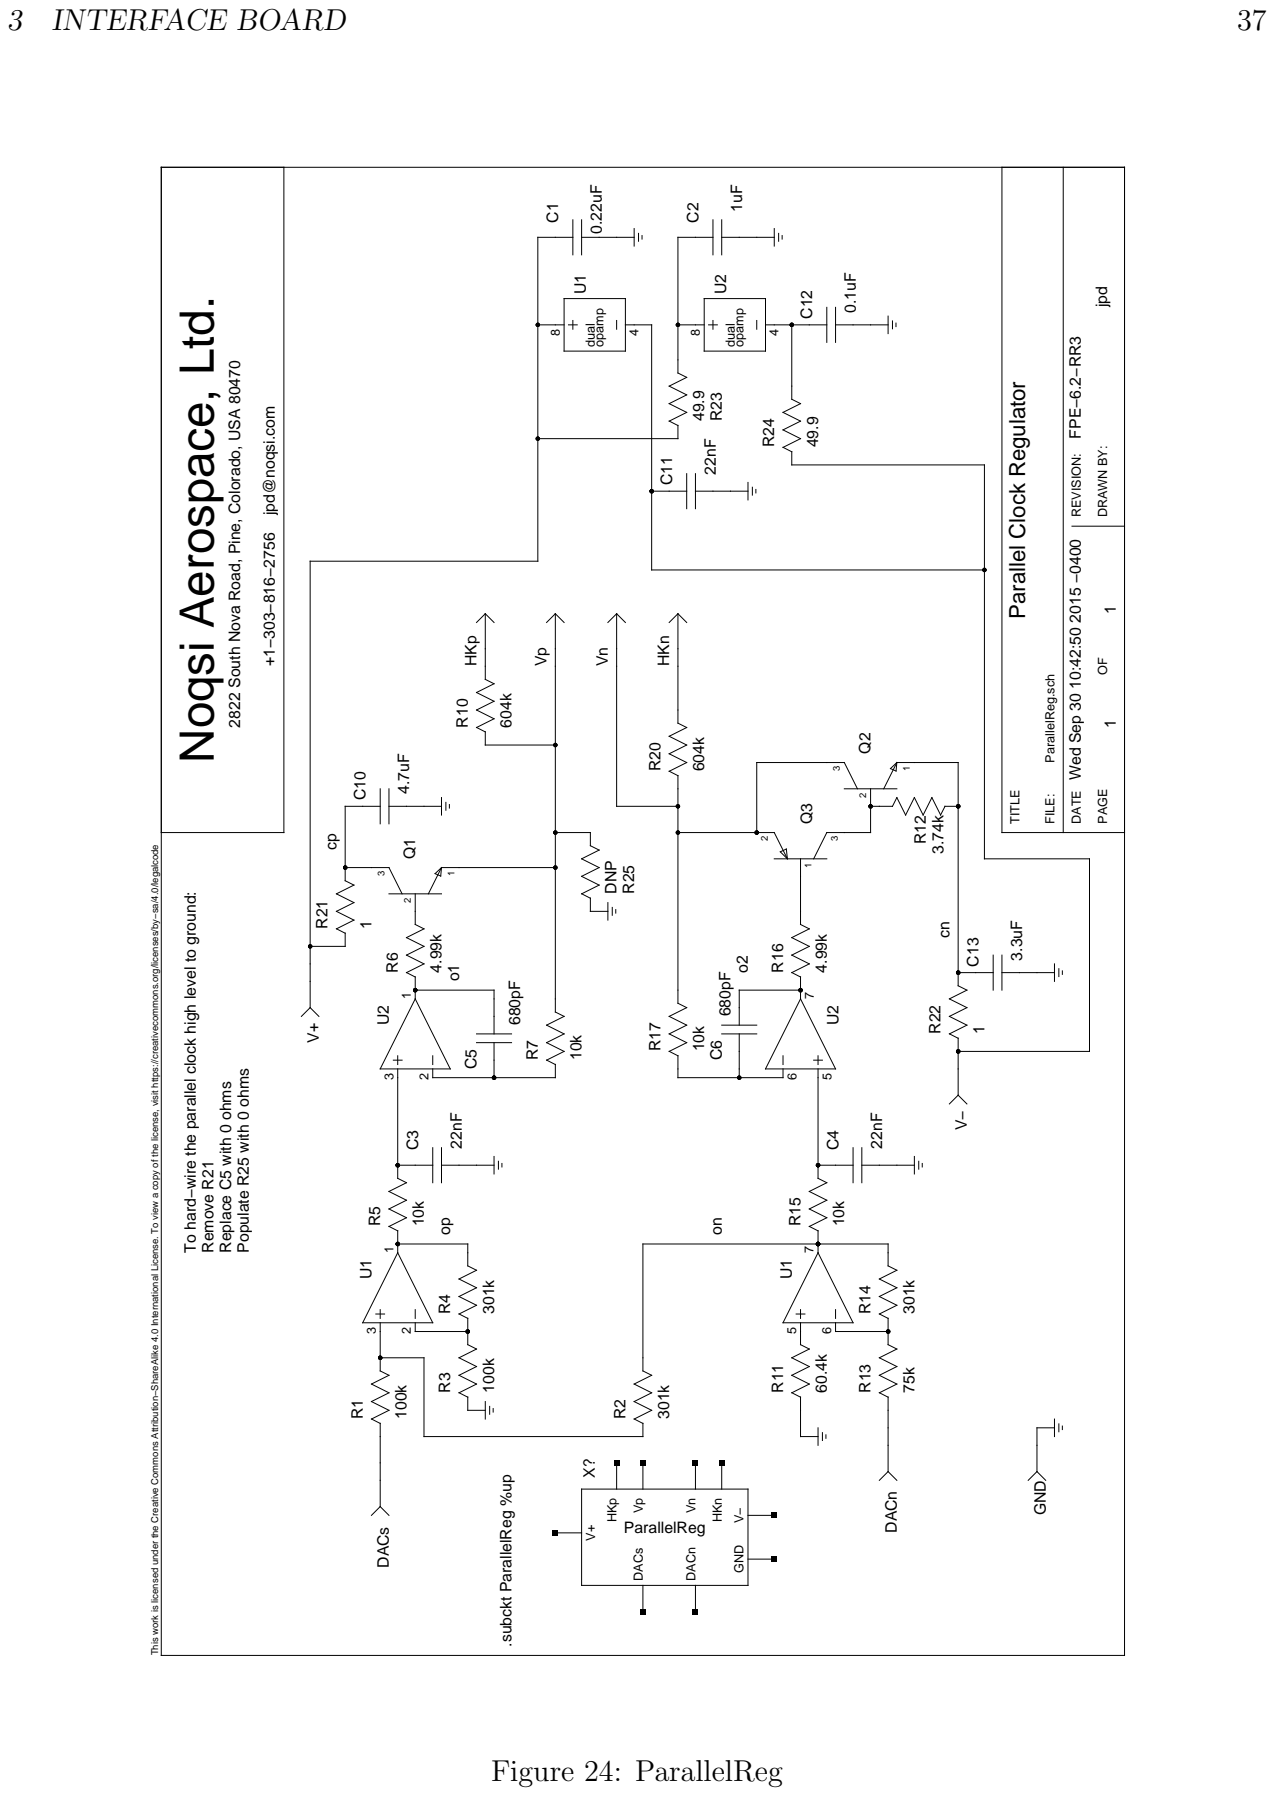
[picture p206: page 38]

2822 South Nova Road, Pine, Colorado, USA 80470

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

To hard−wire the parallel clock high level to ground:

### 3.1.2 Drivers for low capacitance clocks

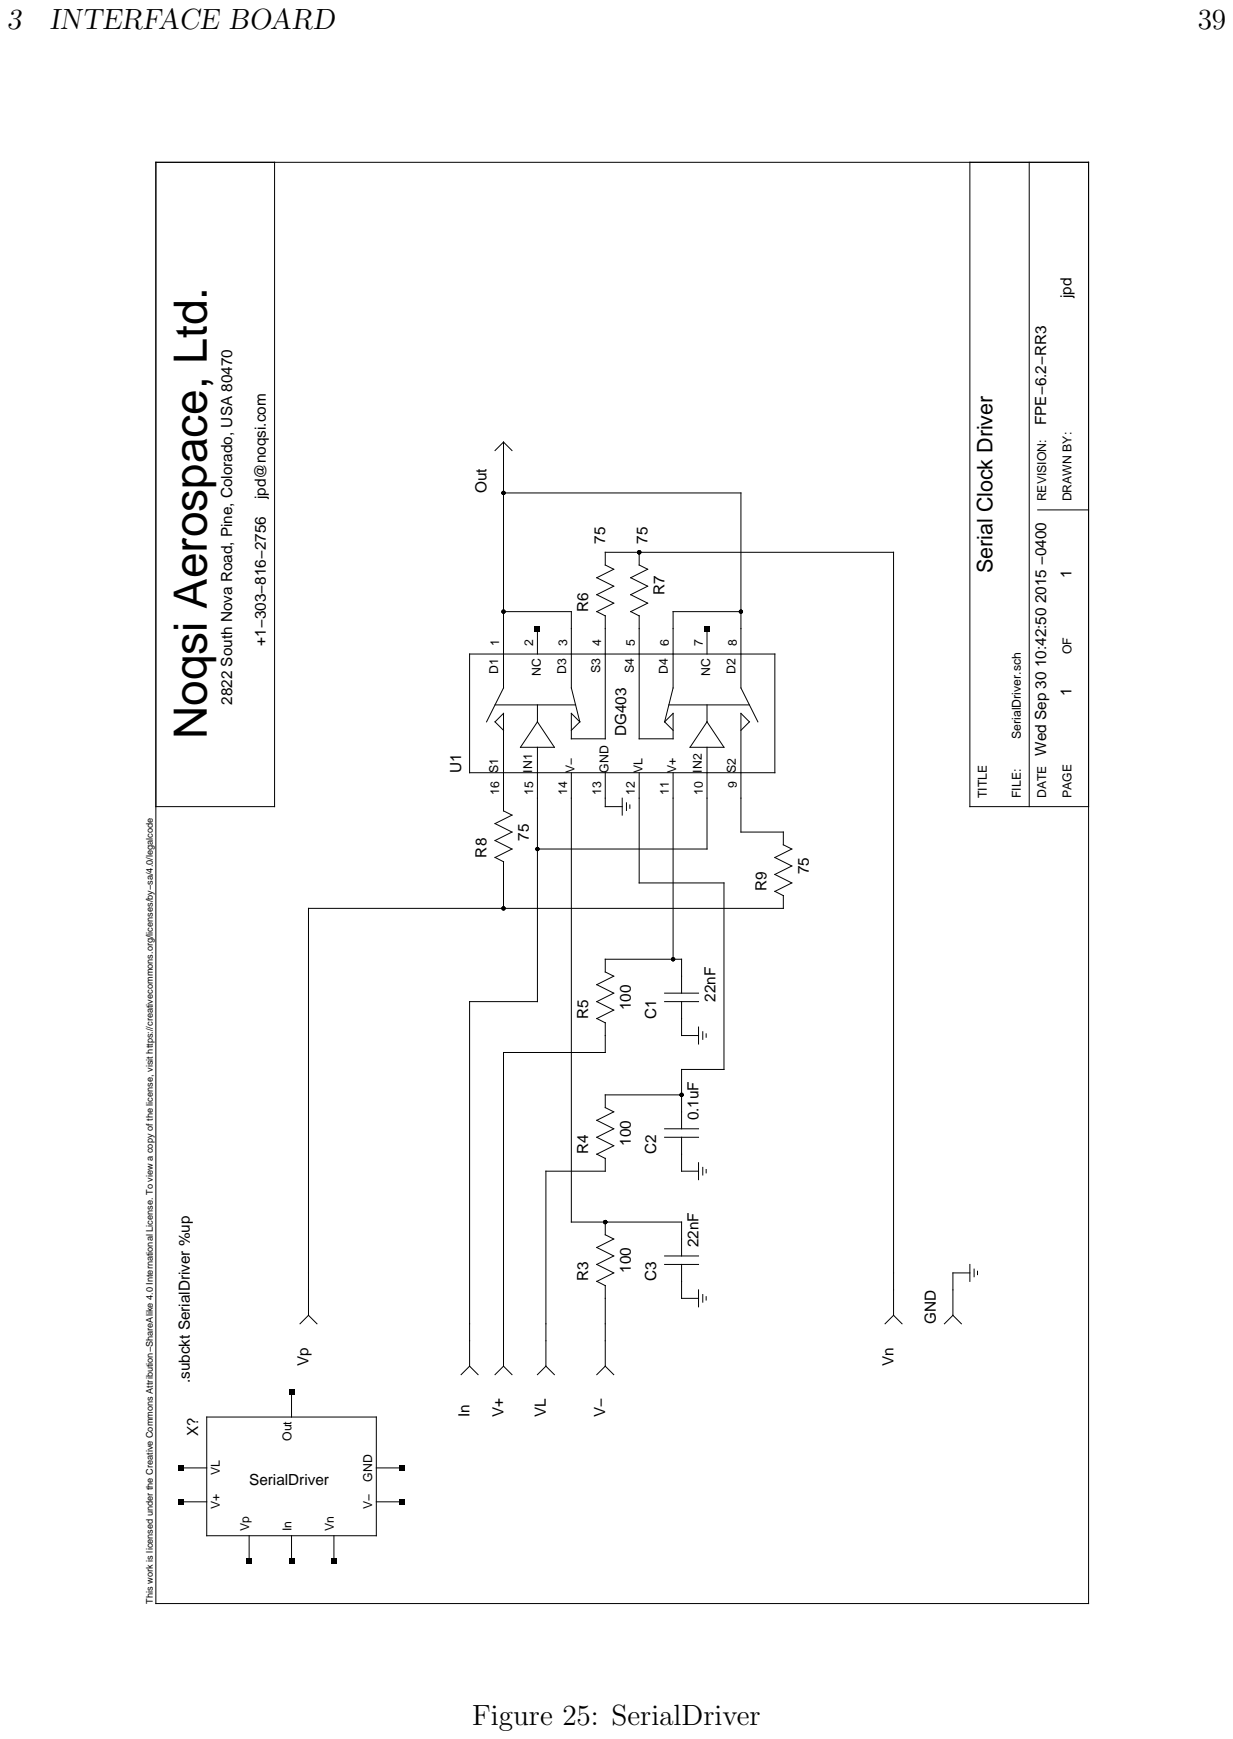
[picture p207: page 40]

2822 South Nova Road, Pine, Colorado, USA 80470

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

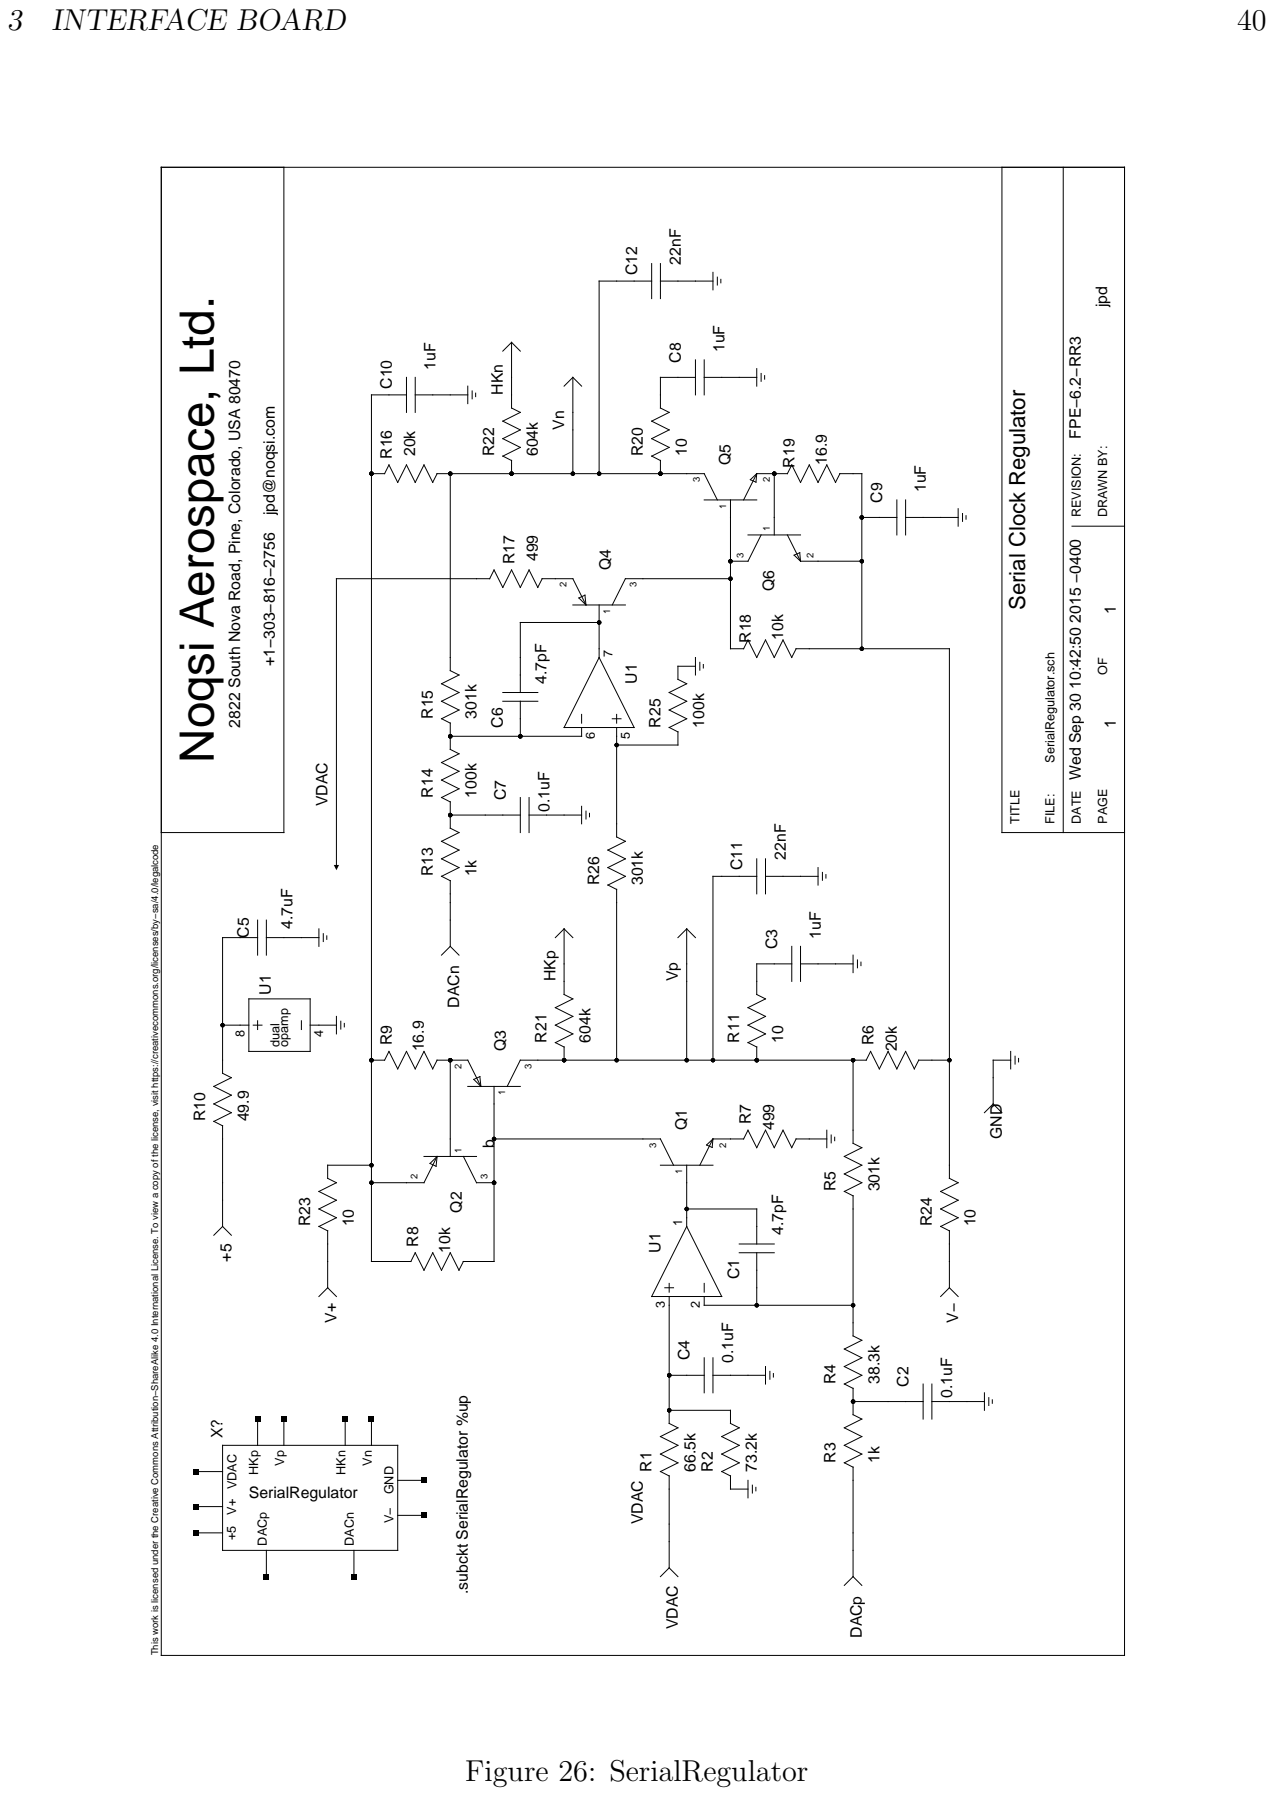
[picture p208: page 41]

2822 South Nova Road, Pine, Colorado, USA 80470

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

### 3.1.3 Clock drivers for one CCD

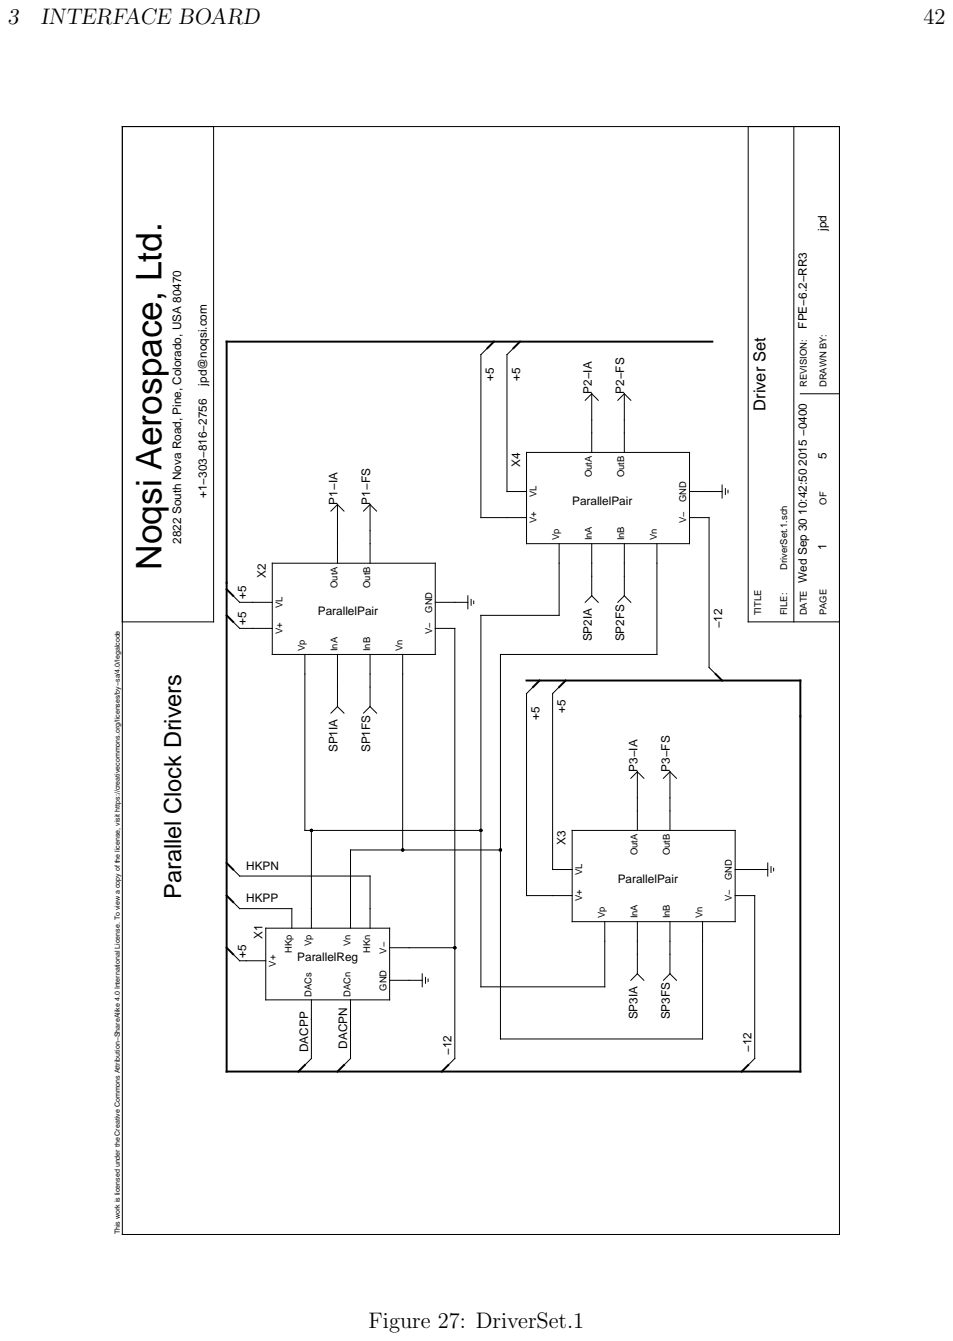
[picture p209: page 43]
FILE:; REVISION:; DRAWN BY:; TITLE; DATE; PAGE OF; jpd; DriverSet.1.sch; Driver Set; InA; InB; V− GND; OutA; ParallelPair; OutB; Vp DACs; DACn Vn; HKp ParallelReg; HKn; DACPP; DACPN; HKPP; HKPN; Figure 27: DriverSet.1

Noqsi Aerospace, Ltd.

Wed Sep 30 10:42:50 2015 −0400 FPE−6.2−RR3

2822 South Nova Road, Pine, Colorado, USA 80470

+1−303−816−2756 jpd@noqsi.com

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

Parallel Clock Drivers

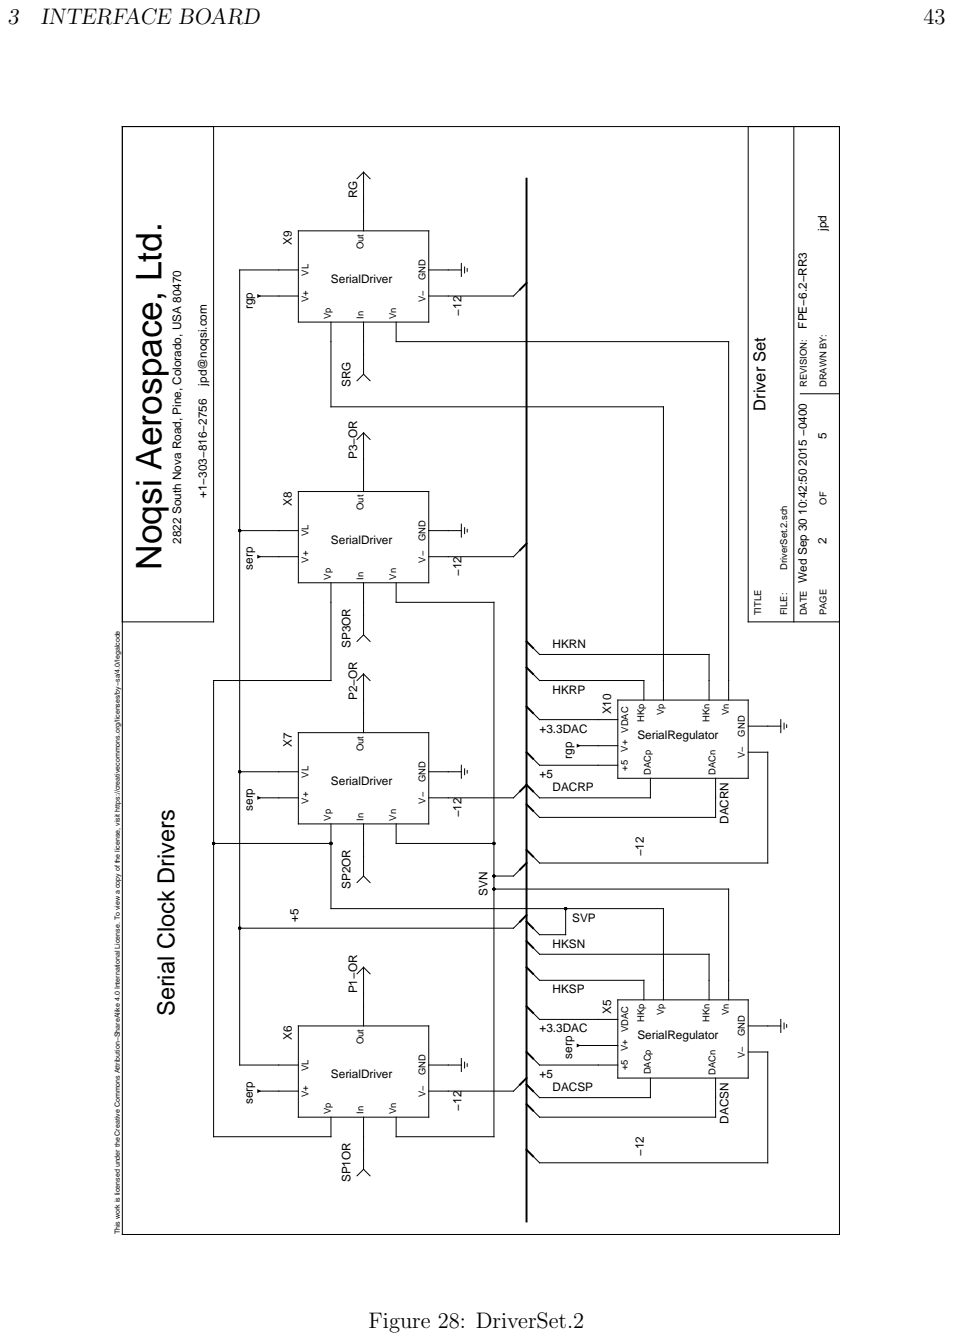
[picture p210: page 44]
FILE:; REVISION:; DRAWN BY:; TITLE; DATE; PAGE OF; jpd; DriverSet.2.sch; Driver Set; DACn; V+ VDAC; V− GND; DACp; SerialRegulator; HKp; HKn; Out; SerialDriver; SVP; SVN; serp; HKSP; HKSN; DACSP; DACSN; +3.3DAC; HKRP; HKRN; DACRP; DACRN; serp serp; serp rgp; rgp; Figure 28: DriverSet.2

SRG P1−OR SP1OR SP2OR P2−OR SP3OR P3−OR RG

Noqsi Aerospace, Ltd.

Wed Sep 30 10:42:50 2015 −0400 FPE−6.2−RR3

2822 South Nova Road, Pine, Colorado, USA 80470

+1−303−816−2756 jpd@noqsi.com

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

Serial Clock Drivers

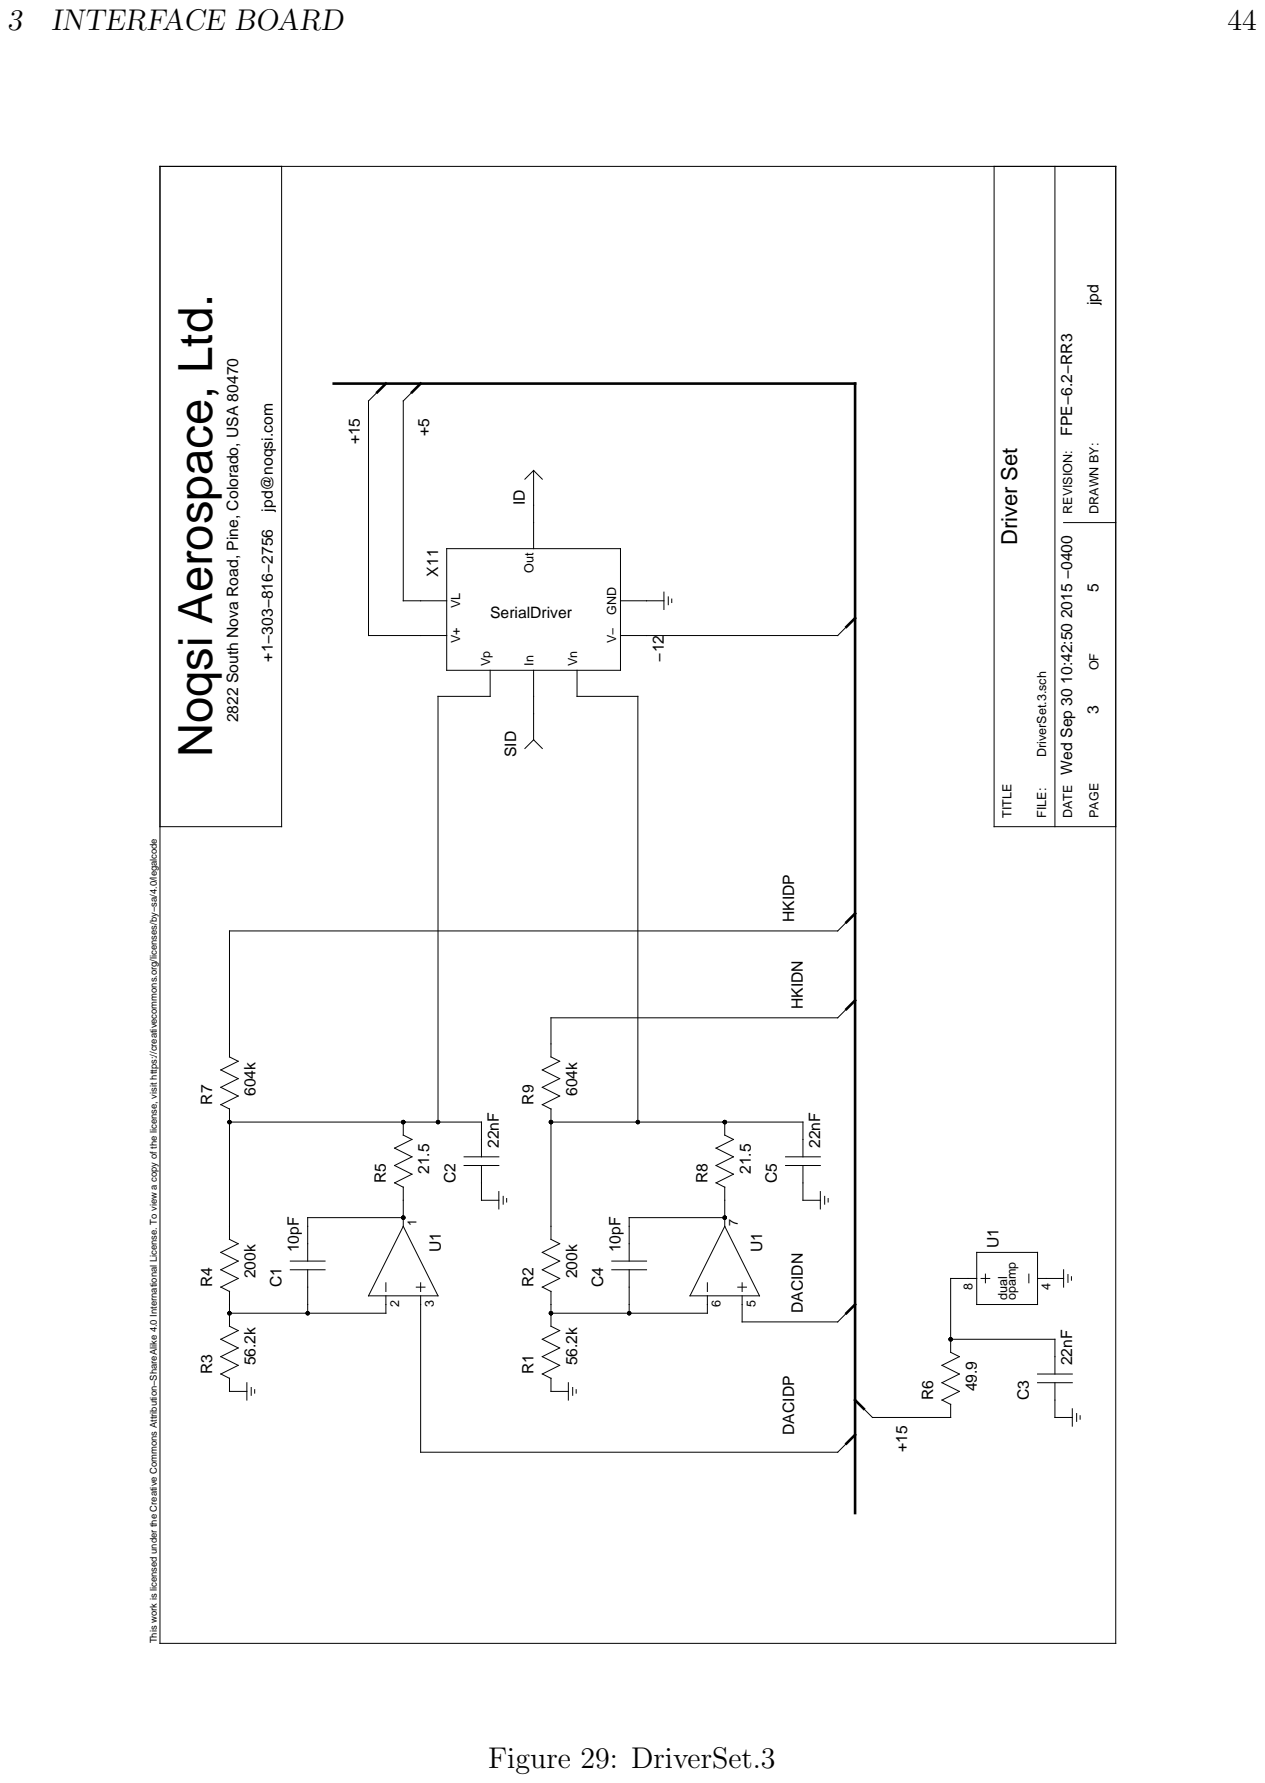
[picture p211: page 45]

2822 South Nova Road, Pine, Colorado, USA 80470

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

DACIDN DACIDP HKIDN HKIDP

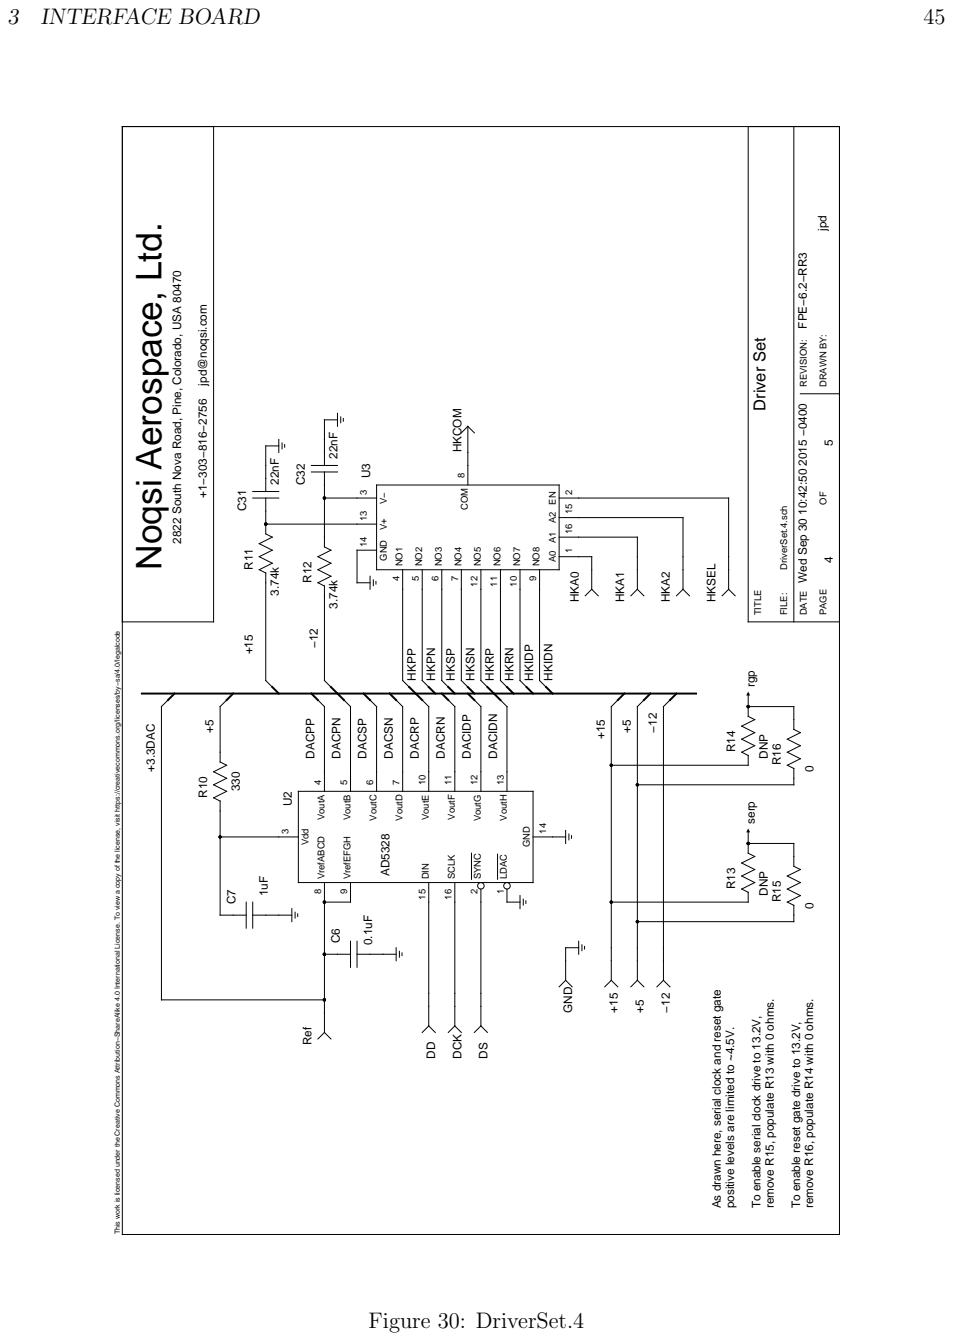
[picture p212: page 46]

2822 South Nova Road, Pine, Colorado, USA 80470

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

As drawn here, serial clock and reset gate

remove R15, populate R13 with 0 ohms.

remove R16, populate R14 with 0 ohms.

positive levels are limited to ~4.5V.

To enable serial clock drive to 13.2V,

To enable reset gate drive to 13.2V,

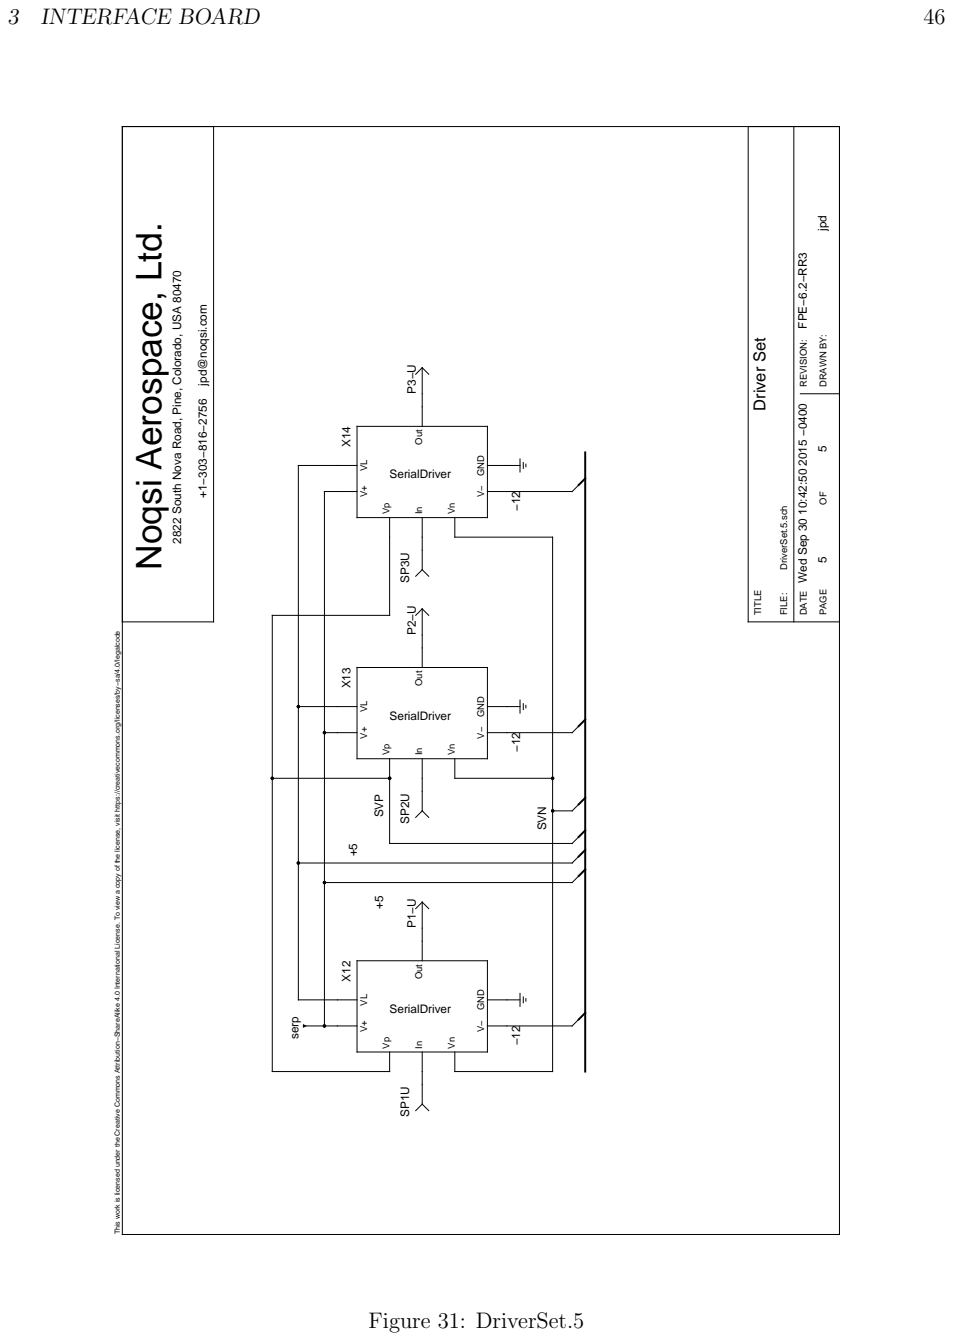
[picture p213: page 47]
FILE:; REVISION:; DRAWN BY:; TITLE; DATE; PAGE OF; jpd; DriverSet.5.sch; Driver Set; V− GND; Out; SerialDriver; SVP; SVN; serp; Figure 31: DriverSet.5

Noqsi Aerospace, Ltd.

Wed Sep 30 10:42:50 2015 −0400 FPE−6.2−RR3

2822 South Nova Road, Pine, Colorado, USA 80470

+1−303−816−2756 jpd@noqsi.com

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

### 3.1.4 Power conditioning

Figure 32 shows the power regulators for the Artix FPGA. An RC filter on the reference insures that the 1.8V AUX power rises more slowly than the 1V core power. The 2.5V and 3.3V IO power follow the 1.8V AUX power with additional delays. This insures proper initialization. Q5 pulls down the 3.3V IO power if the 1.8V level is low, insuring that the rated maximum 2.625V difference cannot be exceeded for more than the allowed time (see Xilinx data sheet DS181). The resistors on the collectors of the pass transistors limit the surge current, and are rated to handle the fault current if the FPGA should latch up.

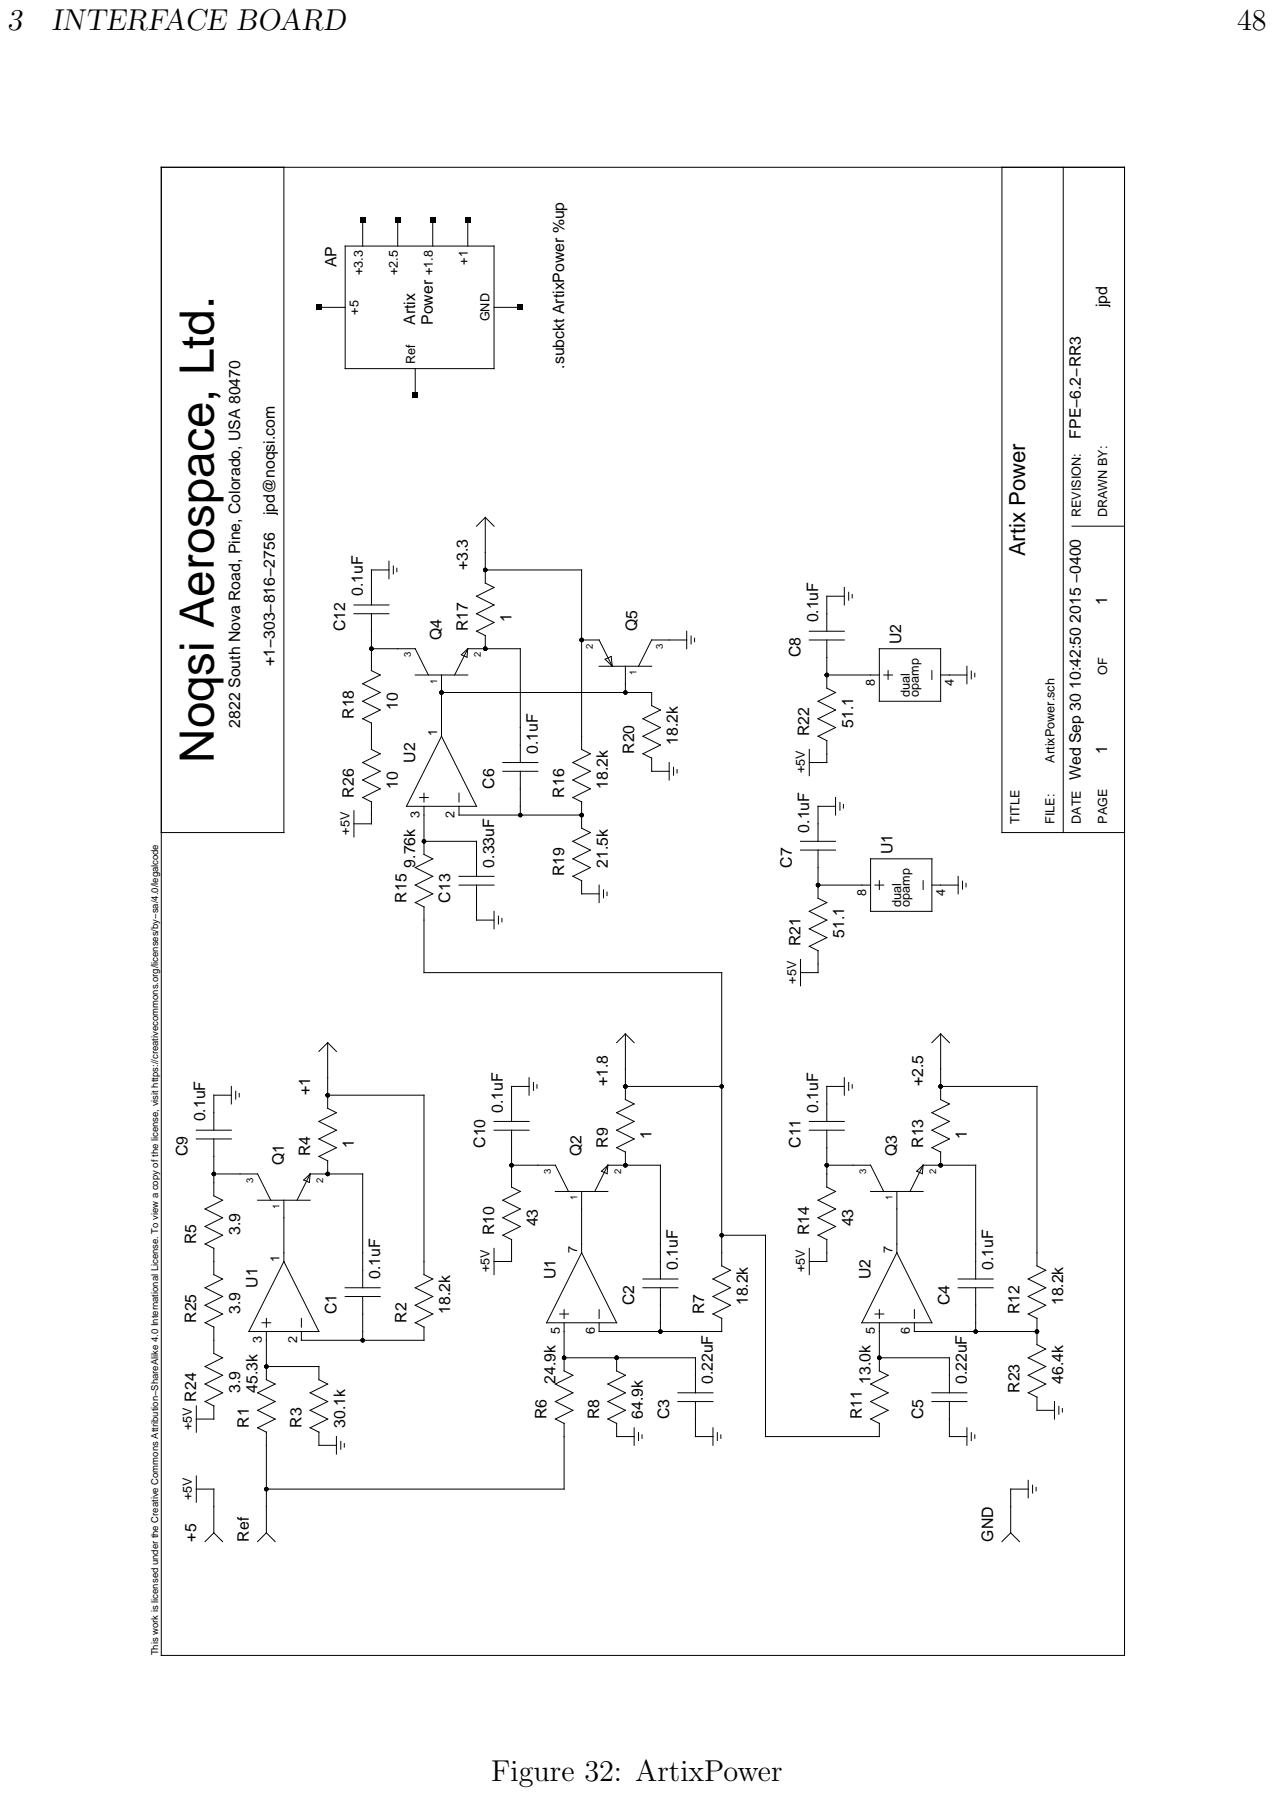
[picture p214: page 49]

2822 South Nova Road, Pine, Colorado, USA 80470

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
