TESScience/FPE/Releases/FPE-6.1-RR4/Driver.pdf

2822 South Nova Road, Pine, Colorado, USA 80470

Parallel clock current booster


2822 South Nova Road, Pine, Colorado, USA 80470


2822 South Nova Road, Pine, Colorado, USA 80470


2822 South Nova Road, Pine, Colorado, USA 80470


2822 South Nova Road, Pine, Colorado, USA 80470

FILE:; REVISION:; DRAWN BY:; TITLE; DATE; PAGE OF; jpd; DriverSet.1.sch; Driver Set; InA; InB; V− GND; OutA; ParallelPairOutB; Vp DACs; DACn Vn; HKp ParallelReg; HKn; DACPP; DACPN; HKPP; HKPN

Noqsi Aerospace, Ltd.

Wed Apr 22 11:45:20 2015 −0600 FPE−6.1−RR4

2822 South Nova Road, Pine, Colorado, USA 80470

+1−303−816−2756 jpd@noqsi.com

Parallel Clock Drivers

FILE:; REVISION:; DRAWN BY:; TITLE; DATE; PAGE OF; jpd; DriverSet.2.sch; Driver Set; DACn; V+ VDAC; V− GND; DACp; SerialRegulator HKp; HKn; Out; SerialDriver; SVP; SVN; HKSP; HKSN; DACSP; DACSN; +3.3DAC; HKRP; HKRN; DACRP; DACRN

SRG P1−OR SP1OR SP2OR P2−OR SP3OR P3−OR RG

Noqsi Aerospace, Ltd.

Wed Apr 22 11:45:20 2015 −0600 FPE−6.1−RR4

2822 South Nova Road, Pine, Colorado, USA 80470

+1−303−816−2756 jpd@noqsi.com

Serial Clock Drivers


2822 South Nova Road, Pine, Colorado, USA 80470

DACIDN DACIDP HKIDN HKIDP

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
