TESScience/FPE/(commit log)

2014-01-24 Check in working schems and symbols.
    [Booster.sch, Interface.1.sch, Interface.2.sch, Interface.3.sch, Interface.4.sch, Interface.5.sch, Interface.7.sch, Interface.8.sch]
2014-01-24 Add missing Interface.6
    [Interface.6.sch]
2014-01-24 Add missing SerialDriver
    [SerialDriver.sch]
2014-01-25 Begin modularizing clock drivers per CCD
    [DriverSet.1.sch, Interface.5.sch, SerialDriver.sch]
2014-01-25 Set ParallelReg range with zeners
    [ParallelReg.sch]
2014-01-26 Clean up parallel driver schematic Add serials to DriverSet Remove driver pages from top-level interface schems
    [DriverSet.1.sch, DriverSet.2.sch, Interface.3.sch]
2014-01-26 IO pins for parallel and serial clocks in driver set.
    [DriverSet.1.sch, DriverSet.2.sch]
2014-01-27 Fix R5 footprint
    [ParallelPair.sch]
2014-01-27 ID driver
    [DriverSet.3.sch]
2014-01-27 Driver set now believed complete
    [DriverSet.1.sch, DriverSet.2.sch, DriverSet.3.sch, DriverSet.4.sch, SerialDriver.sch]
2014-01-29 Putting interface pieces together
    [Interface.1.sch, Interface.10.sch, Interface.11.sch, Interface.12.sch, Interface.3.sch, Interface.4.sch, Interface.9.sch]
2014-01-30 Renumber schematics, add missing bits
    [Interface.1.sch, Interface.10.sch, Interface.11.sch, Interface.12.sch, Interface.2.sch, Interface.3.sch, Interface.4.sch, Interface.5.sch]
2014-01-30 Nothing known missing from interface schematics
    [Interface.9.sch]
2014-01-30 Did a refdes_renum
    [Interface.2.sch, Interface.3.sch, Interface.4.sch, Interface.5.sch, Interface.6.sch, Interface.7.sch, Interface.8.sch, Interface.9.sch]
2014-01-31 Fill in pin numbers on stacking connectors
2014-01-31 Can now build Interface netlist and BOM
    [Booster.sch, DriverSet.4.sch, Interface.3.sch, ParallelPair.sch]
2014-01-31 Two 68 pin connectors for interconnect
2014-01-31 Stack connector part numbers. Fix symbol versions.
    [Interface.1.sch, Interface.2.sch, Interface.4.sch]
2014-01-31 Fix MOSFET packages in booster.
    [Booster.sch, SerialRegulator.sch]
2014-02-05 Add -30V supply for substrate bias regulator
    [Interface.1.sch, Interface.4.sch, Minus30.sch]
2014-02-05 Specs and footprints for headers
    [Interface.4.sch]
2014-02-05 Add Minus30 schematic to docs
2014-02-05 Three flat LEDs, NICER style.
    [Interface.4.sch, Interface.9.sch]
2014-02-06 Fix BOM issues found by Joel
    [ParallelReg.sch, SerialDriver.sch]
2014-02-06 Fix typos and footprints
    [DriverSet.2.sch, Interface.1.sch, Minus30.sch, ParallelReg.sch]
2014-02-11 Proceeding with video redesign
    [PerChip.1.sch, PerChip.2.sch, PerChip.3.sch, PerChip.4.sch, PerChip.5.sch, PerChip.6.sch, Video.1.sch, chain.sch]
2014-02-11 Per chip DACS and HK for video
    [PerChip.7.sch, PerChip.8.sch]
2014-02-13 Reorganize per-chip and chain stuff
    [Chain.1.sch, Chain.2.sch, PerChip.2.sch, PerChip.5.sch, PerChip.6.sch, PerChip.7.sch, Video.1.sch, chain.sch]
2014-02-13 Add RTD readout
    [Video.5.sch]
2014-02-17 Continue with Video. Move Interface HK/DAC to high addresses. 10 pin JTAG for ARM.
    [Chain.1.sch, Interface.4.sch, Interface.5.sch, Interface.6.sch, Interface.7.sch, Interface.8.sch, Interface.9.sch, PerChip.6.sch]
2014-02-17 Finish HK/DAC decoding.
    [Video.5.sch, Video.6.sch]
2014-02-17 Add missing video pages
    [Video.2.sch, Video.3.sch, Video.4.sch, Video.5.sch, Video.6.sch]
2014-02-17 Refdeses and nits
    [Chain.1.sch, Chain.2.sch, PerChip.1.sch, PerChip.2.sch, PerChip.3.sch, PerChip.4.sch, PerChip.5.sch, PerChip.6.sch]
2014-02-17 Make builds video netlist and BOM
    [Video.5.sch]
2014-02-18 Fix some DRC errors
    [PerChip.2.sch, PerChip.4.sch, PerChip.5.sch, Video.5.sch, Video.6.sch]
2014-02-20 Fix CCD numbers
    [Interface.5.sch, Interface.6.sch, Interface.7.sch, Interface.8.sch]
2014-02-20 Preliminary CCD connector OG filters Temperature connector
    [CCD-51pin.tsv, PerChip.2.sch, PerChip.5.sch, Video.1.sch, Video.2.sch, Video.3.sch, Video.4.sch, Video.5.sch]
2014-02-20 Build the whole video board Fix error in 51 pin
    [CCD-51pin.tsv]
2014-02-20 Add GND
    [PerChip.6.sch]
2014-02-22 Fix temp mux decoding
    [Video.5.sch]
2014-03-02 Fix U1 conflict. Fix DS64 naming error.
    [Interface.2.sch, Interface.5.sch]
2014-03-02 Fix ADC128 footprint for proto
    [Interface.2.sch]
2014-03-31 51 pin connector pinouts from Gerry
    [CCD-51pin.tsv]
2014-04-04 Fix connector types. 8 pin power for opamps.
    [PerChip.2.sch, PerChip.3.sch, PerChip.4.sch, PerChip.5.sch, Video.2.sch, Video.5.sch]
2014-04-16 Add heater
    [Video.6.sch, Video.8.sch]
2014-04-16 Renumber stuff for added heaters.
    [Video.1.sch, Video.2.sch, Video.3.sch, Video.4.sch, Video.5.sch, Video.6.sch, Video.7.sch, Video.8.sch]
2014-06-05 Fix R12 footprint Better BOM
    [ParallelReg.sch, Video.1.sch, Video.2.sch, Video.3.sch, Video.4.sch, Video.5.sch, Video.6.sch, Video.7.sch]
2014-06-12 Fix improper JTAG hardware selection Put the Booster in the list of doc files
    [Interface.4.sch]
2014-07-01 DAC and HKADC drivers to ROM application
2014-07-01 Wink LEDs
2014-07-01 Clock -30V generator.
2014-07-11 Add a couple of missing files.
2014-08-12 Fix ADCref voltage 4->3
    [Chain.2.sch]
2014-08-13 New video chain using SPST only
    [Chain.1.sch, Chain.2.sch, PerChip.1.sch, PerChip.2.sch, PerChip.3.sch, PerChip.4.sch, PerChip.5.sch, PerChip.6.sch]
2014-08-19 Start reducing opamp power Check in sim stuff
    [ChainTest.sch, MAX4594.sch, PerChip.2.sch, max4636.sch, max4636sw.sch]
2014-08-22 Noise sim
    [Chain.1.sch, Chain.2.sch, ChainNoise.sch, ChainTest.sch]
2014-09-11 Fix pin swap on CCD connector. Fix weird filename case mutation.
    [CCD-51pin.tsv]
2014-09-12 Six switch chain.
    [Chain.1.sch, Chain.2.sch]
2014-09-12 More six switch chain support
    [PerChip.1.sch, PerChip.2.sch, Video.1.sch, Video.2.sch, Video.3.sch, Video.4.sch]
2014-09-16 Simulate new chain Test board for new chain
    [Chain.1.sch, Chain.2.sch, ChainNoise.sch, ChainTest.sch, DampReg.sch, PerChip.1.sch, PerChip.test.sch, Video.chaintest.1.sch]
2014-09-16 Makefile for test board
2014-09-16 Fix some net names
    [Video.chaintest.1.sch]
2014-09-16 Add missing GND Depend on subschems Fix attribute conflicts
    [Chain.2.sch, PerChip.test.sch]
2014-09-16 Fix attribute conflict
    [Video.chaintest.6.sch]
2014-09-16 Split ADC bypass cap
    [Chain.1.sch, Chain.2.sch]
2014-09-18 Change opamps and power arrangements for V6
    [Chain.1.sch, PerChip.1.sch, PerChip.2.sch, PerChip.3.sch, PerChip.4.sch, PerChip.5.sch, PerChip.6.sch, PerChip.7.sch]
2014-09-18 Change opamps and power for V6
    [drain_regulator.sch]
2014-09-23 Fix DRC errors.
    [PerChip.2.sch, Video.1.sch, Video.2.sch, Video.3.sch, Video.4.sch, Video.6.sch]
2014-09-23 Dates and version numbers for 6.0
    [Chain.1.sch, Chain.2.sch, PerChip.1.sch, PerChip.2.sch, PerChip.3.sch, PerChip.4.sch, PerChip.5.sch, PerChip.6.sch]
2014-09-24 First checkin of Artix pin map
    [Artix_pinout-Table_1.tsv]
2014-09-26 Start changing to Artix
    [ArtixPower.sch, Interface.1.sch, Interface.2.sch, Interface.4.sch, Interface.9.sch]
2014-09-26 Put some contents in ArtixPower
    [ArtixPower.sch]
2014-09-26 Artix Power sim
    [AP.sch, ArtixPower.sch]
2014-09-28 Tune up ArtixPower in simulation
    [AP.sch, APSC.sch, ArtixPower.sch]
2014-10-07 Fixed some attribute conflicts.
    [Video.6.sch]
2014-10-08 Be able to simulate J309 active load.
    [ChainTest.sch]
2014-10-14 More LEDs Artix bypass caps
    [Interface.10.sch, Interface.9.sch]
2014-10-15 Renumber capacitors
    [Interface.1.sch, Interface.10.sch, Interface.2.sch, Interface.9.sch]
2014-10-15 Acceptable footprint names for Allegro
    [Video.1.sch, Video.2.sch, Video.3.sch, Video.4.sch, Video.5.sch]
2014-10-23 Remove zeners from parallel reg. reset_regulator doesn't belong in interface docs.
    [Interface.9.sch, ParallelReg.sch]
2014-10-30 Artix test board checkin
    [Artix-signal-map.tsv, ArtixPinout.csv, ArtixPower.sch, ArtixTest.1.sch, ArtixTest.2.sch, ArtixTest.3.sch, ArtixTest.4.sch, ArtixTest.5.sch]
2014-10-30 Add LED for DONE_0, addressing issue 8.
    [ArtixTest.3.sch]
2014-10-30 Change JTAG connector to address issue #6.
    [ArtixTest.1.sch]
2014-10-31 Fixing up the BOM.
    [ArtixTest.1.sch, ArtixTest.2.sch, ArtixTest.3.sch, ArtixTest.4.sch]
2014-10-31 Fix up for Allegro
    [Artix-signal-map.tsv, ArtixTest.4.sch]
2014-11-11 Video changes for higher Vsub voltage
    [PerChip.5.sch]
2014-11-14 Fix 3.3V
    [ArtixTest.3.sch]
2014-11-19 RTD resistance range is now 500 to 1500 ohms.
    [Interface.2.sch]
2014-11-20 Change decoding on RTD channels to put them at 112-127 rather than 0-15. This will allow us to put them in the same "address space" as other housekeeping when we go to a single-input ADC on the V6 In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
    [Video.5.sch, Video.8.sch]
2014-11-21 Bunch of Interface updates for V6
    [DriverSet.1.sch, DriverSet.2.sch, DriverSet.3.sch, DriverSet.4.sch, Interface.1.sch, Interface.2.sch, Interface.3.sch, Interface.4.sch]
2014-11-25 Fix HV cap package. Relevant to issue 12.
    [PerChip.5.sch]
2014-11-25 Fix J5 to be MDM25 pads.
    [Video.5.sch]
2014-11-25 Another J5 instance with old pinout fixed
    [Video.8.sch]
2014-11-28 First draft of combined Vdd/substrate charge pump
    [Pump.sch]
2014-11-29 Bunch of changes for 6.0 Interface
    [Booster.sch, DriverSet.1.sch, DriverSet.2.sch, DriverSet.4.sch, Interface.4.sch, Interface.5.sch, Interface.6.sch, Interface.7.sch]
2014-11-30 Add HSK_ADC_104 pin to Artix-signal-map Treat CCD_ADC_Hold_pin and CCD_ADC_DeInt_pin as aliases for DeInt.
    [Artix-signal-map.tsv]
2014-12-01 Almost to 6.0 Interface
    [DriverSet.3.sch, Interface.1.sch, Interface.2.sch, Interface.3.sch, Interface.4.sch, Interface.5.sch, Interface.6.sch, Interface.7.sch]
2014-12-01 New Artix pinout with HK104 and five ID pins.
    [ArtixPinout.csv]
2014-12-01 Fix some capacitor specs.
    Five ID bits.
    [Artix-signal-map.tsv, ArtixPower.sch, DriverSet.3.sch, DriverSet.4.sch, Interface.1.sch, ParallelPair.sch, ParallelReg.sch, SerialDriver.sch]
2014-12-01 Add interconnect capacitance to chain sim.
    [ChainTest.sch]
2014-12-01 Add interconnect capacitance to chain sim.
    Makefile reflects new structure.
    [ChainTest.sch]
2014-12-02 Bunch of nits, dates, version numbers
    [Booster.sch, DriverSet.1.sch, DriverSet.2.sch, DriverSet.3.sch, DriverSet.4.sch, Interface.1.sch, Interface.2.sch, Interface.3.sch]
2014-12-03 Change bypass cap in ParallelPair
    [Interface.10.sch, ParallelPair.sch]
2014-12-03 LM195 and Vectron osc
    [Interface.1.sch]
2014-12-03 Footprint changes per Jeff's suggestions.
    [Interface.1.sch, PerChip.5.sch]
2014-12-03 Resistor on osc EFC. Order pages better in doc.
    [Interface.1.sch]
2014-12-04 Add survival heater
    [Interface.9.sch]
2014-12-07 Clean up Simulation directory
    [BoosterTest.sch, DampReg.sch, chnoise.sch, opNoise.sch]
2014-12-11 Fix osc INH.
    [ArtixTest.2.sch]
2014-12-15 Changes to enable more sims.
    [SerialDriver.sch, SerialRegulator.sch]
2014-12-15 Smaller resistors around DG403s
    [ParallelPair.sch, Pump.sch, SerialDriver.sch]
2014-12-22 Cap on HK I to V for 6.0
    [Interface.2.sch]
2014-12-25 Fix issue #35.
    [PerChip.2.sch, PerChip.3.sch, PerChip.4.sch]
2014-12-30 Abstract filter block design files.
    [AlgebraicFilt.sch]
2014-12-30 Serial driver SPICE simulation.
    [3phase.sch, SerialTest.sch]
2015-01-07 SPICE model modifications from testing
    [DG403.1.sch, DG403.2.sch]
2015-01-07 Fix Allegro export problems
    [Interface.4.sch]
2015-01-07 allegro-options was attached to a pin!
2015-01-08 Incorporate better DG403 model into serial sim
    [DG403.2.sch]
2015-01-09 Part number data base
    [partnumbers.tsv]
2015-01-12 Fix short circuits in Artix bypass caps section. More development of parts database.
    [Interface.10.sch, partnumbers.tsv]
2015-01-13 Fix LT2078 part number
    [partnumbers.tsv]
2015-01-15 Change C26 WV to address issue #38
    [PerChip.5.sch]
2015-01-17 Fix pin count data so that TO39 defaults to 3 pins.
2015-01-18 The Great Weekend Capacitor Munge
    [ArtixPower.sch, Chain.1.sch, Interface.9.sch, ParallelPair.sch, ParallelReg.sch, PerChip.2.sch, PerChip.3.sch, PerChip.4.sch]
2015-01-19 Add R37 to fix Issue #36
    [Video.8.sch]
2015-01-20 Fix capacitor symbol version to kill warning
    [Interface.2.sch]
2015-01-24 Add drain regulator to docs and change its file name to be LaTeX-friendly.
    [DrainRegulator.sch]
2015-03-02 Starting to refactor stack
    [Interface.1.sch, Interface.4.sch, Video.6.sch]
2015-03-25 Start moving things for 3 board system.
    [Driver.1.sch, Driver.2.sch, Interface.7.sch, Interface.8.sch]
2015-03-25 Move obsolete test schems aside.
    [Video-chaintest.1.sch, Video-chaintest.6.sch]
2015-03-25 Grab relevent changes from 6.0A to master branch.
    [Video.1.sch, Video.2.sch, Video.3.sch, Video.4.sch, Video.9.sch]
2015-03-25 New Video top level, with 6.0A and interfacing changes.
    [Video.1.sch, Video.2.sch, Video.3.sch, Video.4.sch, Video.6.sch, Video.8.sch]
2015-03-25 Remove redundant Video.9
    [Video.9.sch]
2015-03-25 Fold in 6.0A changes to chain and drain regulator.
    [Chain.1.sch, Chain.2.sch, DrainRegulator.sch]
2015-03-25 Remove blank pages
    [Interface.4.sch, Interface.7.sch, Interface.8.sch]
2015-03-25 Consolidate Interface schematics, change date attrs.
    [ArtixPower.sch, Booster.sch, DriverSet.1.sch, DriverSet.2.sch, DriverSet.3.sch, DriverSet.4.sch, Interface.1.sch, Interface.2.sch]
2015-03-25 Add R42 to drop a couple of volts to address issue #46
    [Chain.1.sch]
2015-03-26 Add upper serials to driver board.
    [Driver.1.sch, Driver.2.sch, DriverSet.1.sch, DriverSet.2.sch, DriverSet.3.sch, DriverSet.4.sch, DriverSet.5.sch]
2015-03-26 Upper serials on Interface board.
    [Interface.5.sch, Interface.6.sch]
2015-03-26 Consolidate resistor values.
    [Pump.sch]
2015-03-26 Retrofit heater driver from 6.0A
    [Video.8.sch]
2015-03-27 Added driver local 3.3V
    [Driver.3.sch]
2015-03-27 Removed obsolete Pin Maps, moved interface pin maps to new numbers
2015-03-27 ArtixPinout.csv should not be executable
    [ArtixPinout.csv]
2015-03-27 Introducing Driver build
2015-03-27 Cleaning up unecessary schematics
    [ArtixTest.1.sch, ArtixTest.2.sch, ArtixTest.3.sch, ArtixTest.4.sch, ArtixTest.5.sch, PerChip.test.sch, Video-chaintest.1.sch, Video-chaintest.6.sch]
2015-03-27 Straighten up some connector designations.
    [Driver.3.sch, Interface.1.sch, Video.1.sch, Video.2.sch, Video.3.sch, Video.4.sch]
2015-03-27 More connector renumbering.
    [Interface.1.sch, Interface.7.sch]
2015-03-27 DRC for Driver
2015-03-27 Fix misnamed IO symbol
    [DriverSet.5.sch]
2015-03-27 Eliminate one last instance of old stack connector. Fix some net names to reflect actual voltages.
    [PerChip.4.sch, PerChip.5.sch, PerChip.6.sch, PerChip.7.sch, PerChip.8.sch, Video.5.sch]
2015-03-28 Annotate Artix signal map with required changes.
    [Artix-signal-map.tsv]
2015-03-29 Fix 15/12 dyslexia
    [PerChip.1.sch, PerChip.2.sch, PerChip.3.sch, PerChip.4.sch, PerChip.5.sch, PerChip.6.sch, PerChip.7.sch, PerChip.8.sch]
2015-03-29 Fix dates/version for 6.1
    [ArtixPower.sch, Booster.sch, Chain.1.sch, Chain.2.sch, DrainRegulator.sch, Interface.2.sch, Interface.3.sch, Interface.4.sch]
2015-03-29 Fix page numbers
    [Interface.2.sch, Interface.3.sch, Interface.4.sch, Interface.5.sch, Interface.6.sch, Interface.7.sch]
2015-03-29 Separate upper and lower serials on 51 pin
2015-03-29 31 pin TempConn
    [Video.8.sch]
2015-03-29 Do 31 pin consistently
    [Video.5.sch, Video.8.sch]
2015-03-29 Don't track a data product
2015-03-29 Ignoring CCD-connectors.txt
2015-03-30 Credit to Matt Board-specific devfiles
2015-03-31 Areas for new stacking connectors.
2015-04-02 Date and tag in printed schems.
2015-04-03 Add LVDS buffers
    [Interface.1.sch]
2015-04-03 Added C30, increased C29. Issue #56. Might not turn out to be what we want, but it's easier to DNP than to have no place to put the component.
    [Chain.2.sch]
2015-04-07 Fix stack conn part # on Driver
    [Driver.3.sch]
2015-04-09 Add description to chain doc.
2015-04-15 Eliminate +3.3D regulator from Video, as it is no longer used.
    [Video.6.sch]
2015-04-16 New Artix pinout.
    [Artix-signal-map.tsv, ArtixPinout.csv]
2015-04-17 VIO for video ADCs is now 2.5V.
    [PerChip.2.sch]
2015-04-17 Damping resistors at intermediate level of clock tree for video ADCs, just in case.
    [PerChip.1.sch]
2015-04-17 Remove extraneous components from video ADC VIO regulator.
    [PerChip.2.sch]
2015-04-17 Fix secondary HK mux for pre-decoded addresses.
    [Interface.3.sch]
2015-04-17 Fix HK select typo.
    [Video.3.sch]
2015-04-17 Video ADC controls now distributed on Video board rather than multiple pins in the stacking connector.
    [Video.1.sch, Video.2.sch, Video.3.sch, Video.4.sch]
2015-04-17 Remove obsolete signals from the Artix pins -> netnames map.
    [Artix-signal-map.tsv]
2015-04-17 Add Kari's debug signals.
    [Artix-signal-map.tsv, ArtixPinout.csv]
2015-04-20 Increase bypass cap on serial clock reg for improved CMRR
    [SerialRegulator.sch]
2015-04-22 Release FFE-6.1-RR4
    [Driver-Cirrexx.tsv, Interface-Cirrexx.tsv, Video-Cirrexx.tsv]
2015-04-24 Run SerialTest sim from +15V, since that's what 6.1 does.
    [SerialTest.sch]
2015-05-07 PSRR improvements (issue #56).
    [SerialRegulator.sch]
2015-05-07 Parallel regulator simulation.
    [3phase.sch, Booster.sch, ParallelPair.sch, ParallelReg.sch, SerialTest.sch]
2015-05-07 Support for parallel simulation
    [lm195.sch]
2015-05-07 Derived circuit file shouldn't have been controlled.
2015-05-07 Current limit and improved bypass for AD5328 chips. Issue #67.
    [DriverSet.4.sch, PerChip.7.sch, PerChip.8.sch, Video.8.sch]
2015-05-07 Fix some resistor specs.
    [Chain.1.sch, Interface.3.sch, Pump.sch]
2015-05-07 Improve parallel regulator stability and PSRR. Issue #68.
    [ParallelReg.sch]
2015-05-07 Add decoupling resistors. Issue #69.
    [PerChip.2.sch, PerChip.5.sch, Video.6.sch]
2015-05-07 Reduce ADC ref voltage. Issue #71.
    [Chain.2.sch]
2015-05-07 Tweak serial sim
    [SerialTest.sch]
2015-05-07 Clock drivers return to +5 rather than +15 for power.
    [DriverSet.1.sch, DriverSet.2.sch, DriverSet.5.sch]
2015-05-07 Split trim heater into three parts. Issue #72.
    [Video.8.sch]
2015-05-07 Better HK scale for trim heater
    [Video.8.sch]
2015-05-07 Change doc to reflect three way heater split.
2015-05-07 Some git cleanup.
    [ParallelTest.sch, RegReg.sch]
2015-05-07 Fix some DRC errors.
    [Video.8.sch]
2015-05-07 New release 6.1-RR5
    [Driver-Cirrexx.tsv, Interface-Cirrexx.tsv, Video-Cirrexx.tsv]
2015-05-12 Use SDPCB's preferred IPC footprints when exporting to PADS.
2015-05-12 More sims.
    [FilterTest.sch, ParallelRegStress.sch, ParallelStress.sch, ParallelTest.sch, SerialStress.sch, lm195.sch]
2015-05-12 Reduce R22 (Issue #74)
    [ParallelReg.sch]
2015-05-12 Option for either Kyocera or Vectron oscillator.
    [Interface.1.sch]
2015-05-13 Chassis connection on Interface. Separate current-limited supply for LVDS buffers.
    [Interface.7.sch]
2015-05-13 Flightish caps on Driver power.
    [Driver.3.sch]
2015-05-13 Remove interface board temp (opamp resused for LVDS regulator).
    [Interface.2.sch]
2015-05-13 Slash in device name is toxic to Allegro flow.
    [Interface.7.sch]
2015-05-13 Add areas of new footprints.
2015-05-13 FPE-6.1-RR6 data products.
    [Driver-Cirrexx.tsv, Interface-Cirrexx.tsv, Video-Cirrexx.tsv]
2015-05-14 More footprint translation.
2015-05-15 Add separate bypass cap for small oscillator.
    [Interface.1.sch]
2015-05-18 Rename MDM9S footprint for PADS.
2015-05-18 FPE-6.1-RR7 release files.
    [Driver-Cirrexx.tsv, Interface-Cirrexx.tsv, Video-Cirrexx.tsv]
2015-05-19 IPC footprints for Video.
2015-05-20 RR8 with updated PADS footprints.
    [Driver-Cirrexx.tsv, Interface-Cirrexx.tsv, Video-Cirrexx.tsv]
2015-05-21 Fix power input pins to match the DHU.
    [Interface.7.sch]
2015-05-21 FPE-6.1-RR9 files.
    [Driver-Cirrexx.tsv, Interface-Cirrexx.tsv, Video-Cirrexx.tsv]
2015-05-27 Change C5 in ParallelReg to X7R characteristic. Addresses Issue #79.
    [ParallelReg.sch]
2015-05-27 Change C1 in ParallelReg to 0805. Addresses first part of Issue #77.
    [ParallelReg.sch]
2015-05-27 Change 1.0uF cap to 1uF.
    More Issue #77.
    [ParallelReg.sch]
2015-06-08 Added transient analysis to filter test
    [FilterTest.sch]
2015-06-08 Improve parallel stress tests
    [L3.sch, Par3.sch, ParallelStress.sch, ParallelTest.sch]
2015-06-08 Better clock phasing for serial simulation
    [SerialTest.sch]
2015-06-09 Parallel driver stress test.
    [ParallelPair.sch, ParallelReg.sch]
2015-06-23 Fix Issue #80
    [Interface.1.sch]
2015-06-23 CC notices on schematic frames
2015-06-23 Lower case file names (SPICE stupidity).
2015-06-23 RS422 termination. Fixes Issue #85.
    [Interface.1.sch]
2015-06-23 Remove survival heater from Interface. Fixes Issue #87.
    [Interface.7.sch]
2015-06-23 RC filters on sensitive clocks DCK and SCK. Addresses Issue #86.
    [Artix-signal-map.tsv, Interface.1.sch]
2015-06-23 Reduce worst case parallel driver stress. Addresses Issue #83.
    [Booster.sch, ParallelReg.sch]
2015-06-23 Fix refdes conflict.
    [Interface.1.sch]
2015-06-23 AP/R4 is 1206 for power rating (Issue #81)
    [ArtixPower.sch]
2015-06-24 Address Issue #75 by limiting clock swing. This may not be the last word, but it's probably the right topology.
    [SerialRegulator.sch]
2015-06-24 Fix Issue #82.
    [Artix-signal-map.tsv]
2015-06-24 Fix issue #88.
    [Interface.2.sch]
2015-06-26 100pF to stabilize temps
    [Interface.2.sch]
2015-06-26 FPE-6.1-RR10 release files
    [Driver-Cirrexx.tsv, Interface-Cirrexx.tsv, Video-Cirrexx.tsv]
2015-07-02 Fix footprint mapping for SDPCB.
2015-07-21 Recover lost sim driver file. Changes to Artix for 3.3V drive to video switches.
    [ArtixPinout.csv]
2015-07-21 Commit RR11 and modified RR10 releases.
    [Driver-Cirrexx.tsv, Interface-Cirrexx.tsv, Video-Cirrexx.tsv]
2015-07-28 Initial checkin of DAC/HK database files.
    [BiasGroup.tsv, ClockDriverGroup.tsv, HeaterGroup.tsv, ThermalGroup.tsv]
2015-07-29 Add range columns for DAC database files. And a README.
    [BiasGroup.tsv, ClockDriverGroup.tsv, HKmap.tsv, HeaterGroup.tsv, ThermalGroup.tsv]
2015-07-29 New DAC/HK table approach to doc.
    [InterfaceGroup.tsv]
2015-07-31 Fix data file for limited serial swing.
    [ClockDriverGroup.tsv]
2015-07-31 Name dac nets for better plotting of DC sweeps.
    [SerialTest.sch]
2015-07-31 More fixes to the clock driver table.
    [ClockDriverGroup.tsv]
2015-08-03 Increase CCD load current.
    [Chain.1.sch]
2015-08-05 Increase Pump drive for larger load current.
    [Pump.sch, PumpTest.sch]
2015-08-06 Commit RR12 products.
    [Driver-Cirrexx.tsv, Interface-Cirrexx.tsv, Video-Cirrexx.tsv]
2015-08-07 Pump sim work to notebook.
2015-08-07 A little more parallel testing.
    [L3.sch, ParallelTest.sch]
2015-08-07 Update chain for ADA4805 SPICE sim.
    [Chain.1.sch, ChainTest.sch]
2015-08-10 Clean up some simulation rot.
    [ChainNoise.sch, chnoise.sch]
2015-08-12 More cleanup in simulation directory. Added README.
    [opNoise.sch]
2015-08-17 Float commercial osc inhibit pin (Issue #92).
    [Interface.1.sch]
2015-08-18 AE -> FPE
    [3phase.sch, AP.sch, APSC.sch, AlgebraicFilt.sch, Artix-signal-map.tsv, ArtixPinout.csv, ArtixPower.sch, Artix_pinout-Table_1.tsv]
2015-08-19 Route interface temp to stack.
    [Interface.7.sch]
2015-08-19 Revert 6.2 schematic change in master. We'll merge them in later.
    [Interface.7.sch]
2015-08-19 Add temperature monitors for Interface and Driver boards (Issue #93).
    Add monitor for +3.3F on Interface,
    GND potential on Video and Driver.
    Document the one remaining open circuit HK channel
    as "HK Zero Point".
    [Driver.3.sch, HeaterGroup.tsv, Interface.2.sch, InterfaceGroup.tsv, Video.8.sch]
2015-08-20 Increase pump resistor ratings to address issue #91.
    [Pump.sch]
2015-08-20 Fix footprints for video R41 and R45. Addresses issue #89.
    [Video.6.sch]
2015-08-25 Remove R73 to fix issue #94.
    [Interface.7.sch]
2015-08-26 Pretty printing binary output for sequences
2015-09-02 Introducing framework for talking to the DHU
2015-09-03 Switching from .mem to .bin
2015-09-04 Fix signs of housekeeping in data tables. Fix serial clock control range.
    [BiasGroup.tsv, ClockDriverGroup.tsv, HeaterGroup.tsv, InterfaceGroup.tsv]
2015-09-09 Fix fossil line in HK data table
    [ClockDriverGroup.tsv]
2015-09-09 Change RG positive rail from +15 to +5. Addresses issue #95.
    [DriverSet.2.sch]
2015-09-09 Remove spurious/extra spec attributes from video. Addresses Issue #89.
    [Chain.1.sch, Chain.2.sch, DrainRegulator.sch, PerChip.2.sch, PerChip.3.sch, PerChip.4.sch, PerChip.5.sch, Pump.sch]
2015-09-09 Remove spurious/extra spec attributes from Interface and Driver. Addresses Issue #89.
    [DriverSet.3.sch, Interface.1.sch, Interface.2.sch, Interface.3.sch]
2015-09-09 Change cap package/ratings. Issue #65.
    [Driver.3.sch, PerChip.2.sch, PerChip.3.sch, PerChip.4.sch, PerChip.5.sch, PerChip.6.sch, Video.6.sch]
2015-09-10 Fixed nonstandard values and inconsistent spec.
    [Chain.1.sch, Chain.2.sch, DrainRegulator.sch]
2015-09-10 Fix/consoloidate cap specs.
    [Interface.7.sch, ParallelReg.sch, PerChip.2.sch]
2015-09-10 One more cap spec to merge.
    [Driver.3.sch]
2015-09-10 Recover schematic broken by merge.
    [Interface.7.sch]
2015-09-10 Add IBTEMP to stack connector.
2015-09-10 Fix slot error on driver board
    [Driver.3.sch]
2015-09-10 Footprints compatible with flight parts.
    [Chain.1.sch, PerChip.5.sch]
2015-09-10 Release files for FPE-6.2-RR1
    [Driver-Cirrexx.tsv, Interface-Cirrexx.tsv, Video-Cirrexx.tsv]
2015-09-14 Fix name of IBTEMP net
    [Interface.7.sch]
2015-09-18 Default parameters file.
    [DefaultParameters.tsv]
2015-09-19 Setting up operating parameters as an object in the fpe object
    [DefaultParameters.tsv]
2015-09-20 Improving timing so that it prints all of the sequence diagrams by default
2015-09-21 Adding secret housekeeping data fields
    [HeaterGroup.tsv, InterfaceGroup.tsv]
2015-09-22 Add page 5 of Driverset to doc. Remove red TBD text.
2015-09-22 List unused HK as HK bias.
    [HeaterGroup.tsv, InterfaceGroup.tsv]
2015-09-22 Update doc for 6.2 release.
    [BiasGroup.tsv, ClockDriverGroup.tsv, HeaterGroup.tsv]
2015-09-22 Fix parallel high range in table.
    [ClockDriverGroup.tsv]
2015-09-22 Change part number for stacking connectors.
    [Driver.3.sch, Interface.1.sch]
2015-09-22 Fix footprint for stats right.
2015-09-24 Address issue #98
    [Chain.2.sch, PerChip.5.sch]
2015-09-30 Options for driver voltage ranges.
    [DriverSet.2.sch, DriverSet.4.sch, DriverSet.5.sch, ParallelReg.sch]
2015-10-01 Introducing test for checking the housekeeping voltages
2015-10-06 First draft of FPGA reset circuit
    [Reset.sch, ResetTest.sch]
2015-10-06 Requested changes for RR4.
    [Driver.3.sch, DriverSet.4.sch, Interface.1.sch, Interface.7.sch, Reset.sch, ResetTest.sch]
2015-10-06 Added 100k pullup on reset circuit in.
    [Reset.sch]
2015-10-06 Add reset schematic to documentation.
2015-10-08 Address issue #79
    [ParallelReg.sch]
2015-10-08 Address issue #66.
    [Chain.1.sch]
2015-10-08 Placeholder footprint for REF43, issue #118
2015-10-08 More specific footprint for RS422 rx. Issue #119
    [Interface.1.sch]
2015-10-08 Placeholder footprints on MOSFETs. Issue #117
2015-10-08 Fix PMBTA92 footprints. Issue #113.
    [PerChip.5.sch]
2015-10-08 Stats for placeholder packages. Add some text on reset circuit to doc.
2015-10-14 Changing offset operating parameters to have names that reflect this, expressing derived operating parameters
    [BiasGroup.tsv, ClockDriverGroup.tsv, DefaultParameters.tsv]
2015-10-16 Adding ranges for operating parameters
    [BiasGroup.tsv, ClockDriverGroup.tsv]
2015-11-07 Route power to *all* video chains from VS.
    [Chain.2.sch]
2015-11-07 Don't map UB footprints.
2015-11-12 Doubled 1 ohm for half ohm
    [DriverSet.4.sch]
2015-11-12 New release with doubled 1 ohm
2015-12-17 No longer starting and stopping frames
2015-12-21 Yet another oscillator
    [Interface.1.sch]
2015-12-30 Starting and stopping frames again for legacy wrappers
2016-01-26 Using 100 samples now for the bias test
2016-01-28 Tracking whether frames are running, trying to isolate scripts for controlling if frames are running
2016-02-08 Restoring functionality to 6.1 boards
2016-02-08 Offset operating parameters have "Offset" in their name.
    [BiasGroup.tsv, ClockDriverGroup.tsv]
2016-02-12 Introducing hardware reset switch script
2016-02-12 Improving switch control script
2016-02-16 Fixing load_wrapper so it prints properly to stdout
2016-02-22 Reverting FPE directory to 6.1
    [BiasGroup.tsv, Chain.1.sch, Chain.2.sch, ClockDriverGroup.tsv, DrainRegulator.sch, Driver.3.sch, DriverSet.2.sch, DriverSet.3.sch]
2016-02-23 Debugging 6.2 board
2016-03-01 Switching on "Resetting Cam FPGA"
2016-03-01 Switching on proper FPGA reset command
